yannickbock/dual_cr1750_cr1780_ct1740/hardware/cr-17xx-psu-board/pictures/01.jpg

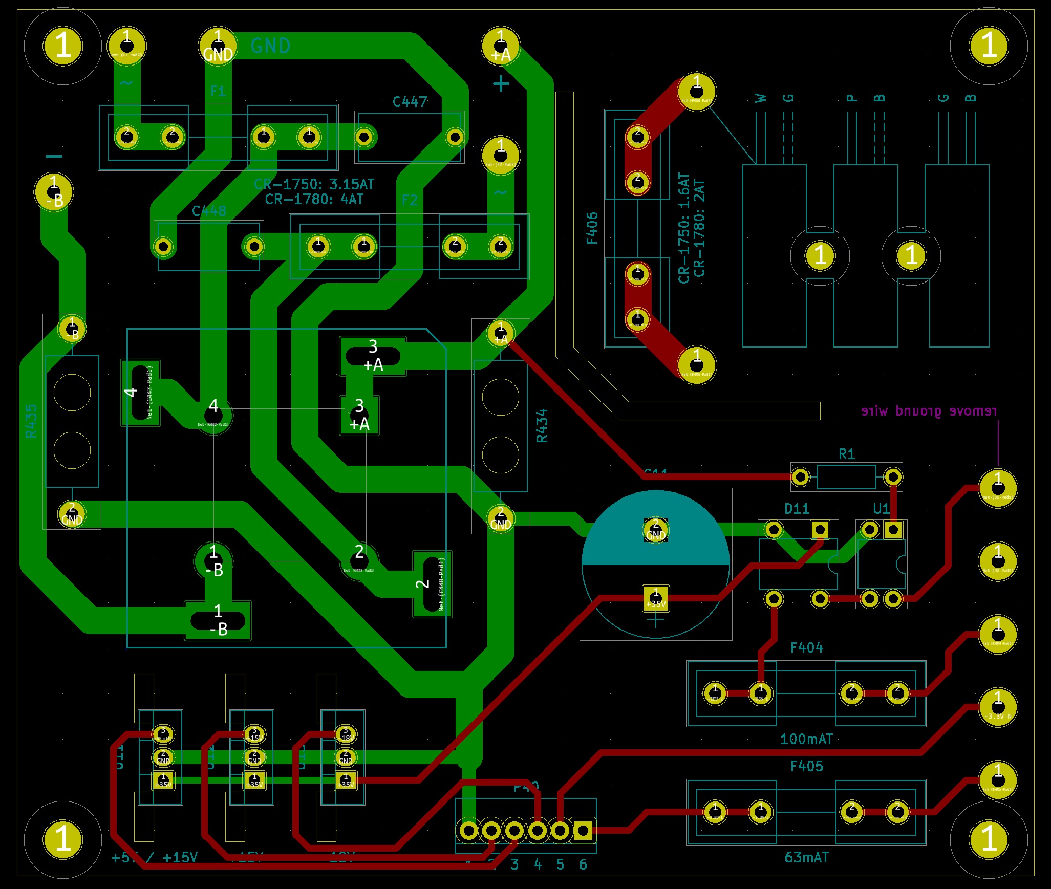
hardware/cr-17xx-psu-board/pictures/01.jpg
