yannickbock/dual_cr1750_cr1780_ct1740/hardware/ct-1740-psu-board/pictures/03.jpg

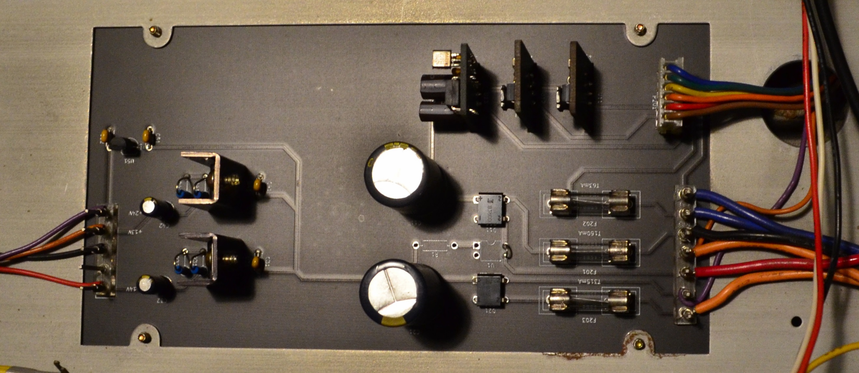
hardware/ct-1740-psu-board/pictures/03.jpg
