yannickbock/dual_cr1750_cr1780_ct1740/hardware/display-board/pictures/01.jpg

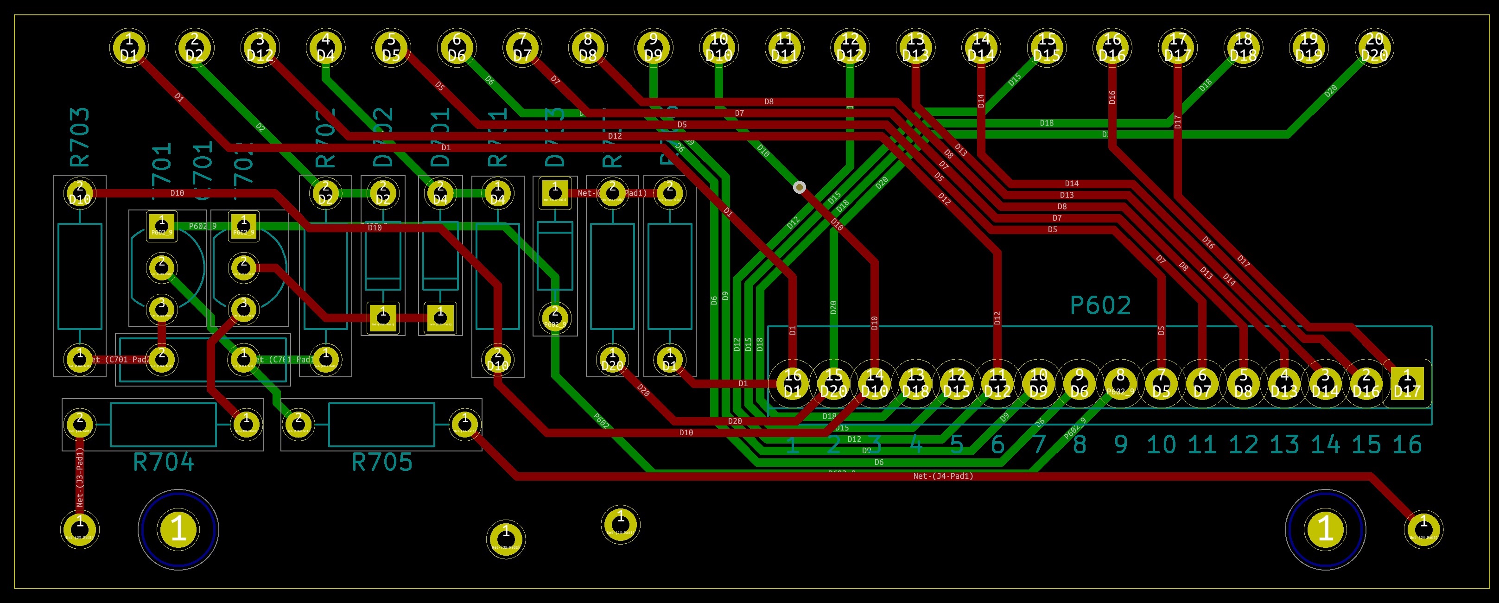
hardware/display-board/pictures/01.jpg
