yannickbock/dual_cr1750_cr1780_ct1740/hardware/psu-module-negative/pictures/02.jpg

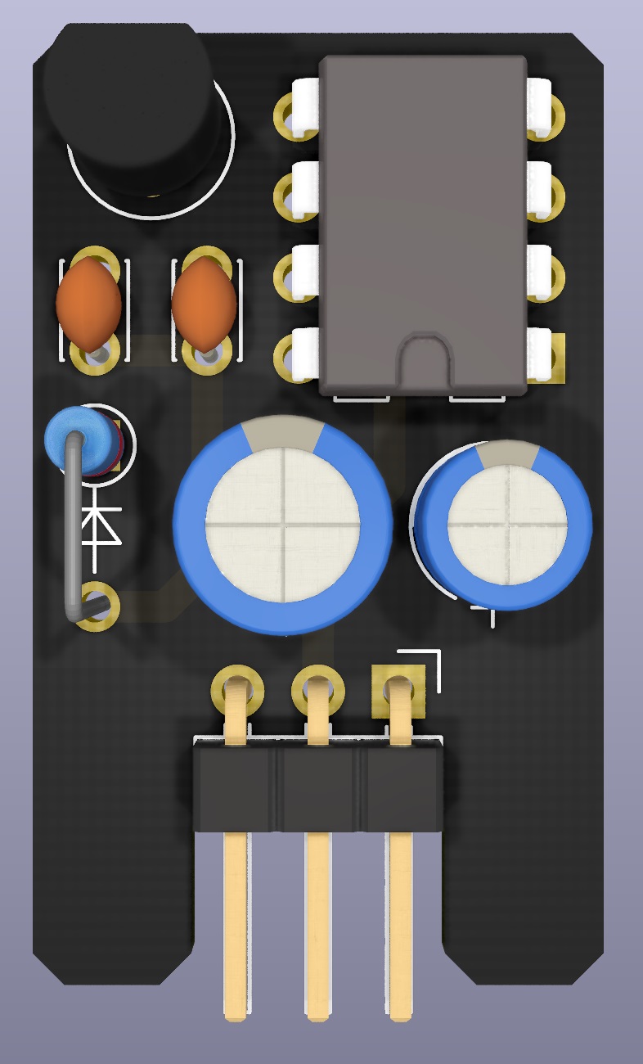
hardware/psu-module-negative/pictures/02.jpg
