yannickbock/dual_cr1750_cr1780_ct1740/hardware/psu-module-positive_BL9342/pictures/01.jpg

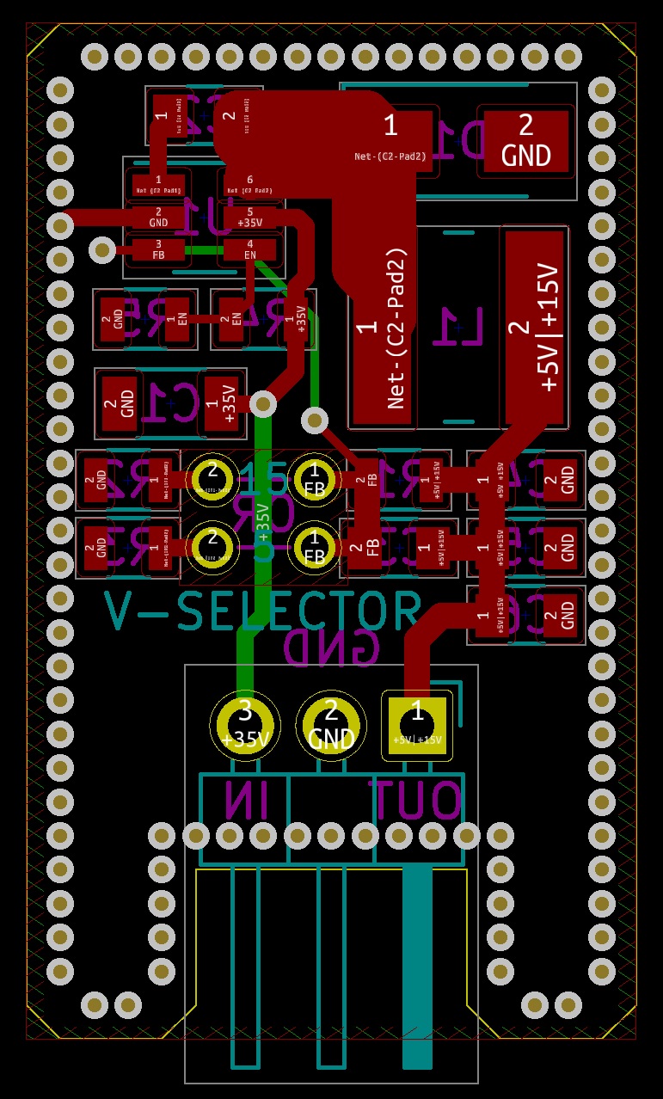
hardware/psu-module-positive_BL9342/pictures/01.jpg
