yannickbock/dual_cr1750_cr1780_ct1740/hardware/synthesizer-board/pictures/01.jpg

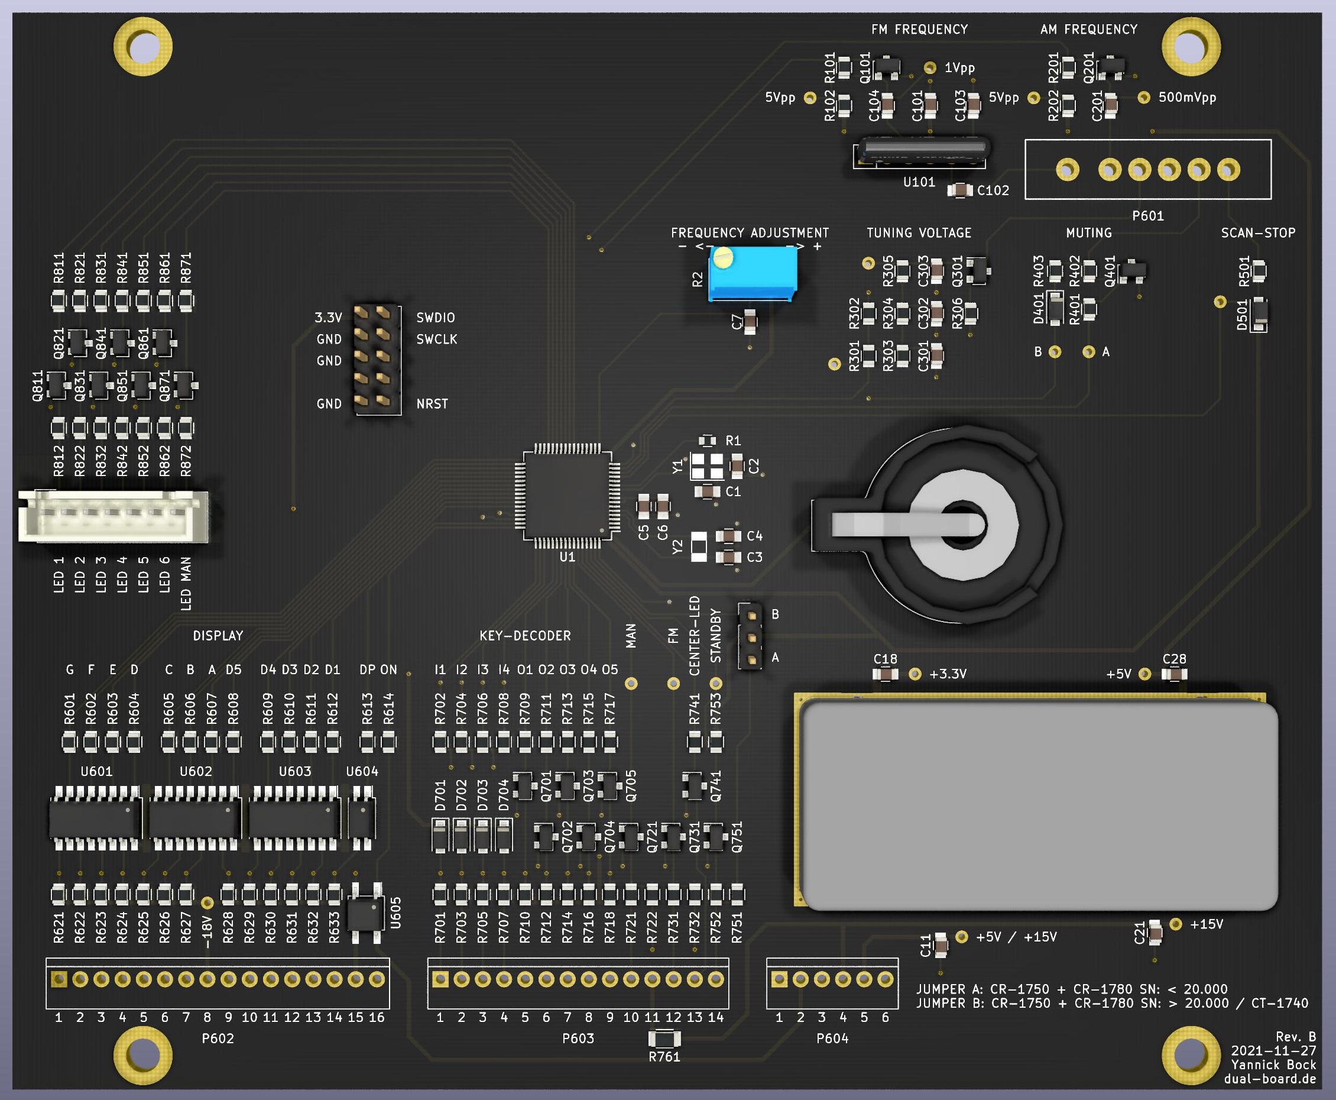
hardware/synthesizer-board/pictures/01.jpg
