yannickbock/dual_cr1750_cr1780_ct1740/hardware/cr-17xx-psu-preamp-board/User Library-Clips FH-100 with fuse 5x20.STEP

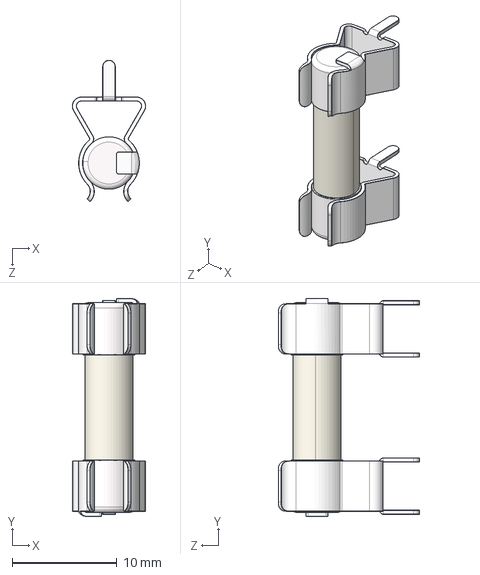
[picture p17: CAD file, 2022-03-17]
hardware/cr-17xx-psu-preamp-board/User Library-Clips FH-100 with fuse 5x20.STEP
7.00 x 20.8 x 13.5 mm
FH-100 x 2
5x20
