yannickbock/dual_cr1750_cr1780_ct1740/hardware/psu-module-negative/psu-module-negative.step

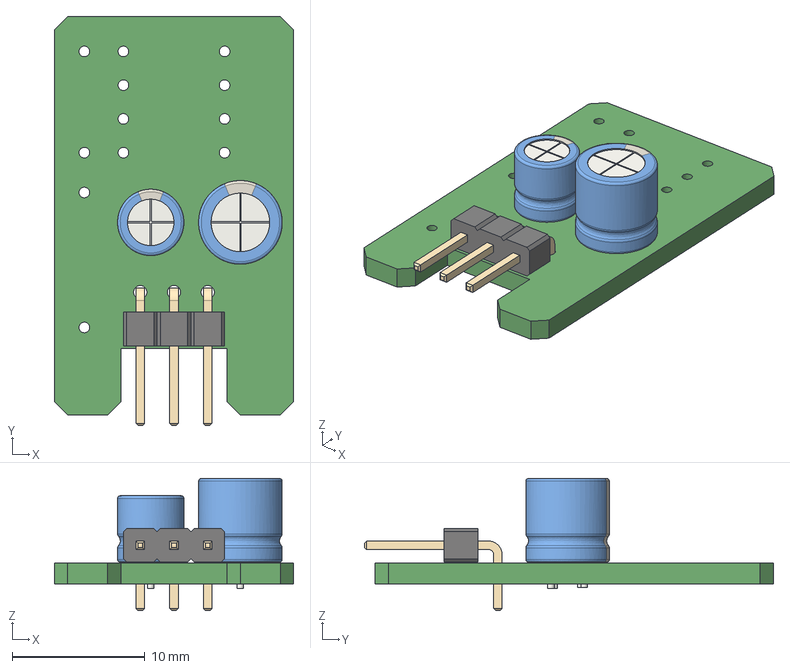
[picture p18: CAD file, 2021-11-16]
hardware/psu-module-negative/psu-module-negative.step
18.0 x 30.8 x 9.94 mm
D_DO-35_SOD27_P7.62mm_Horizontal
DIP-8_W7.62mm
R_Axial_DIN0207_L6.3mm_D2.5mm_P10.16mm_Horizontal
