yannickbock/dual_cr1750_cr1780_ct1740/hardware/psu-module-positive_BL9342/psu-module-positive.step

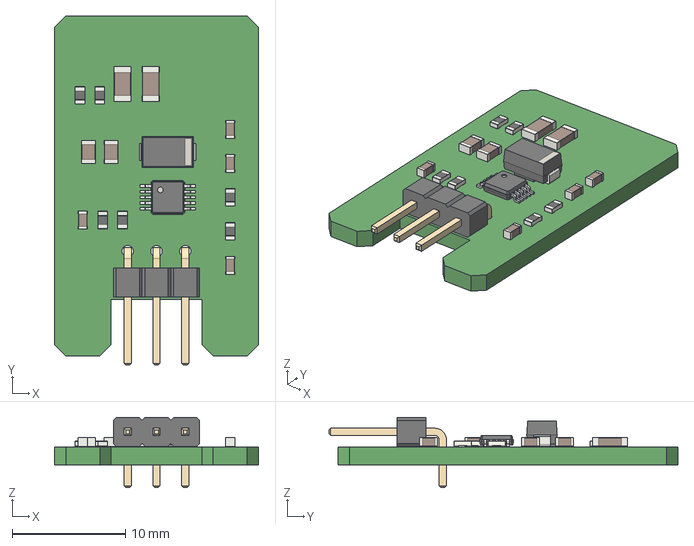
[picture p19: CAD file, 2021-11-16]
hardware/psu-module-positive_BL9342/psu-module-positive.step
18.0 x 30.8 x 6.18 mm
