yannickbock/dual_cr1750_cr1780_ct1740/hardware/synthesizer-board/bluetooth-board.step

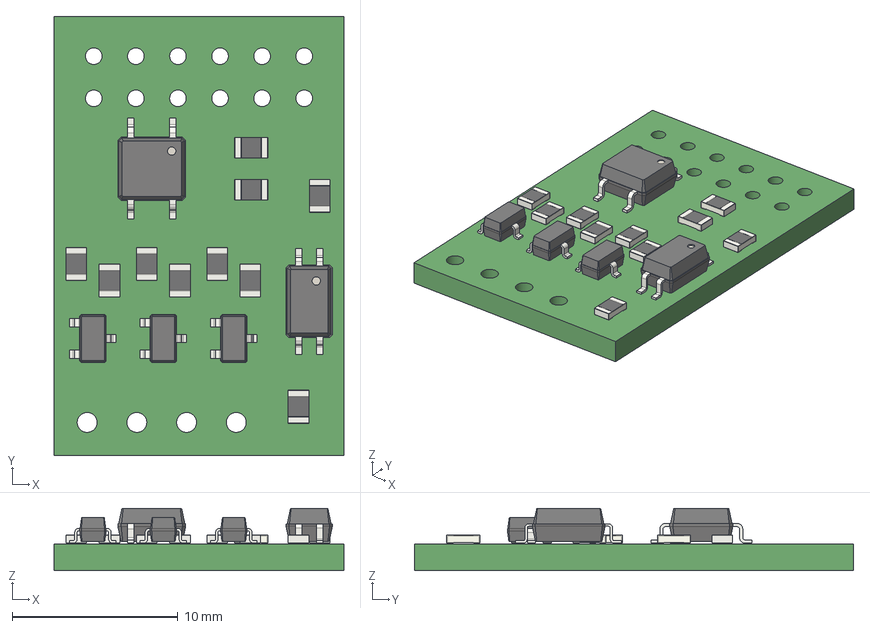
[picture p20: CAD file, 2022-03-17]
hardware/synthesizer-board/bluetooth-board.step
17.5 x 26.5 x 3.75 mm
Socket_Strip_Straight_2x06_Pitch2.54mm
