yannickbock/dual_cr1750_cr1780_ct1740/hardware/cr-17xx-psu-preamp-board/User Library-Custom standoff 1.STEP

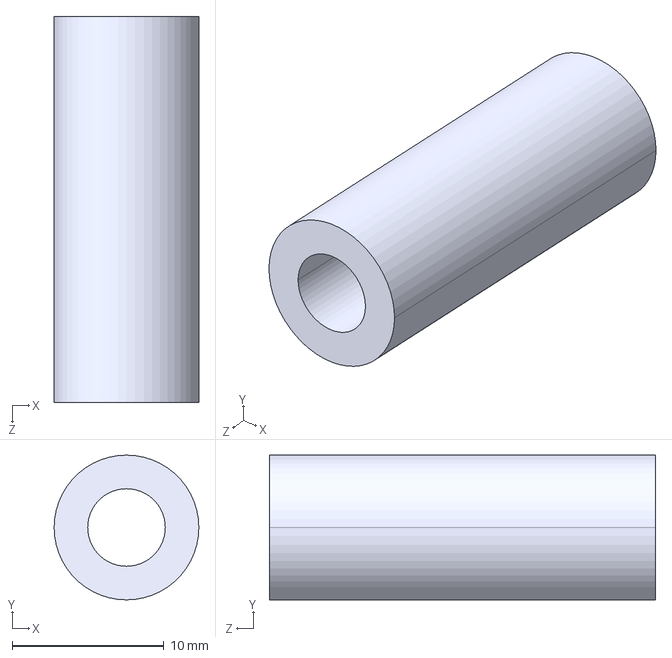
[picture p21: CAD file, 2022-03-17]
hardware/cr-17xx-psu-preamp-board/User Library-Custom standoff 1.STEP
9.52 x 9.52 x 25.4 mm
