yannickbock/dual_cr1750_cr1780_ct1740/hardware/synthesizer-board/MS544-10S.step

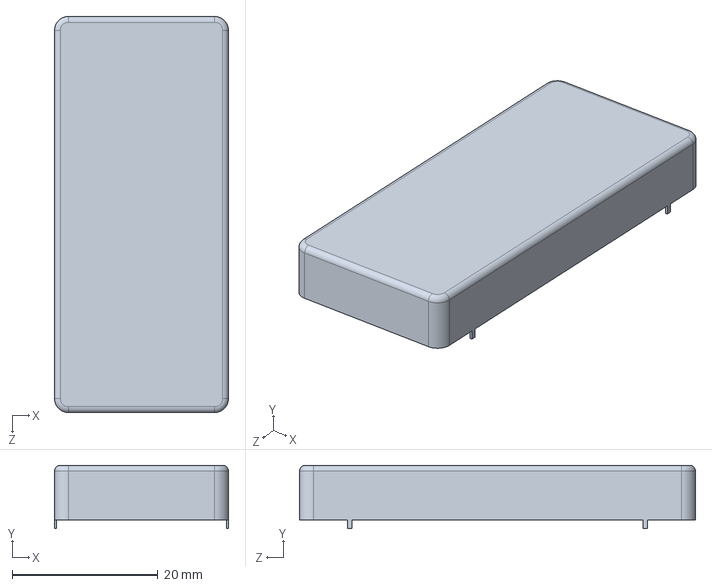
[picture p22: CAD file, 2021-12-21]
hardware/synthesizer-board/MS544-10S.step
23.9 x 8.70 x 54.4 mm
