yannickbock/dual_cr1750_cr1780_ct1740/manuals/netzteil_platine_ct1740.docx

Austausch der Netzteil-Platine

DUAL CT-1740

1. Original Platine ausbauen

Ein Stecker und zwei Wire-Wrap-Terminal müssen ausgelötet werden, danach die 4 Schrauben lösen und Platine rausnehmen.

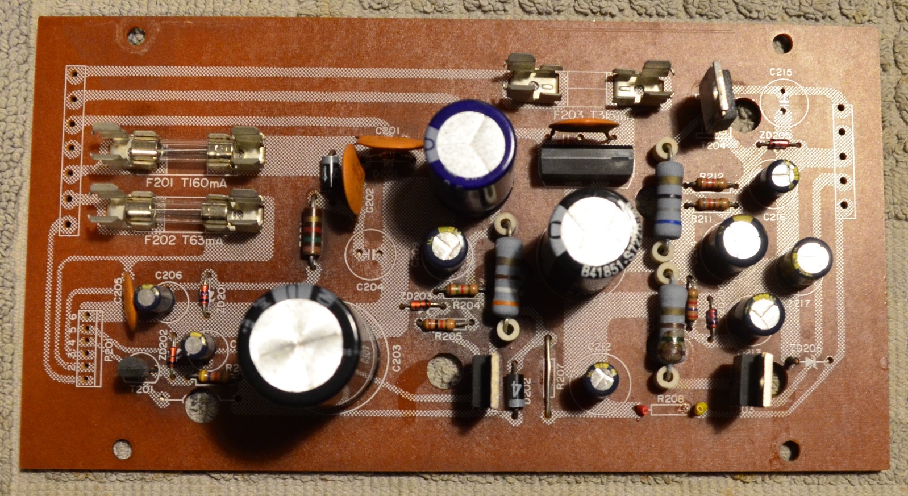
[picture p23: figure]

2. Spannungsregler einlöten

Die beiden Kühlkörper von der Original-Platine übernehmen und anschließend die Spannungsregler einlöten.

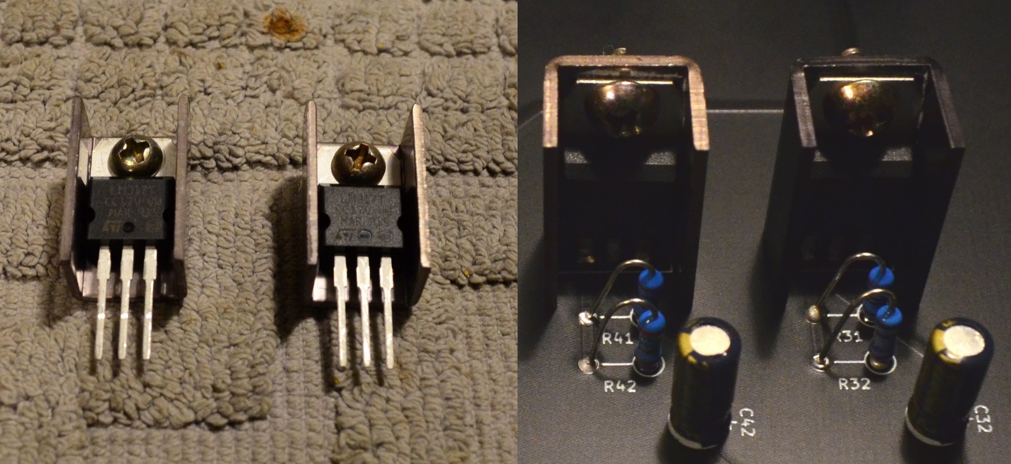
[picture p24: figure]

3. Neue Platine einbauen

Die 4 Schrauben anziehen, anschließend den Stecker und die beiden Wire-Wrap-Terminals einlöten.

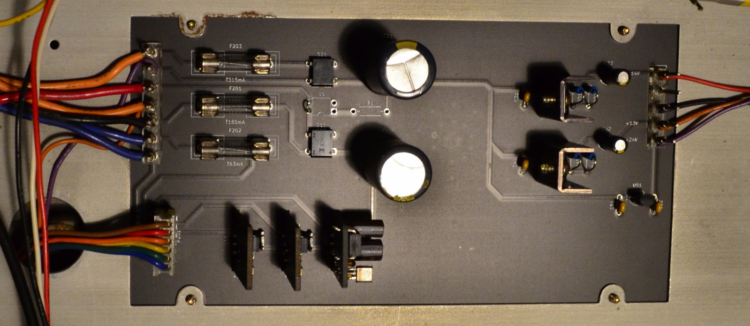
[picture p25: figure]

Yannick Bock / 20.12.2021 / dual-board.de
