yannickbock/dual_cr1750_cr1780_ct1740/manuals/netzteil_platine_cr17x0.pdf

# Austausch der Netzteil-Platine

# DUAL CR-1750 / CR-1780

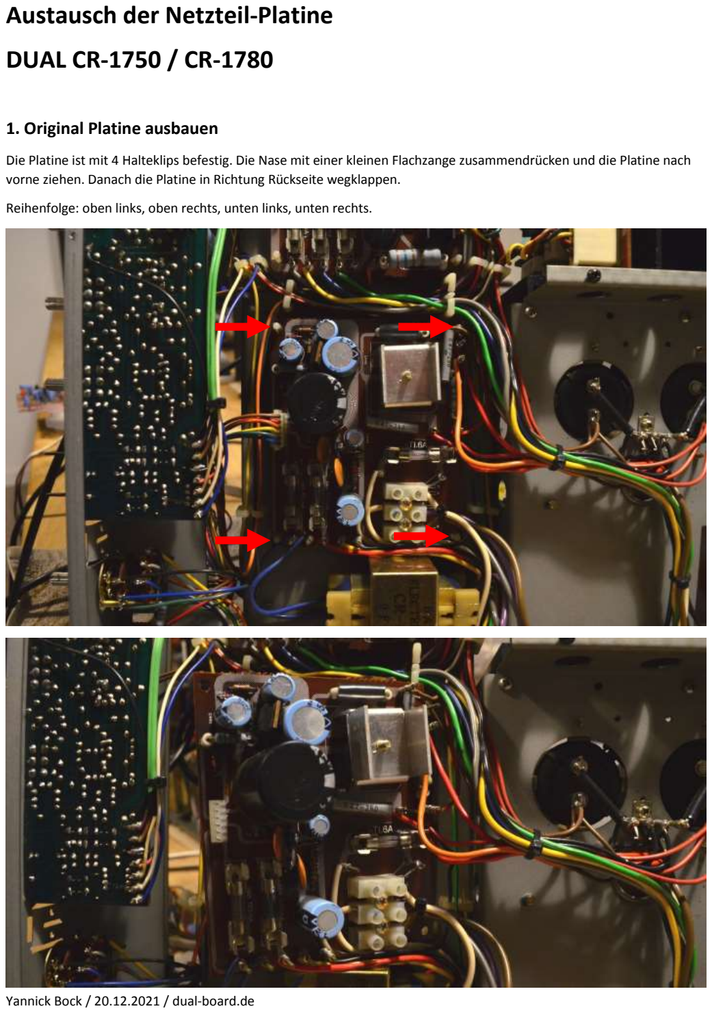
[picture p26: page 1]

Yannick Bock / 20.12.2021 / dual-board.de

### 1. Original Platine ausbauen

Die Platine ist mit 4 Halteklips befestig. Die Nase mit einer kleinen Flachzange zusammendrücken und die Platine nach vorne ziehen. Danach die Platine in Richtung Rückseite wegklappen.

Reihenfolge: oben links, oben rechts, unten links, unten rechts.

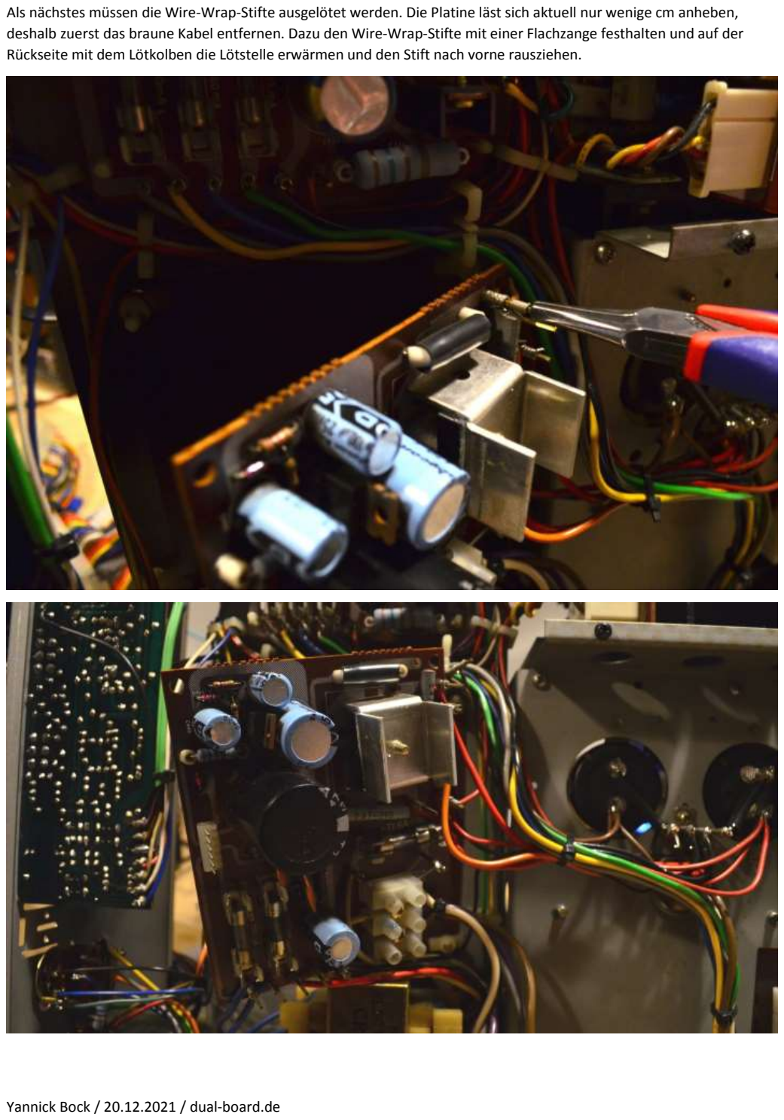
[picture p27: page 2]

Als nächstes müssen die Wire-Wrap-Stifte ausgelötet werden. Die Platine läst sich aktuell nur wenige cm anheben, deshalb zuerst das braune Kabel entfernen. Dazu den Wire-Wrap-Stifte mit einer Flachzange festhalten und auf der Rückseite mit dem Lötkolben die Lötstelle erwärmen und den Stift nach vorne rausziehen.

Die 4 restlichen Wire-Wrap-Stifte neben dem Gleichrichter auslöten. Die Platine läst sich jetzt nach unten wegklappen. Danach die 5 Wire-Wrap-Stifte überhalb des Trafos sowie den Wire-Wrap-Stift links neben der Lüsterklemme auslöten.

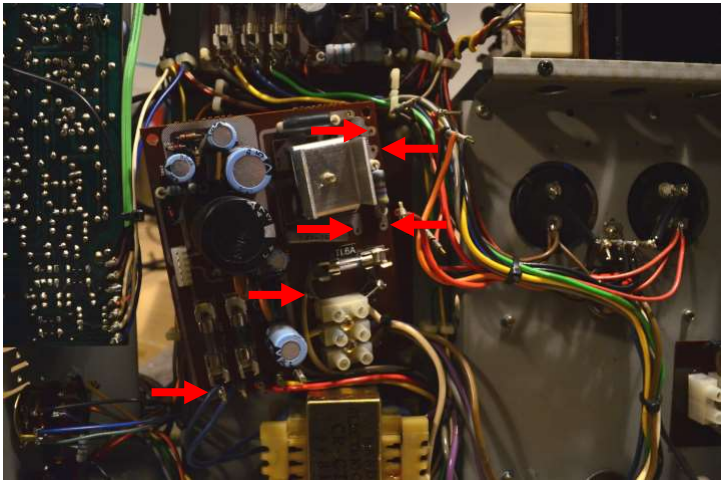
[picture p28: figure]
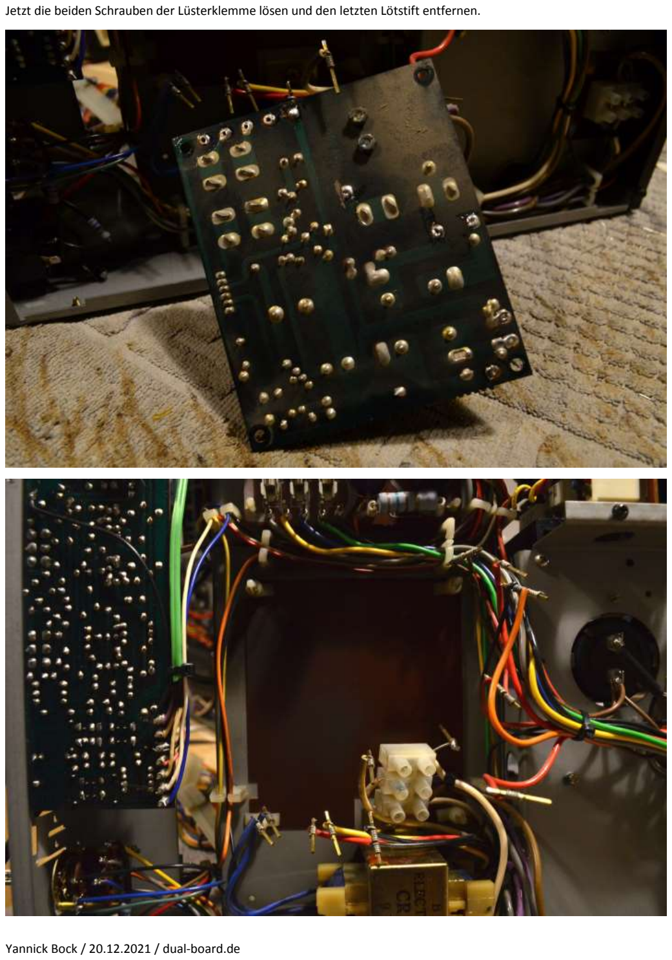
[picture p29: page 4]

Jetzt die beiden Schrauben der Lüsterklemme lösen und den letzten Lötstift entfernen.

### 2. Masseverbindung entfernen

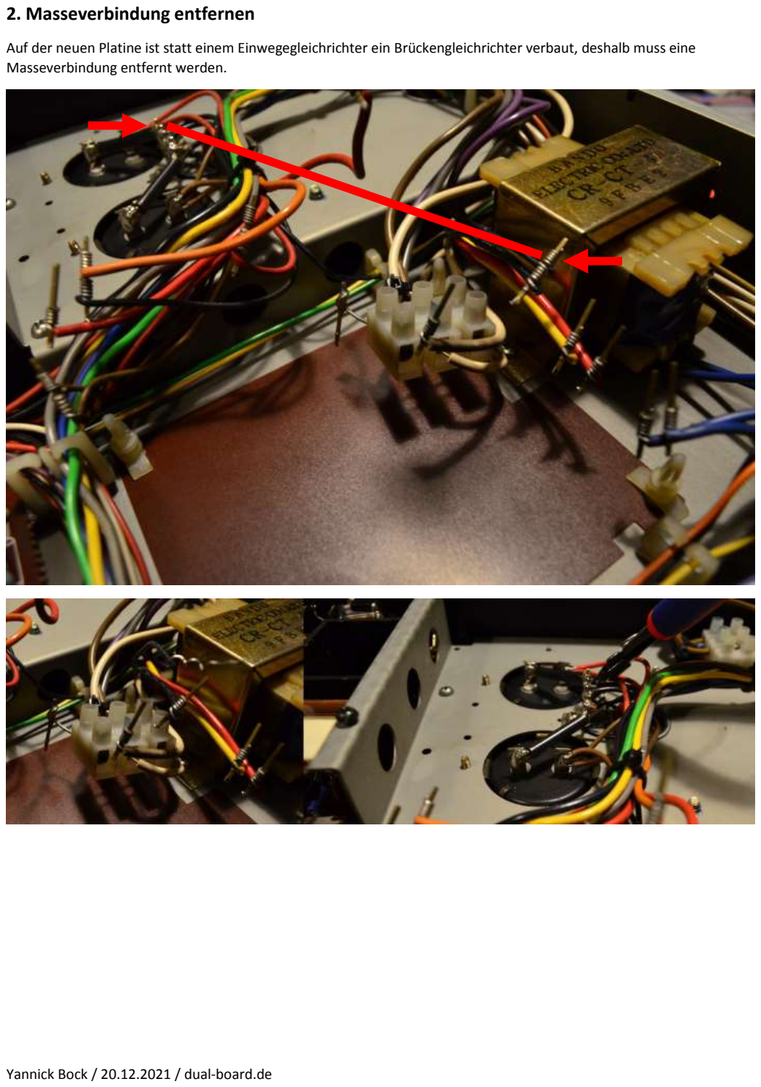
[picture p30: page 5]

Auf der neuen Platine ist statt einem Einwegegleichrichter ein Brückengleichrichter verbaut, deshalb muss eine Masseverbindung entfernt werden.

### 3. Bauteile übernehmen

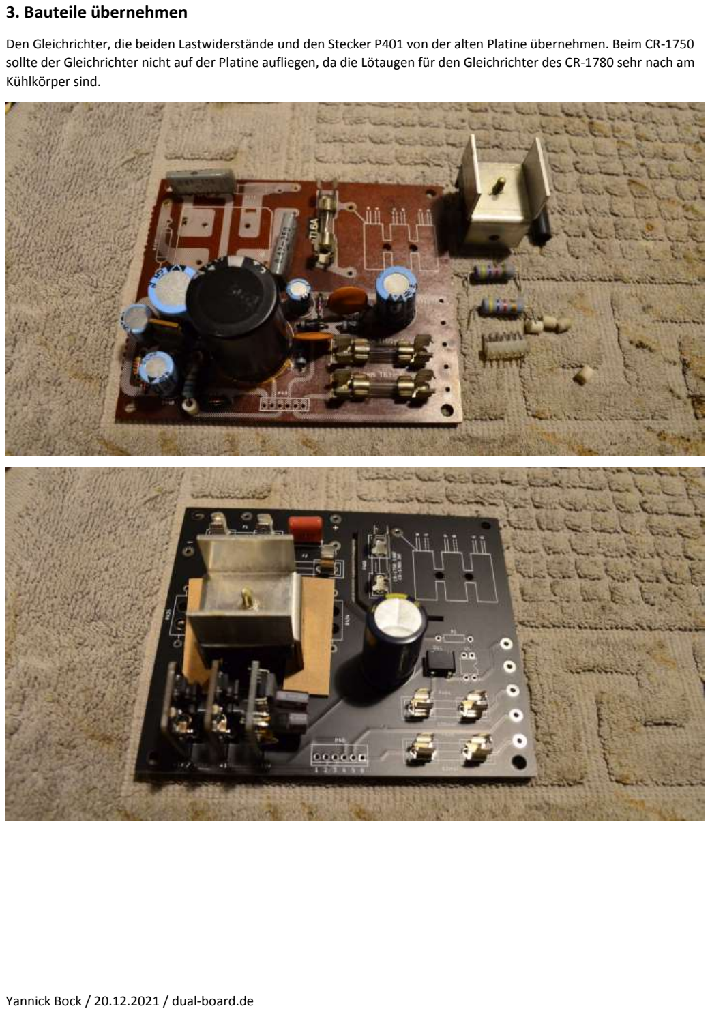
[picture p31: page 6]

Den Gleichrichter, die beiden Lastwiderstände und den Stecker P401 von der alten Platine übernehmen. Beim CR-1750 sollte der Gleichrichter nicht auf der Platine aufliegen, da die Lötaugen für den Gleichrichter des CR-1780 sehr nach am Kühlkörper sind.

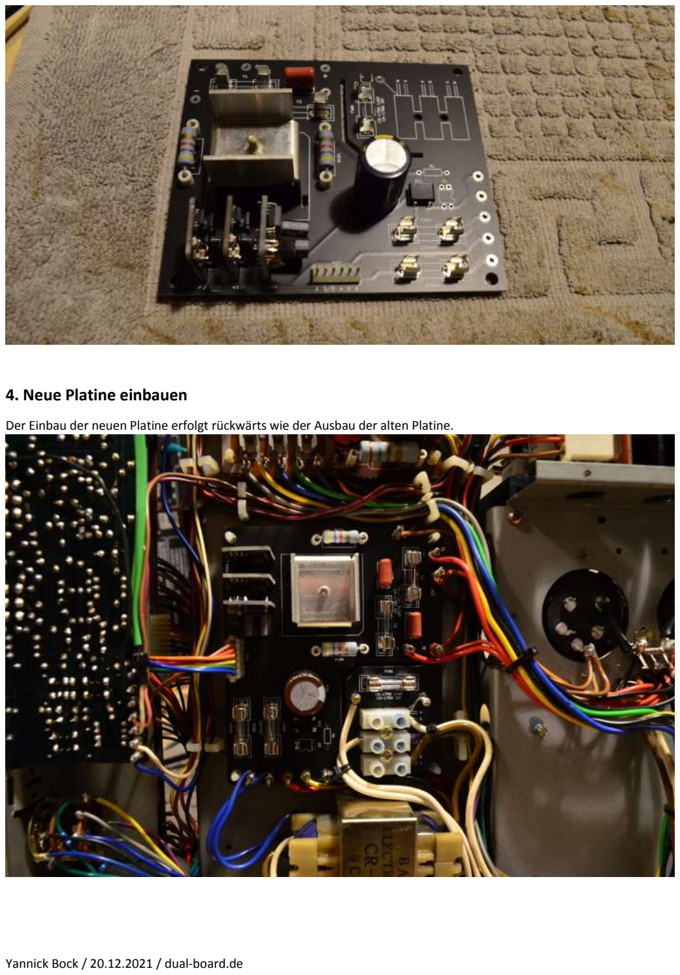
[picture p32: page 7]

### 4. Neue Platine einbauen

Der Einbau der neuen Platine erfolgt rückwärts wie der Ausbau der alten Platine.
