yannickbock/dual_cr1750_cr1780_ct1740/manuals/display_platine.docx

Austausch der Display-Platine

DUAL CR-1750 / CR-1780 / CT-1740

1. Stecker abziehen

5 Stecker müssen abgezogen werden, bei den beiden linken Steckern sind Schnapp-Nasen vorhanden.

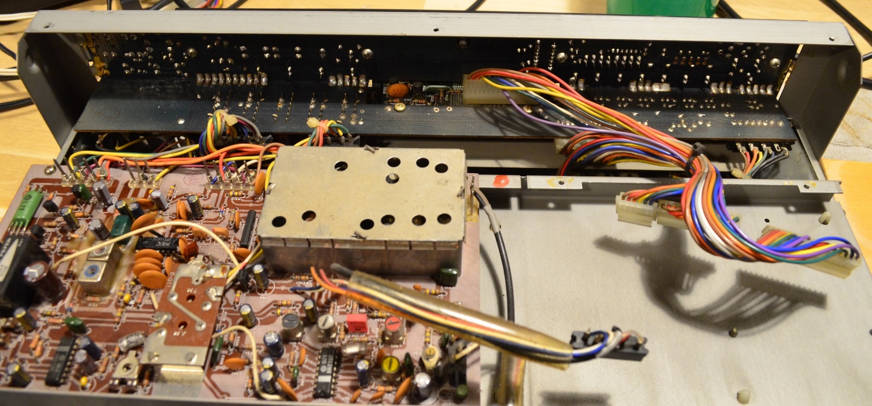
[picture p43: figure]

2. Bedieneinheit ausbauen

4 Schrauben lösen, dann komplette Einheit nach links-vorne rausziehen.

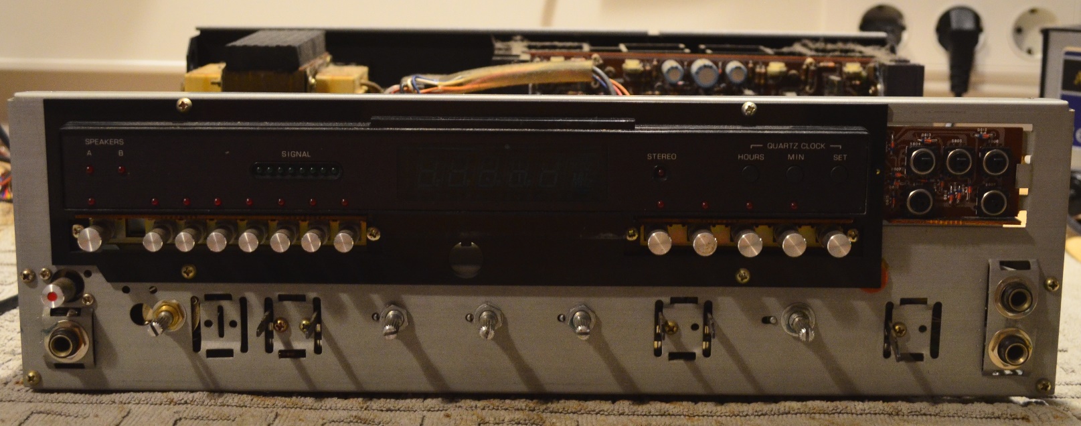
[picture p44: figure]

3. Kunstoffblende entfernen

4 Schrauben auf der Rückseite

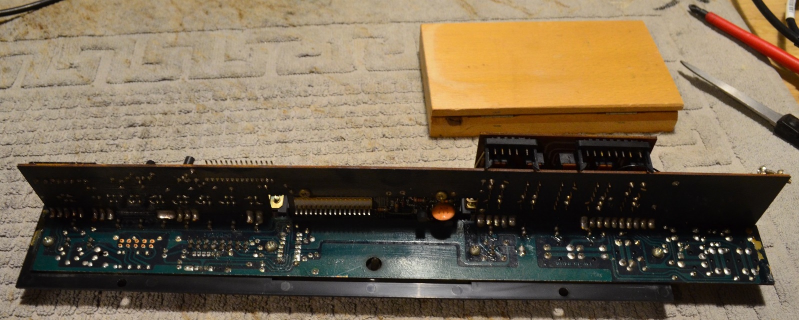
[picture p45: figure]

4 Schrauben auf der Vorderseite

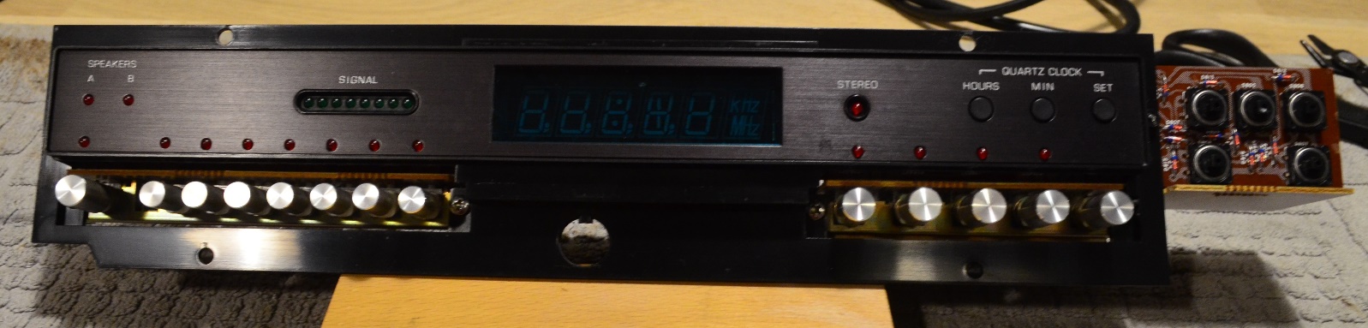
[picture p46: figure]

4. Display-Platine ausbauen

2 Schrauben und 2 bzw. 4 Lötverbindungen lösen, Platine nach vorne rausnehmen

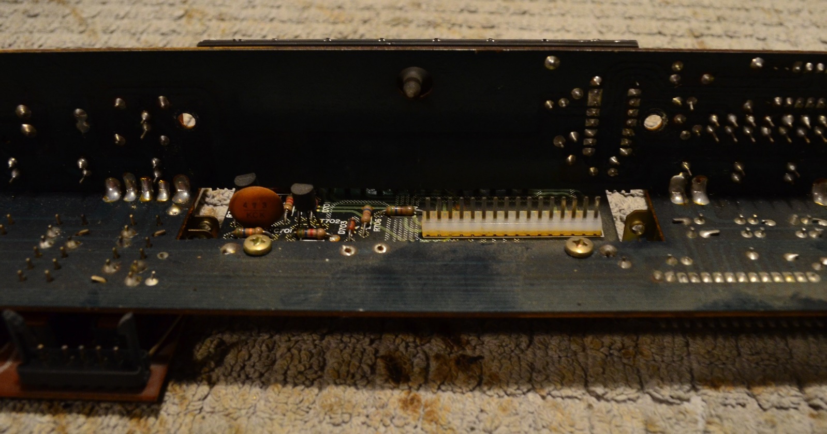
[picture p47: figure]

5. Bauteile auf neue Platine übernehmen

1. Display auslöten. Achtung: Nicht minutenlang an einem Pin rumbraten!

2. Stecker, Keramik-Kondensator und Transistoren auslöten

3. Widerstände und Dioden nacheinander auslöten und auf der neuen Platine einlöten

4. Stecker, Keramik-Kondensator, Transistoren und Display einlöten.

Tipp: Stecker vorher mit Brennspiritus und Zahnbürste reinigen, danach mit Wasser abspülen und trocknen lassen.

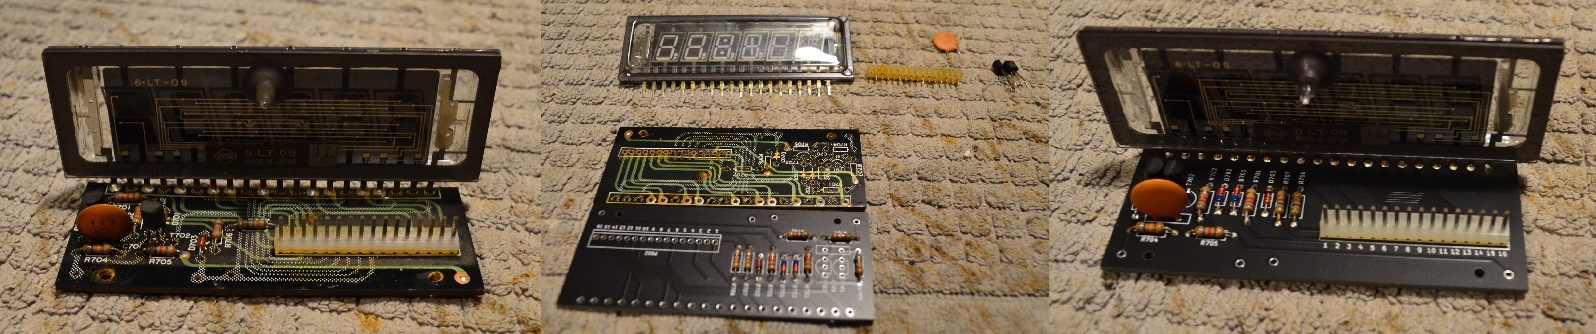
[picture p48: figure]

6. Display-Platine einbauen

Zuerst die beiden Schrauben handfest anziehen, dann die beiden Lötverbindungen neben den Schrauben wiederherstellen.

Tipp: Die beiden großen zusammengelöteten Platinen mit Brennspiritus und Zahnbürste reinigen, danach mit Wasser abspülen und trocknen lassen. Evtl. mehrfach wiederholen. Papierabstandshalter vorher entfernen, eine LED muss dazu ausgelötet werden.

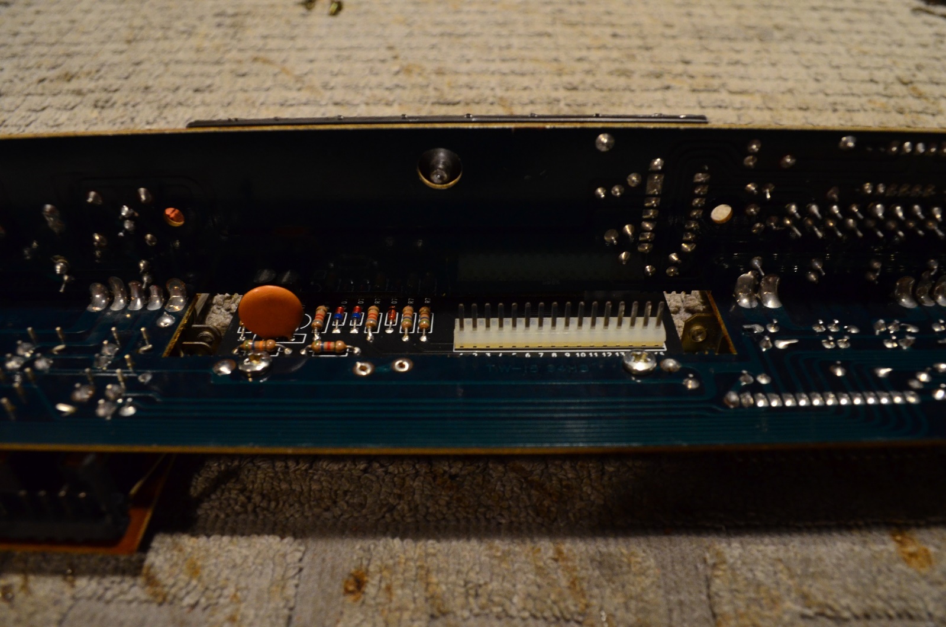
[picture p49: figure]

7. Kunstoffblende zusammenbauen

4 Schrauben auf der Vorderseite. Achtung: Unbedingt zuerst diese Schrauben, sonst schleifen die Schalter nachher!

4 Schrauben auf der Rückseite.

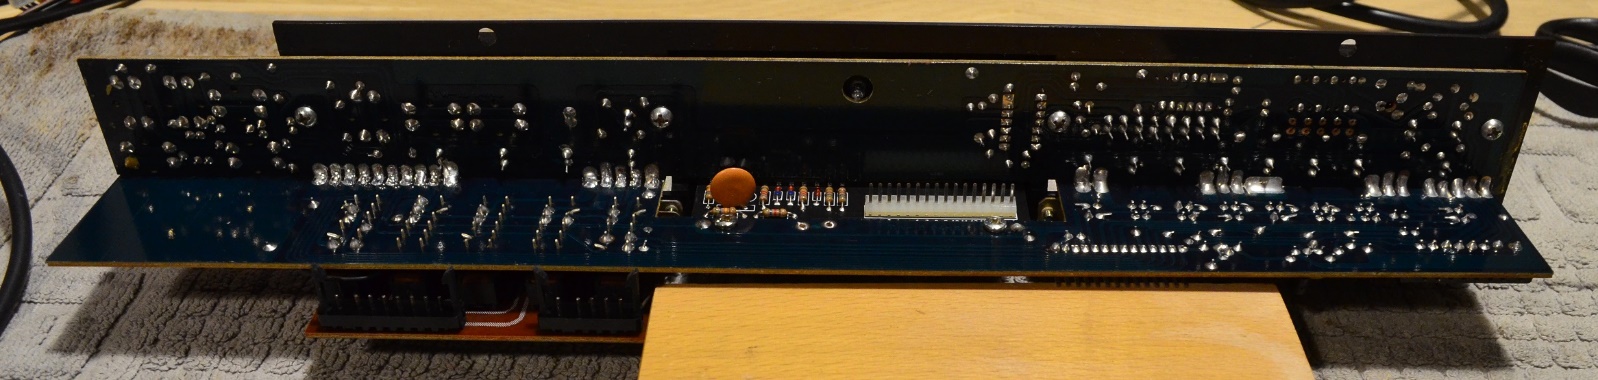
[picture p50: figure]

8. Bedieneinheit einbauen

Achtung: Schrauben nur leicht anziehen, sonst läst sich die Frontblende nicht montieren!

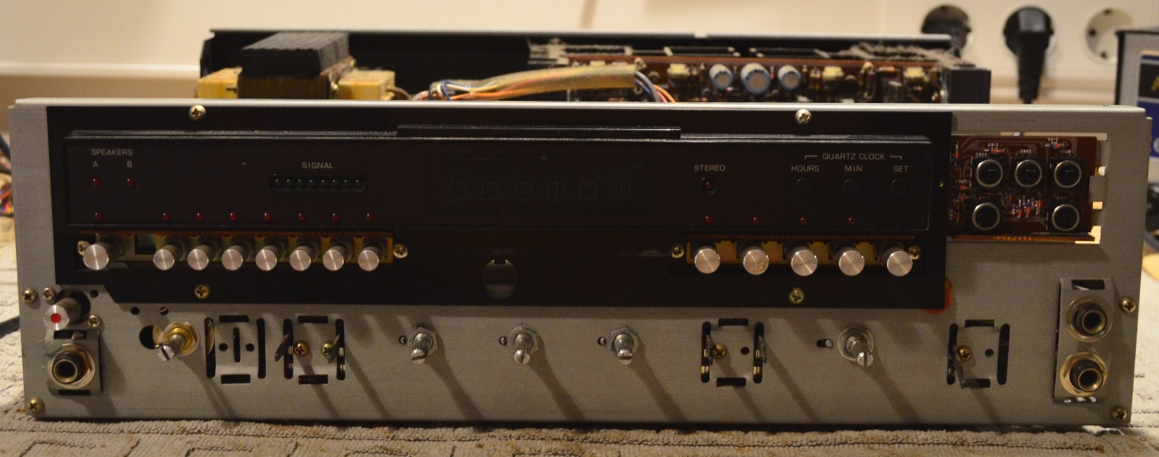
[picture p51: figure]

9. Schaumstoff ersetzen

Der Schaumstoff hinter den SCAN und TUNING Tasten ist in der Regel zerbröselt und sollte ersetzt werden.

Tipp: 4 mm starker selbstklebender Filz

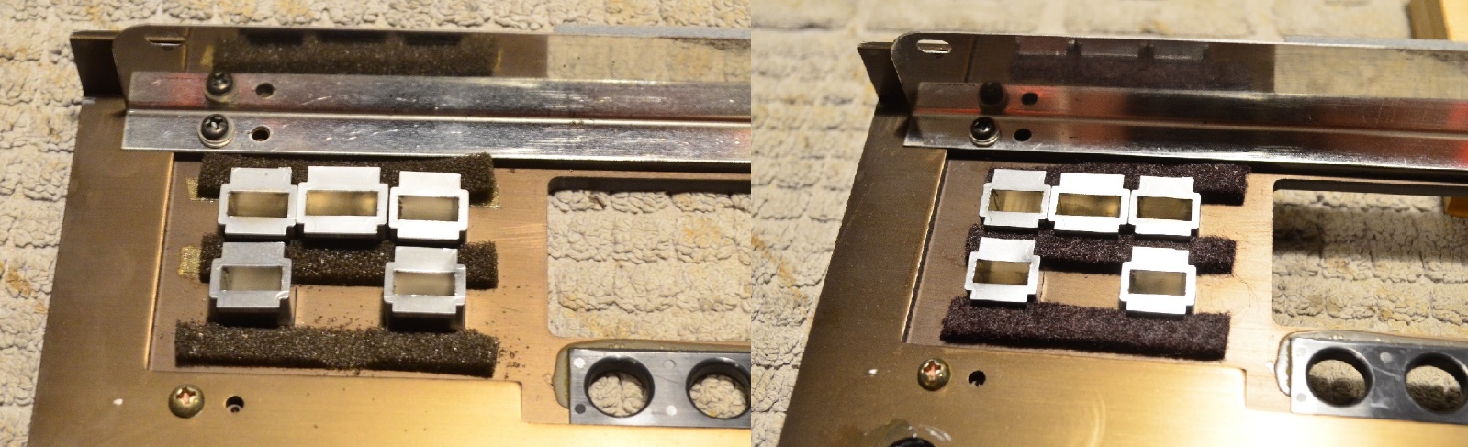
[picture p52: figure]

Yannick Bock / 19.12.2021 / dual-board.de
