yannickbock/dual_cr1750_cr1780_ct1740/hardware/cr-17xx-psu-board/schematic.pdf

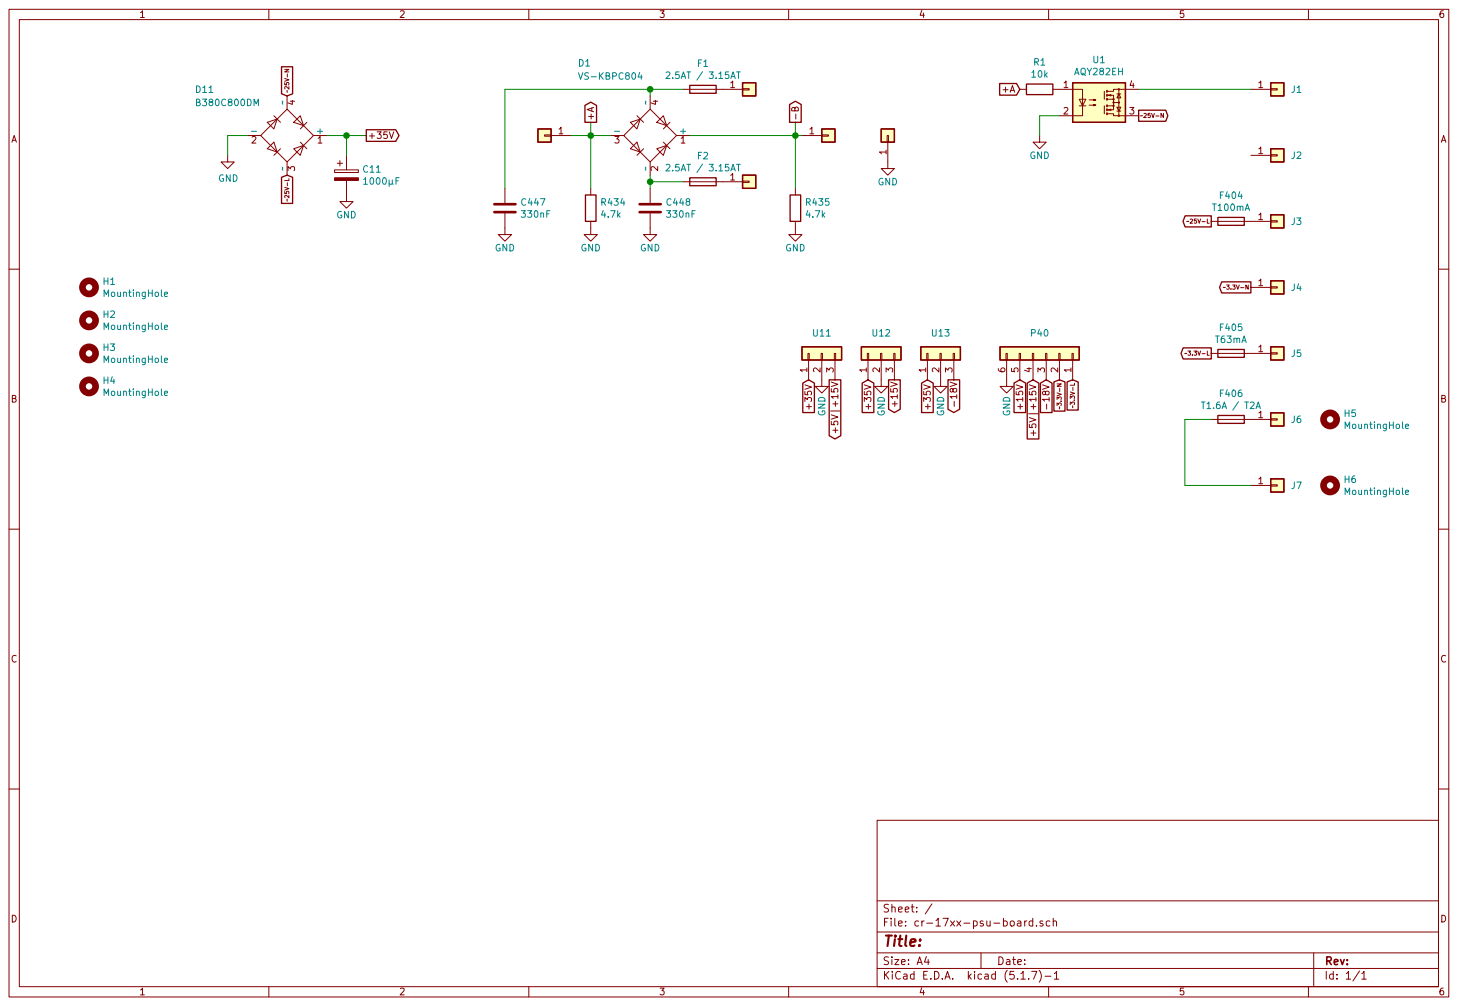
[picture p53: page 1]

File: cr-17xx-psu-board.sch Sheet: /
Id: 1/1 Title:
