yannickbock/dual_cr1750_cr1780_ct1740/hardware/ct-1740-psu-board/schematic.pdf

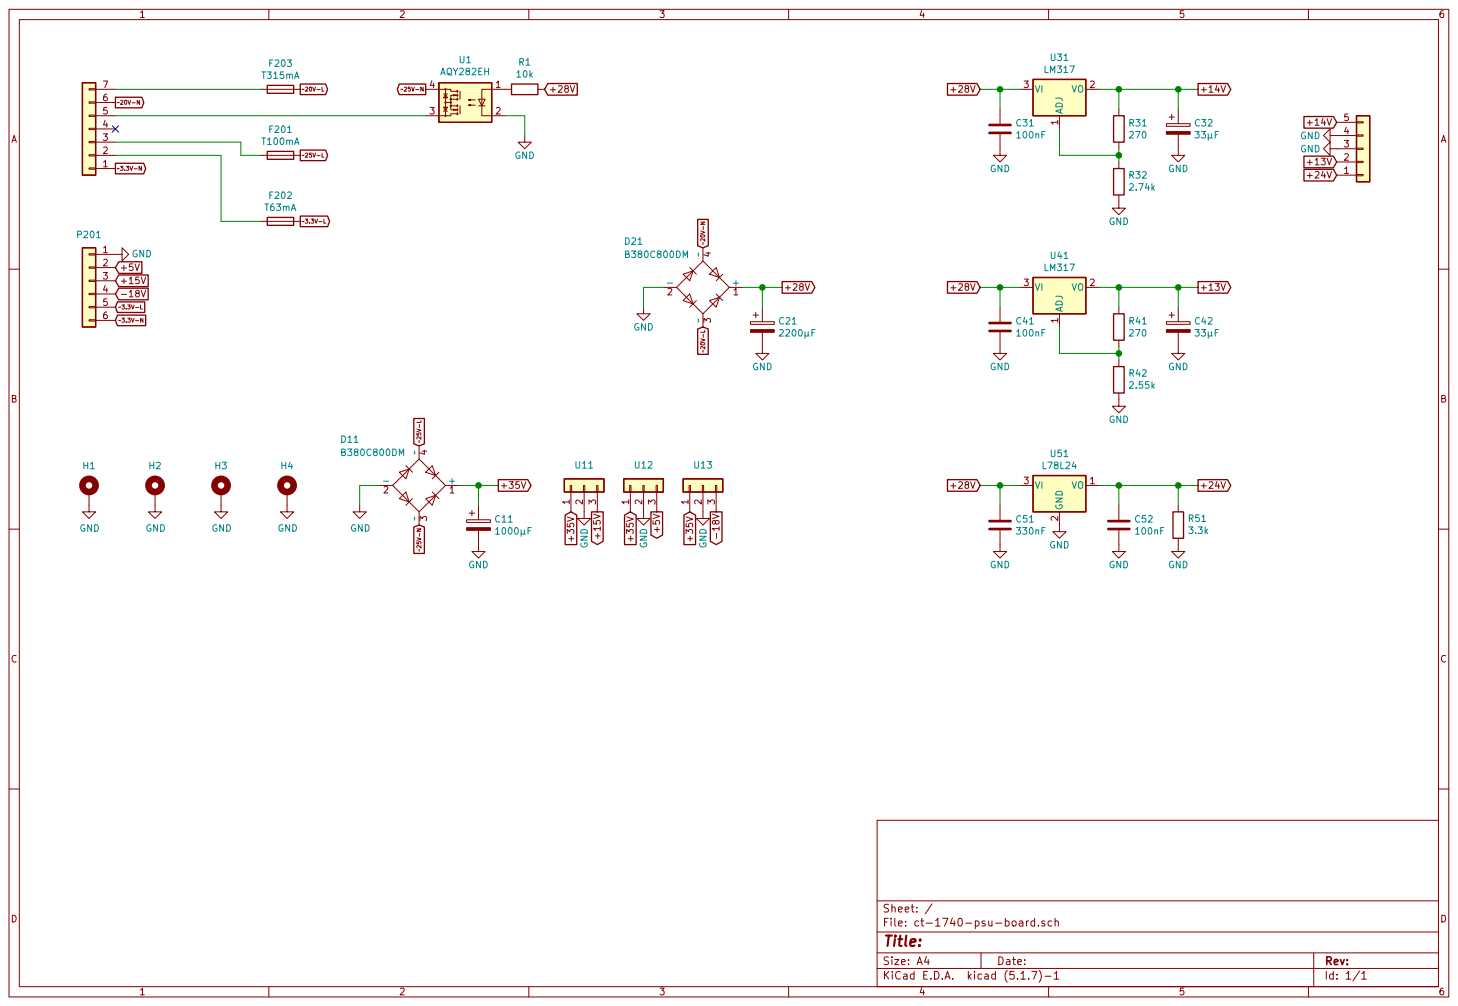
[picture p54: page 1]

File: ct-1740-psu-board.sch Sheet: /
Id: 1/1 Title:
