yannickbock/dual_cr1750_cr1780_ct1740/hardware/psu-module-negative/schematic.pdf

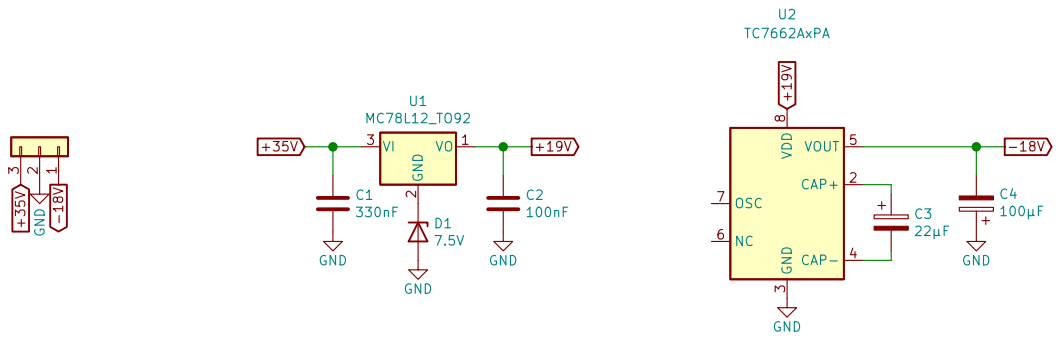
[picture p55: page 1]

3 CAP- 4 VOUT 5 NC 6 OSC 7 VDD

File: psu-module-negative.sch Sheet: / GND
