yannickbock/dual_cr1750_cr1780_ct1740/hardware/synthesizer-board/schematic.pdf

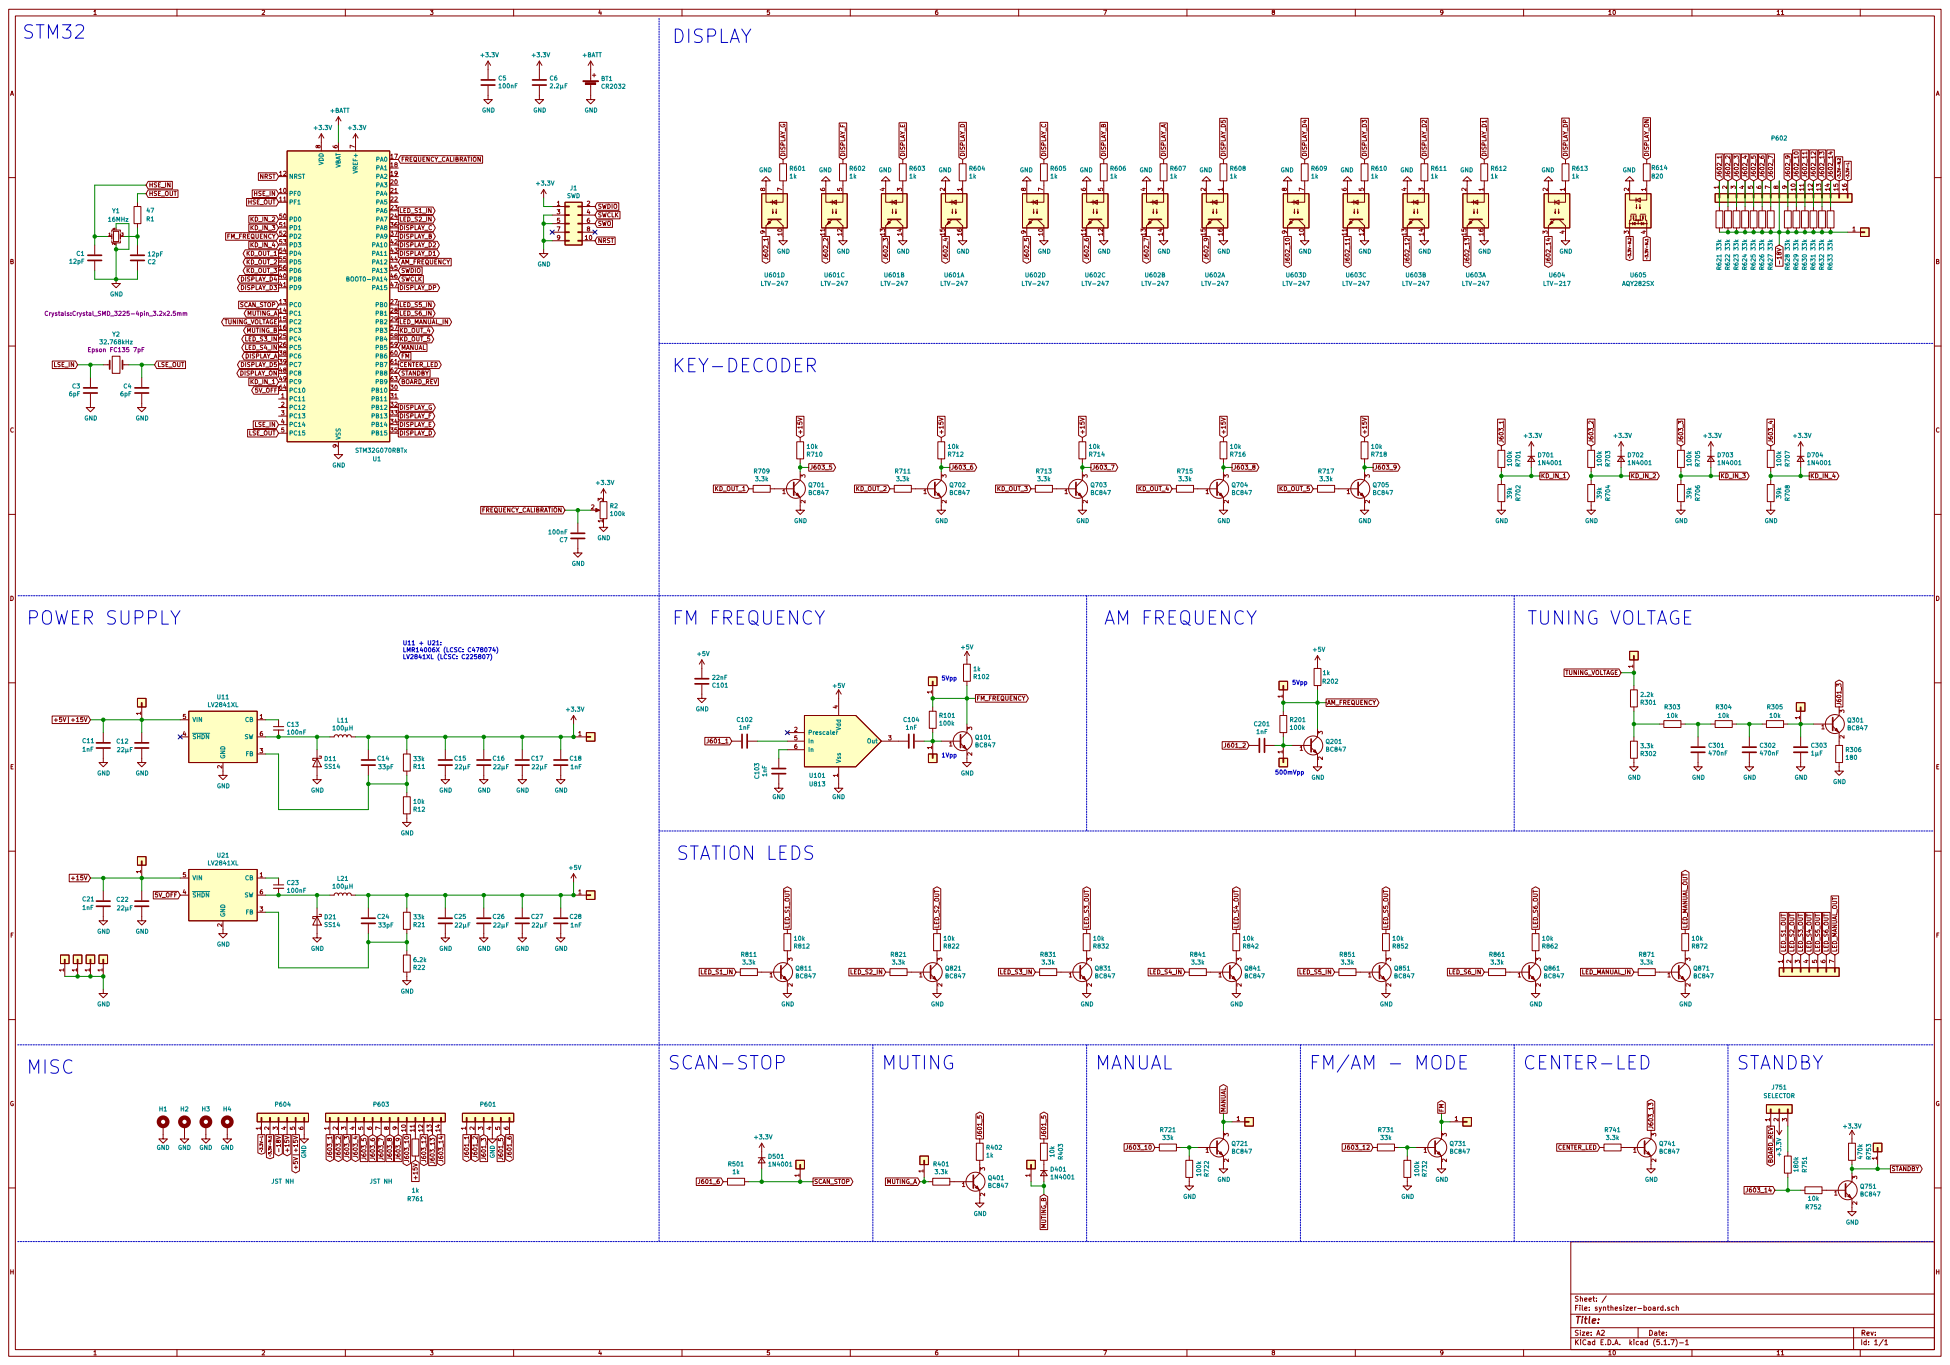
[picture p56: page 1]

7 9 | 8

2 FB 3 SHDN 4 VIN 5 SW 6 U11

2 FB 3 SHDN 4 VIN 5 SW 6 U21

File: synthesizer-board.sch Sheet: /
