yannickbock/dual_cr1750_cr1780_ct1740/hardware/display-board/schematic.pdf

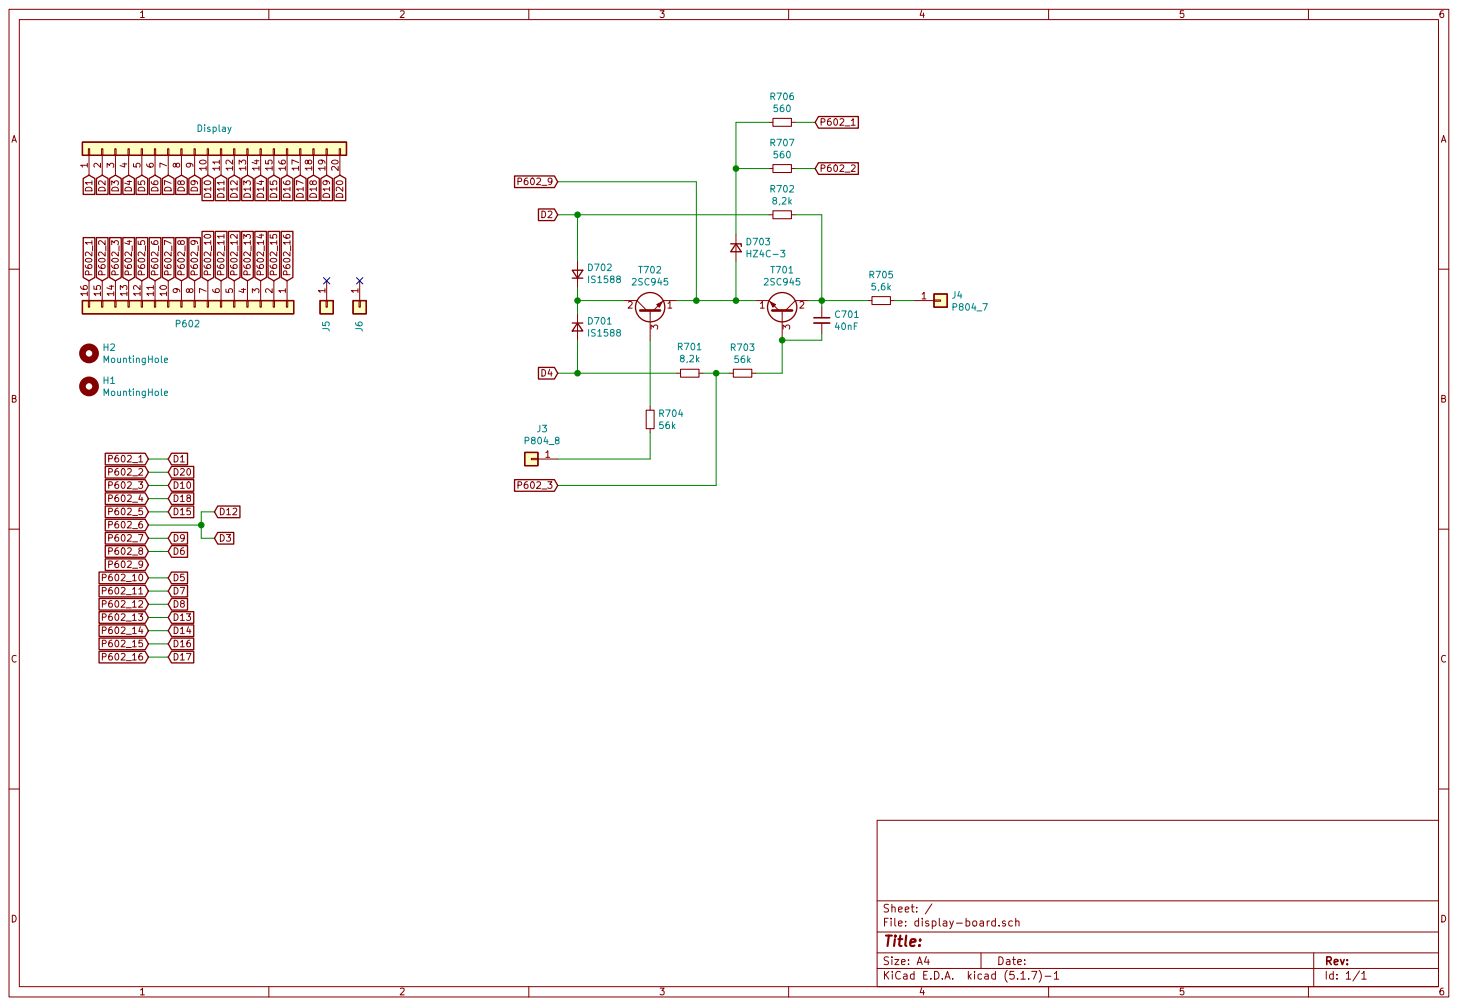
[picture p57: page 1]

File: display-board.sch Sheet: /
Id: 1/1 Title:
