yannickbock/dual_cr1750_cr1780_ct1740/hardware/cr-17xx-psu-preamp-board/cr-17xx-psu-preamp-board.pdf

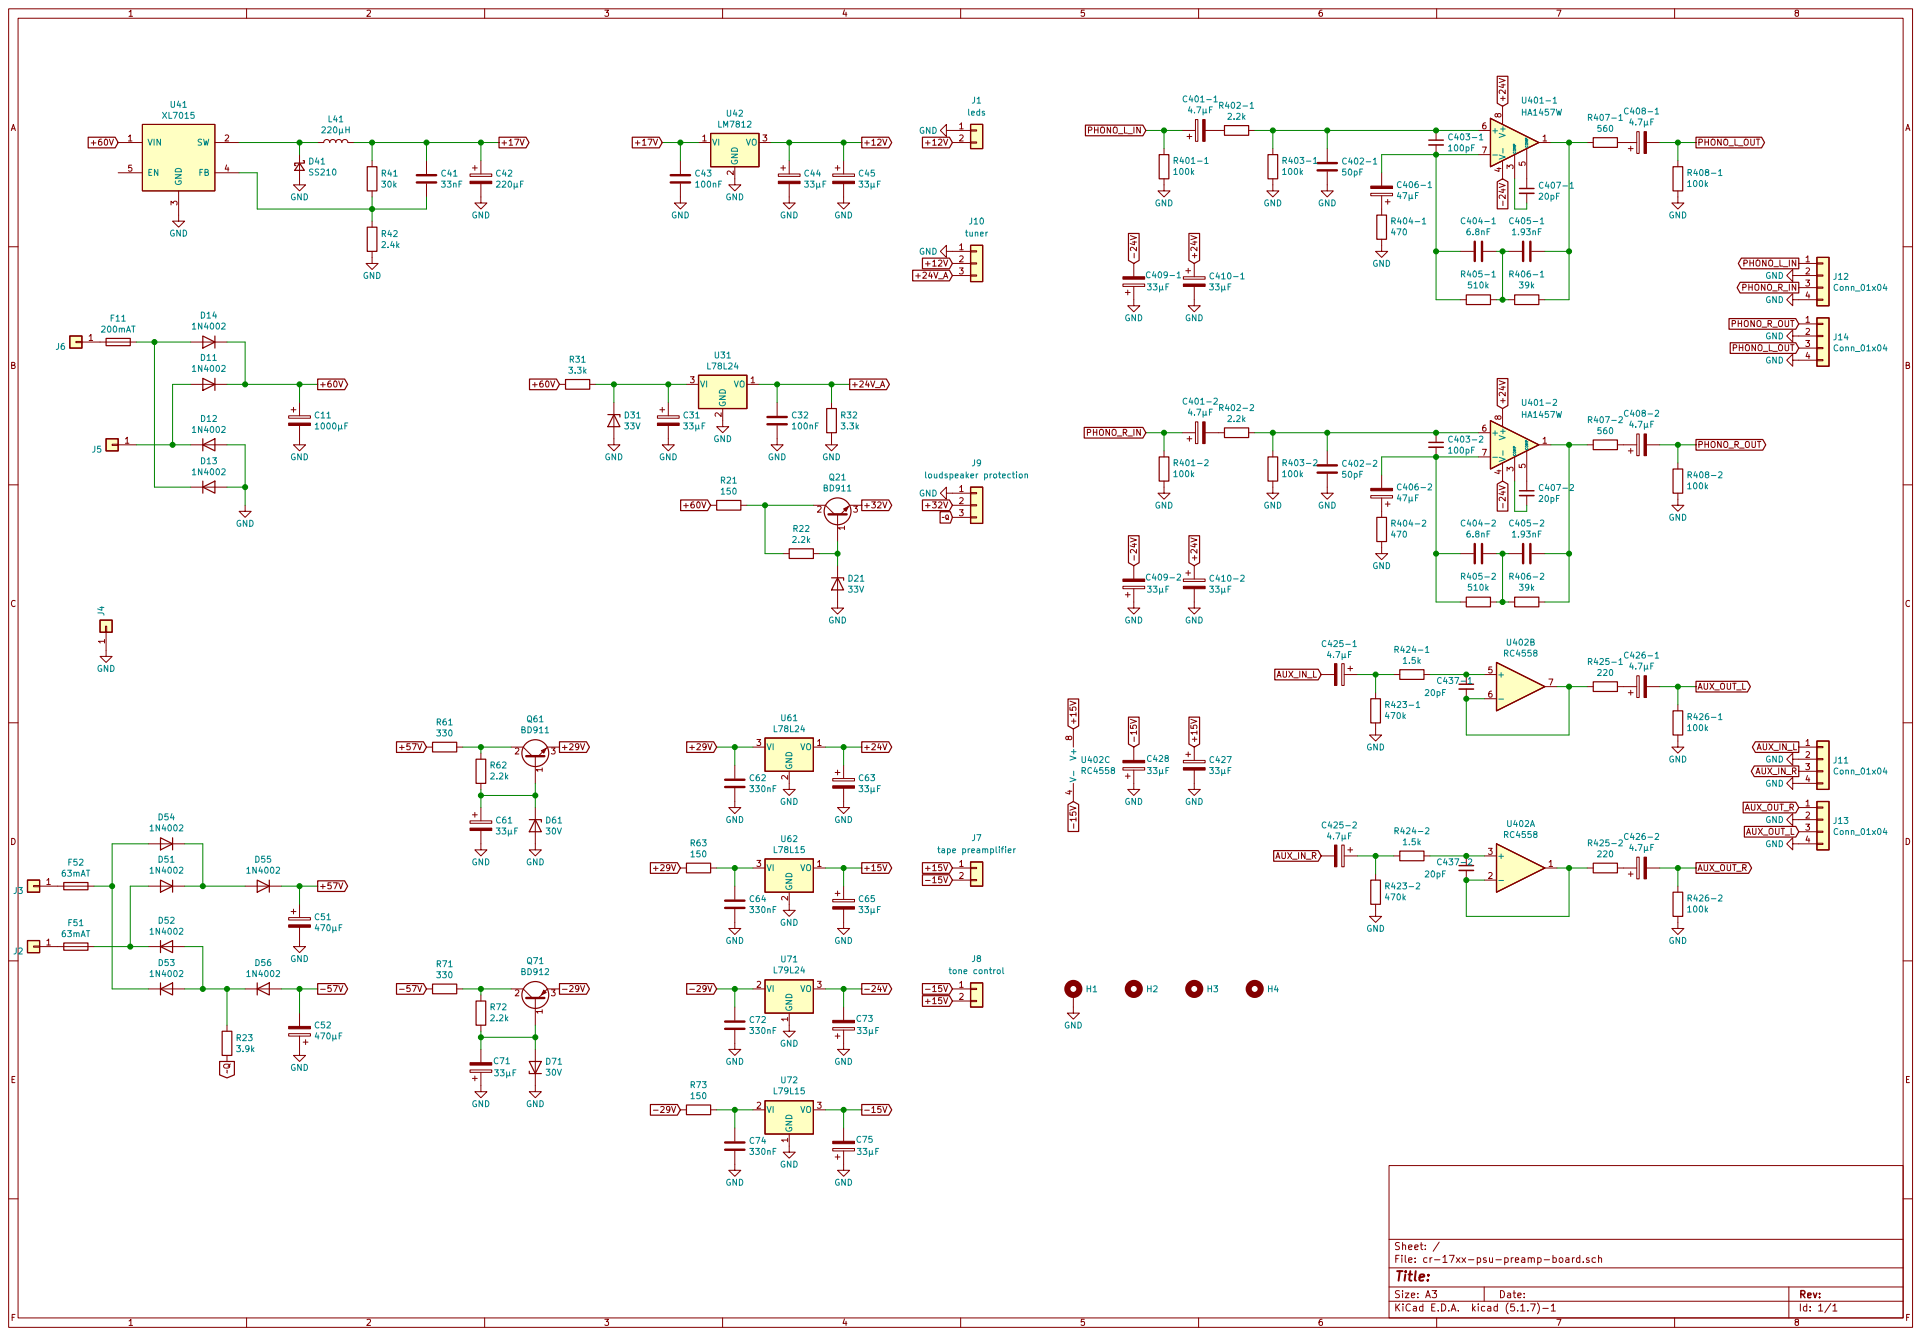
[picture p58: page 1]
