yannickbock/dual_cr1750_cr1780_ct1740/hardware/psu-module-positive_BL9342/schematic.pdf

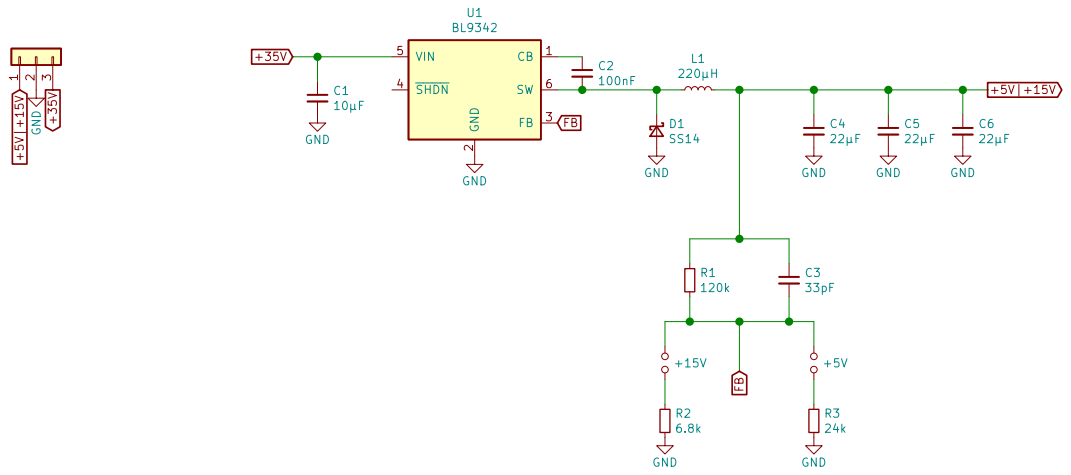
[picture p59: page 1]

2 FB 3 SHDN 4 VIN 5 SW 6 U1 BL9342
