yannickbock/dual_cr1750_cr1780_ct1740/hardware/cr-17xx-psu-preamp-board/cr-17xx-psu-preamp-board.kicad_pcb

## KiCad design hardware/cr-17xx-psu-preamp-board/cr-17xx-psu-preamp-board.kicad_pcb (2022-03-17)

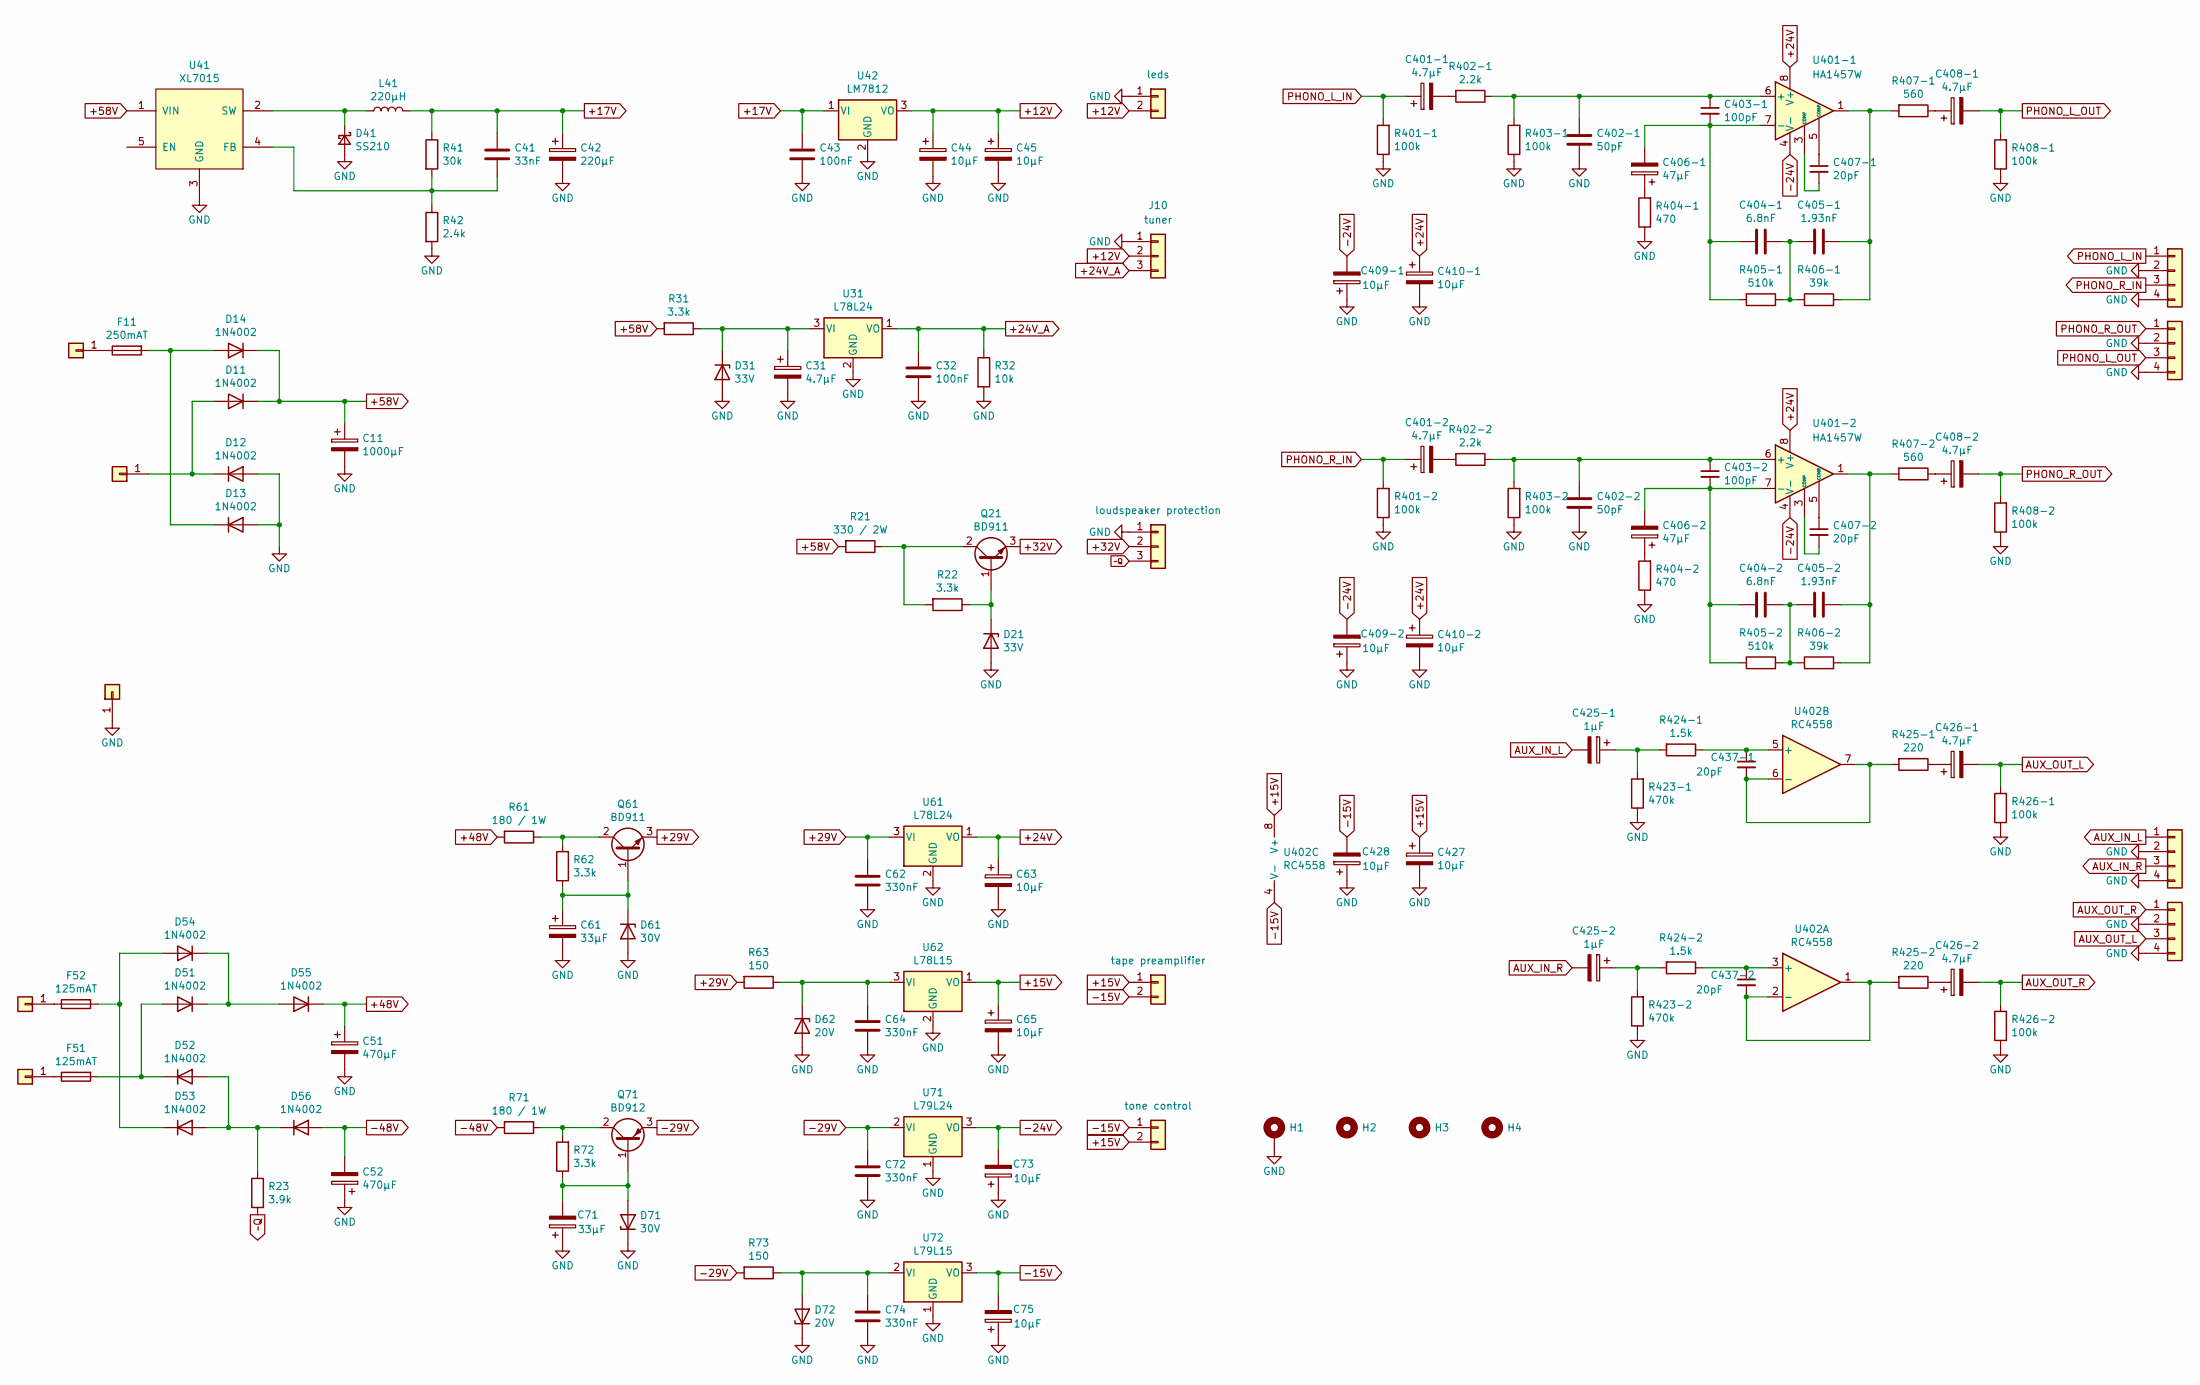
[picture p61: schematic cr-17xx-psu-preamp-board.sch]

Parts:
C11: 1000µF; CP_Radial_D17.0mm_P7.50mm
C31, C401-1, C401-2, C408-1, C408-2, C426-1, C426-2: 4.7µF; CP_Radial_D5.0mm_P2.00mm
C32, C43: 100nF; C_Disc_D4.3mm_W1.9mm_P5.00mm
C41: 33nF; C_0805_HandSoldering; LCSC C1739
C42: 220µF; CP_Radial_D10.0mm_P5.00mm
C44, C45, C63, C65, C73, C75, C409-1, C409-2, C410-1, C410-2, C427, C428: 10µF; CP_Radial_D5.0mm_P2.00mm
C51, C52: 470µF; CP_Radial_D12.5mm_P5.00mm
C61, C71: 33µF; CP_Radial_D5.0mm_P2.00mm
C62, C64, C72, C74: 330nF; C_Disc_D4.3mm_W1.9mm_P5.00mm
C402-1, C402-2: 50pF; C_Disc_D4.3mm_W1.9mm_P5.00mm
C403-1, C403-2: 100pF; C_Disc_D4.3mm_W1.9mm_P5.00mm
C404-1, C404-2: 6.8nF; C_Disc_D4.3mm_W1.9mm_P5.00mm
C405-1, C405-2: 1.93nF; C_Disc_D4.3mm_W1.9mm_P5.00mm
C406-1, C406-2: 47µF; CP_Radial_D5.0mm_P2.00mm
C407-1, C407-2, C437-1, C437-2: 20pF; C_Disc_D4.3mm_W1.9mm_P5.00mm
C425-1, C425-2: 1µF; CP_Radial_D5.0mm_P2.00mm
D11, D12, D13, D14, D51, D52, D53, D54, D55, D56: 1N4002; D_DO-41_SOD81_P10.16mm_Horizontal
D21, D31: 33V; D_DO-35_SOD27_P10.16mm_Horizontal
D41: SS210; D_SMA; LCSC C14996
D61, D71: 30V; D_DO-35_SOD27_P10.16mm_Horizontal
D62, D72: 20V; D_DO-35_SOD27_P7.62mm_Horizontal
F11: 250mAT; Fuseholder5x20_horiz_open_inline_Type-I
F51, F52: 125mAT; Fuseholder5x20_horiz_open_inline_Type-I
H1: MountingHole_Pad; MountingHole_4mm_Pad
H2, H3, H4: MountingHole; MountingHole_4mm
J1: leds; JST_XH_B02B-XH-A_02x2.50mm_Straight
J2, J3, J4, J5, J6: Conn_01x01; SolderWirePad_single_1mmDrill
J7: tape preamplifier; JST_XH_B02B-XH-A_02x2.50mm_Straight
J8: tone control; JST_XH_B02B-XH-A_02x2.50mm_Straight
J9: loudspeaker protection; JST_XH_B03B-XH-A_03x2.50mm_Straight
J10: tuner; JST_XH_B03B-XH-A_03x2.50mm_Straight
J11, J12, J13, J14: Conn_01x04; JST_XH_B04B-XH-A_04x2.50mm_Straight
L41: 220µH; L-Sunlord-SWPA6045SxxxMT; LCSC C91047
Q21, Q61: BD911; TO-220-3_Vertical
Q71: BD912; TO-220-3_Vertical
R21: 330 / 2W; R_Axial_DIN0614_L14.3mm_D5.7mm_P20.32mm_Horizontal
R22, R31, R62, R72: 3.3k; R_Axial_DIN0207_L6.3mm_D2.5mm_P10.16mm_Horizontal
R23: 3.9k; R_Axial_DIN0207_L6.3mm_D2.5mm_P10.16mm_Horizontal
R32: 10k; R_Axial_DIN0207_L6.3mm_D2.5mm_P10.16mm_Horizontal
R41: 30k; R_0805_HandSoldering; LCSC C17621
R42: 2.4k; R_0805_HandSoldering; LCSC C17526
R61, R71: 180 / 1W; R_Axial_DIN0414_L11.9mm_D4.5mm_P15.24mm_Horizontal
R63, R73: 150; R_Axial_DIN0414_L11.9mm_D4.5mm_P15.24mm_Horizontal
R401-1, R401-2, R403-1, R403-2, R408-1, R408-2, R426-1, R426-2: 100k; R_Axial_DIN0207_L6.3mm_D2.5mm_P10.16mm_Horizontal
R402-1, R402-2: 2.2k; R_Axial_DIN0207_L6.3mm_D2.5mm_P10.16mm_Horizontal
R404-1, R404-2: 470; R_Axial_DIN0207_L6.3mm_D2.5mm_P10.16mm_Horizontal
R405-1, R405-2: 510k; R_Axial_DIN0207_L6.3mm_D2.5mm_P10.16mm_Horizontal
R406-1, R406-2: 39k; R_Axial_DIN0207_L6.3mm_D2.5mm_P10.16mm_Horizontal
R407-1, R407-2: 560; R_Axial_DIN0207_L6.3mm_D2.5mm_P10.16mm_Horizontal
R423-1, R423-2: 470k; R_Axial_DIN0207_L6.3mm_D2.5mm_P10.16mm_Horizontal
R424-1, R424-2: 1.5k; R_Axial_DIN0207_L6.3mm_D2.5mm_P10.16mm_Horizontal
R425-1, R425-2: 220; R_Axial_DIN0207_L6.3mm_D2.5mm_P10.16mm_Horizontal
U31, U61: L78L24; TO-92_Inline_Wide
U41: XL7015; TO-252-5_TabPin3; LCSC C73013
U42: LM7812; TO-220-3_Vertical
U62: L78L15; TO-92_Inline_Wide
U71: L79L24; TO-92_Inline_Wide
U72: L79L15; TO-92_Inline_Wide
U401-1, U401-2: HA1457W; SIP8_NO_PIN_7
U402: RC4558; DIP-8_W7.62mm_LongPads

Connections:
+12V: C44.1, C45.1, J1.2, J10.2, U42.3 (VO)
+15V: C65.1, C427.1, J7.1, J8.2, U62.1 (VO), U402.8 (V+)
+17V: C41.1, C42.1, C43.1, L41.2, R41.1, U42.1 (VI)
+24V: C63.1, C410-1.1, C410-2.1, U61.1 (VO), U401-1.8 (V+), U401-2.8 (V+)
+24V_A: C32.1, J10.3, R32.1, U31.1 (VO)
+29V: C62.1, Q61.3 (E), R63.2, U61.3 (VI)
+32V: J9.2, Q21.3 (E)
+48V: C51.1, D55.1 (K), R61.2
+58V: C11.1, D11.1 (K), D14.1 (K), R21.2, R31.2, U41.1 (VIN)
-15V: C75.2, C428.2, J7.2, J8.1, U72.3 (VO), U402.4 (V-)
-24V: C73.2, C409-1.2, C409-2.2, U71.3 (VO), U401-1.4 (V-), U401-2.4 (V-)
-29V: C72.1, Q71.3 (E), R73.2, U71.2 (VI)
-48V: C52.2, D56.2 (A), R71.2
AUX_IN_L: C425-1.2, J11.1
AUX_IN_R: C425-2.2, J11.3
AUX_OUT_L: C426-1.2, J13.3, R426-1.2
AUX_OUT_R: C426-2.2, J13.1, R426-2.2
GND: C11.2, C31.2, C32.2, C42.2, C43.2, C44.2, C45.2, C51.2, C52.1, C61.2, C62.2, C63.2, C64.2, C65.2, C71.1, C72.2, C73.1, C74.2, C75.1, C402-1.2, C402-2.2, C409-1.1, C409-2.1, C410-1.2, C410-2.2, C427.2, C428.1, D12.2 (A), D13.2 (A), D21.2 (A), D31.2 (A), D41.2 (A), D61.2 (A), D62.2 (A), D71.1 (K), D72.1 (K), H1.1, J1.1, J4.1, J9.1, J10.1, J11.2, J11.4, J12.2, J12.4, J13.2, J13.4, J14.2, J14.4, R32.2, R42.2, R401-1.1, R401-2.1, R403-1.1, R403-2.1, R404-1.1, R404-2.1, R408-1.1, R408-2.1, R423-1.1, R423-2.1, R426-1.1, R426-2.1, U31.2 (GND), U41.3 (GND), U42.2 (GND), U61.2 (GND), U62.2 (GND), U71.1 (GND), U72.1 (GND)
unnamed: C31.1, D31.1 (K), R31.1, U31.3 (VI)
unnamed: C41.2, R41.2, R42.1, U41.4 (FB)
unnamed: C61.1, D61.1 (K), Q61.1 (B), R62.1
unnamed: C64.1, D62.1 (K), R63.1, U62.3 (VI)
unnamed: C71.2, D71.2 (A), Q71.1 (B), R72.1
unnamed: C74.1, D72.2 (A), R73.1, U72.2 (VI)
unnamed: C401-1.2, R402-1.2
unnamed: C401-2.2, R402-2.2
unnamed: C402-1.1, C403-1.1, R402-1.1, R403-1.2, U401-1.6 (+)
unnamed: C402-2.1, C403-2.1, R402-2.1, R403-2.2, U401-2.6 (+)
unnamed: C403-1.2, C404-1.2, C406-1.2, R405-1.1, U401-1.7 (-)
unnamed: C403-2.2, C404-2.2, C406-2.2, R405-2.1, U401-2.7 (-)
unnamed: C404-1.1, C405-1.2, R405-1.2, R406-1.1
unnamed: C404-2.1, C405-2.2, R405-2.2, R406-2.1
unnamed: C405-1.1, R406-1.2, R407-1.2, U401-1.1
unnamed: C405-2.1, R406-2.2, R407-2.2, U401-2.1
unnamed: C406-1.1, R404-1.2
unnamed: C406-2.1, R404-2.2
unnamed: C407-1.1, U401-1.5 (COMP)
unnamed: C407-1.2, U401-1.3 (COMP)
unnamed: C407-2.1, U401-2.5 (COMP)
unnamed: C407-2.2, U401-2.3 (COMP)
unnamed: C408-1.1, R407-1.1
unnamed: C408-2.1, R407-2.1
unnamed: C425-1.1, R423-1.2, R424-1.2
unnamed: C425-2.1, R423-2.2, R424-2.2
unnamed: C426-1.1, R425-1.1
unnamed: C426-2.1, R425-2.1
unnamed: C437-1.1, R424-1.1, U402.5 (+)
unnamed: C437-1.2, R425-1.2, U402.6 (-), U402.7
unnamed: C437-2.1, R424-2.1, U402.3 (+)
unnamed: C437-2.2, R425-2.2, U402.1, U402.2 (-)
unnamed: D11.2 (A), D12.1 (K), J5.1
unnamed: D13.1 (K), D14.2 (A), F11.2
unnamed: D21.1 (K), Q21.1 (B), R22.1
unnamed: D41.1 (K), L41.1, U41.2 (SW)
unnamed: D51.1 (K), D54.1 (K), D55.2 (A)
unnamed: D51.2 (A), D52.1 (K), F51.2
unnamed: D52.2 (A), D53.2 (A), D56.1 (K), R23.1
unnamed: D53.1 (K), D54.2 (A), F52.2
unnamed: F11.1, J6.1
unnamed: F51.1, J2.1
unnamed: F52.1, J3.1
unnamed: Q21.2 (C), R21.1, R22.2
unnamed: Q61.2 (C), R61.1, R62.2
unnamed: Q71.2 (C), R71.1, R72.2
PHONO_L_IN: C401-1.1, J12.1, R401-1.2
PHONO_L_OUT: C408-1.2, J14.3, R408-1.2
PHONO_R_IN: C401-2.1, J12.3, R401-2.2
PHONO_R_OUT: C408-2.2, J14.1, R408-2.2
~~Q: J9.3, R23.2

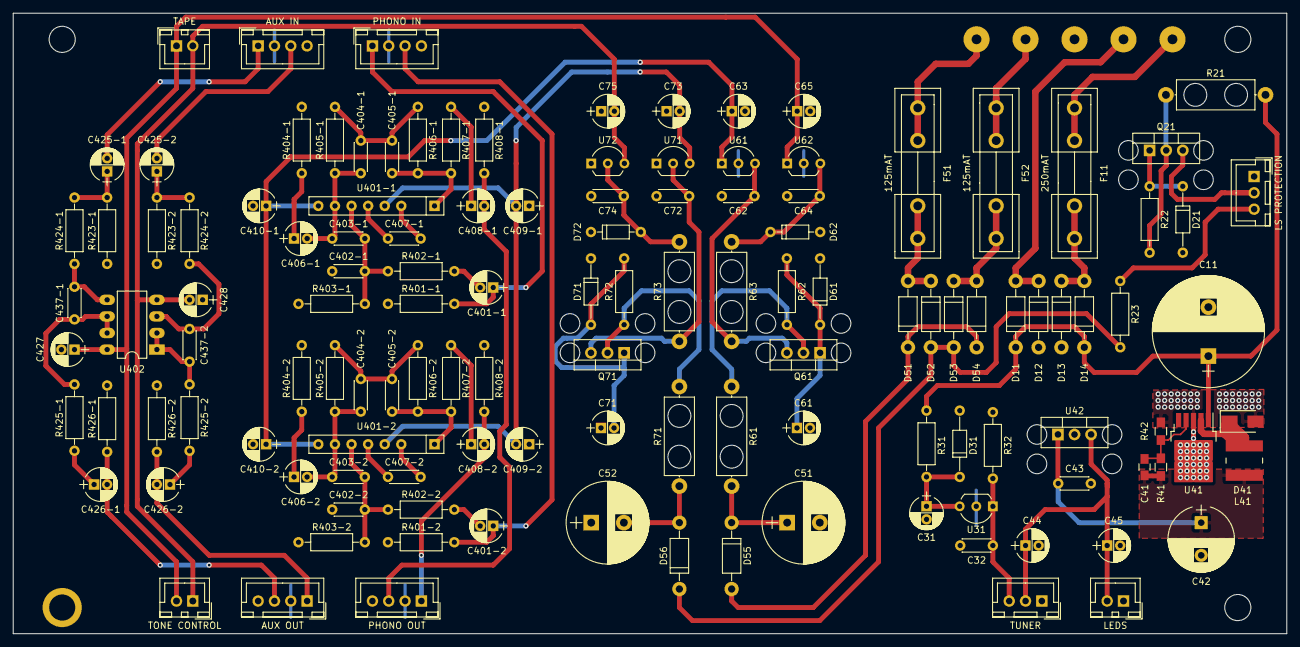
[picture p62: board cr-17xx-psu-preamp-board.kicad_pcb from above]

Board: 2 copper layers, 195.0 x 95.0 mm, 137 parts (0 on the bottom side), 69 nets.
