yannickbock/dual_cr1750_cr1780_ct1740/hardware/cr-17xx-psu-board/cr-17xx-psu-board.kicad_pcb

## KiCad design hardware/cr-17xx-psu-board/cr-17xx-psu-board.kicad_pcb (2022-03-17)

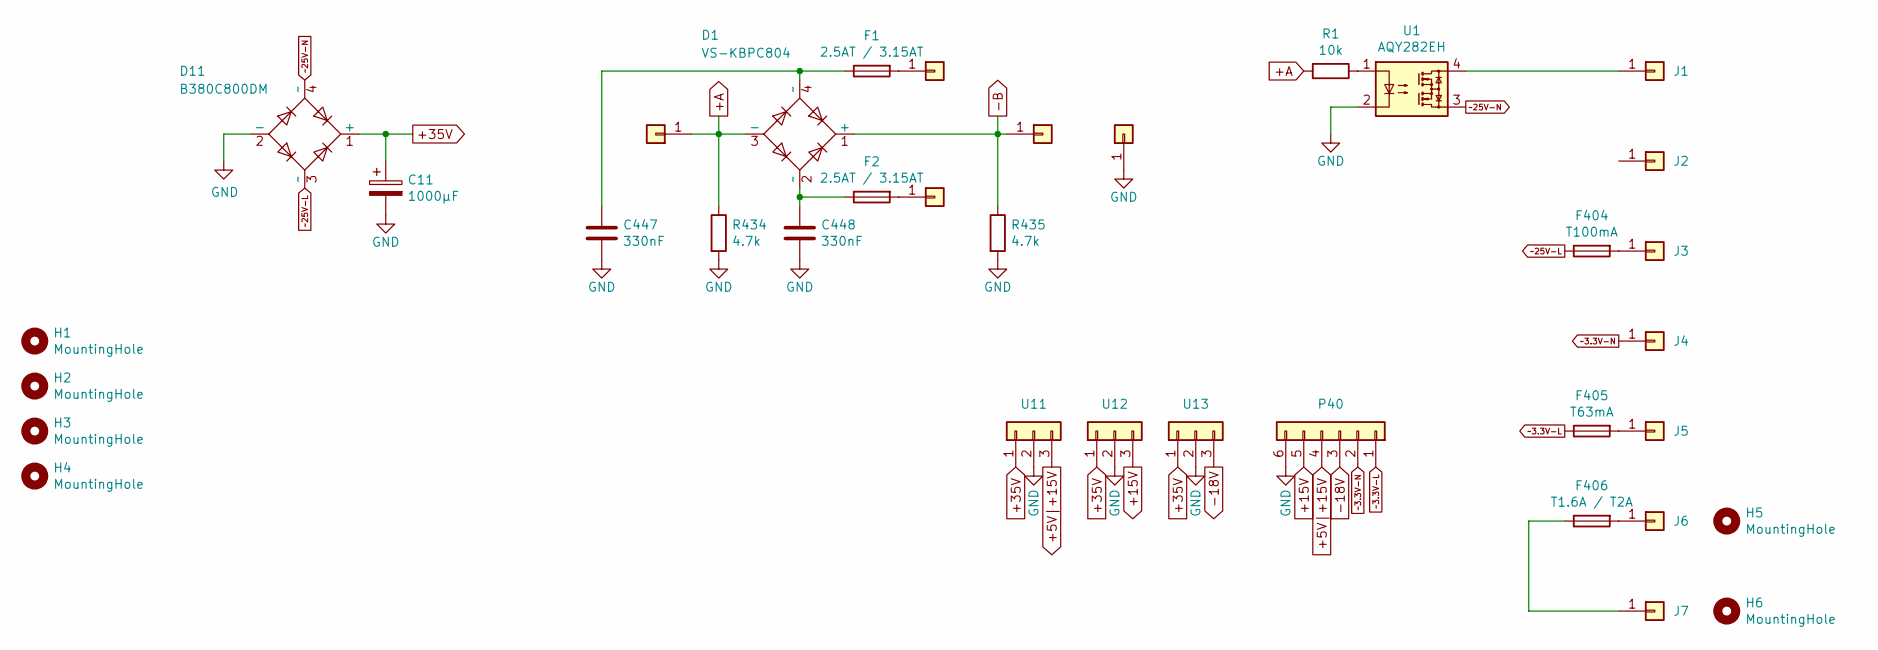
[picture p63: schematic cr-17xx-psu-board.sch]

Parts:
C11: 1000µF; CP_Radial_D16.0mm_P7.50mm
C447, C448: 330nF; C_Rect_L11.0mm_W5.1mm_P10.00mm_MKT
D1: VS-KBPC804; Diode_Bridge_15.7x15.7
D11: B380C800DM; Diode_Bridge_DIP-4_W7.62mm_P5.08mm
F1, F2: 2.5AT / 3.15AT; Fuseholder5x20_horiz_open_inline_Type-I
F404: T100mA; Fuseholder5x20_horiz_open_inline_Type-I
F405: T63mA; Fuseholder5x20_horiz_open_inline_Type-I
F406: T1.6A / T2A; Fuseholder5x20_horiz_open_inline_Type-I
H1, H2, H3, H4: MountingHole; MountingHole_4mm
H5, H6: MountingHole; MountingHole_3mm
J1, J2, J3, J4, J5, J6, J7, J8, J9, J10, J11, J12: Conn_01x01; SolderWirePad_single_1-5mmDrill
P40: Conn_01x06
R1: 10k; R_Axial_DIN0207_L6.3mm_D2.5mm_P10.16mm_Horizontal
R434, R435: 4.7k; R_Axial_DIN0614_L14.3mm_D5.7mm_P20.32mm_Horizontal
U1: AQY282EH; DIP-4_W7.62mm
U11, U12: LM7815_TO220; TO-220-3_Vertical
U13: Conn_01x03; TO-220-3_Vertical

Connections:
+5V|+15V: P40.4, U11.3
+15V: P40.5, U12.3
+35V: C11.1, D11.1 (+), U11.1, U12.1, U13.1
+A: D1.3 (-), J9.1, R1.2, R434.1
-18V: P40.3, U13.3
-B: D1.1 (+), J12.1, R435.1
GND: C11.2, C447.2, C448.2, D11.2 (-), J8.1, P40.6, R434.2, R435.2, U1.2, U11.2, U12.2, U13.2
unnamed: C447.1, D1.4 (~~), F1.1
unnamed: C448.1, D1.2 (~~), F2.1
unnamed: F1.2, J10.1
unnamed: F2.2, J11.1
unnamed: F404.2, J3.1
unnamed: F405.2, J5.1
unnamed: F406.1, J7.1
unnamed: F406.2, J6.1
unnamed: J1.1, U1.4
unnamed: R1.1, U1.1
~~3.3V-L: F405.1, P40.1
~~3.3V-N: J4.1, P40.2
~~25V-L: D11.3 (~~), F404.1
~~25V-N: D11.4 (~~), U1.3

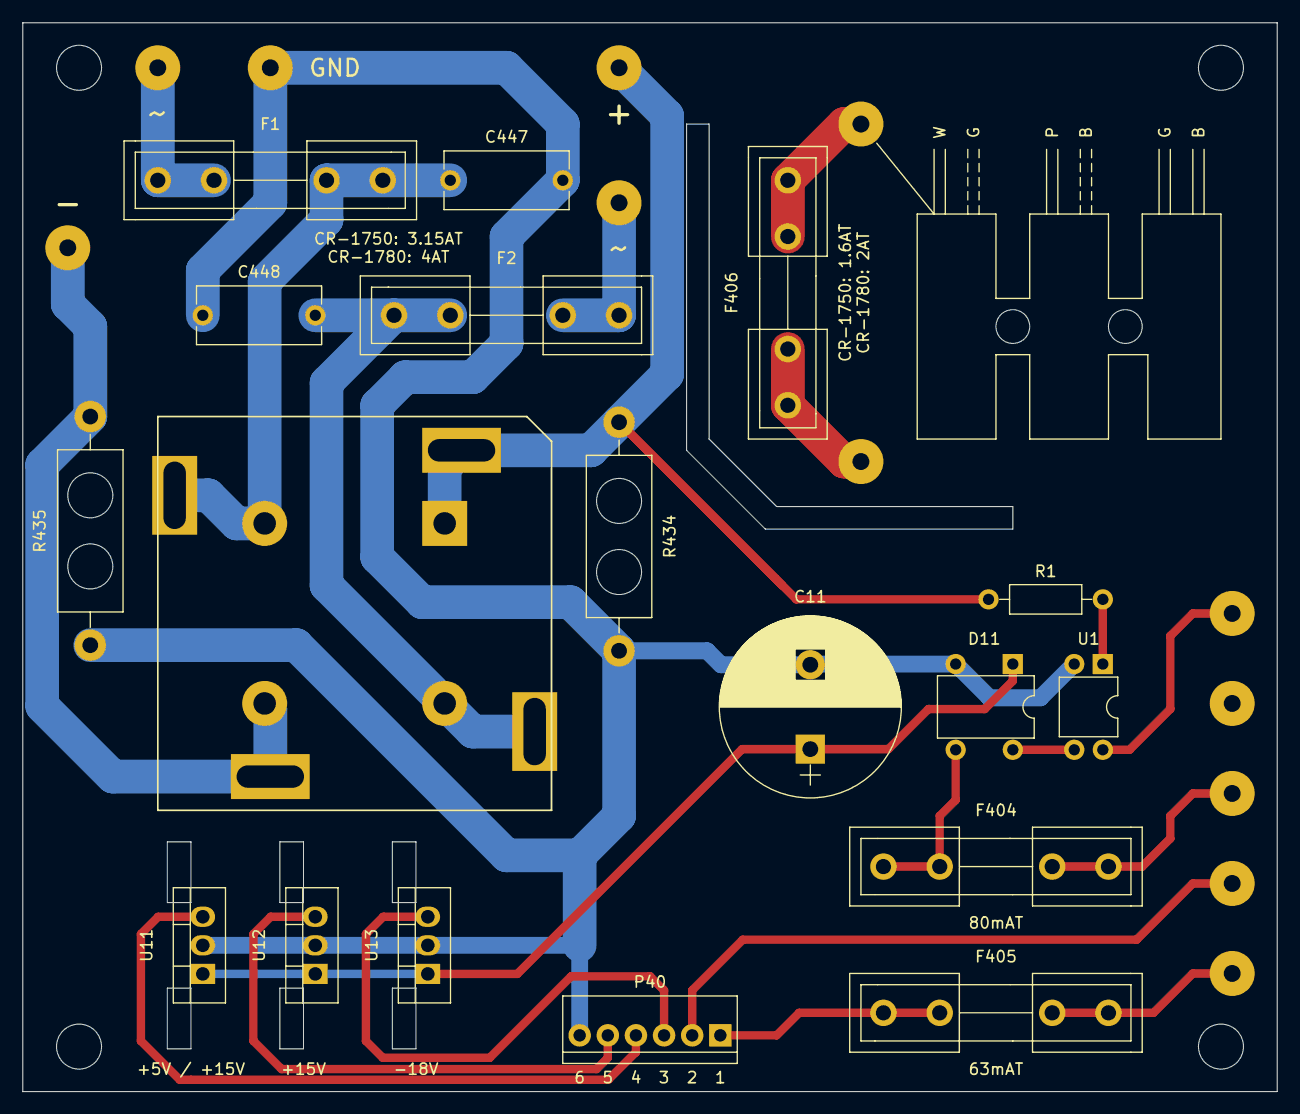
[picture p64: board cr-17xx-psu-board.kicad_pcb from above]

Board: 2 copper layers, 111.5 x 95.0 mm, 36 parts (0 on the bottom side), 21 nets.
