yannickbock/dual_cr1750_cr1780_ct1740/hardware/bluetooth-board/bluetooth-board.kicad_pcb

## KiCad design hardware/bluetooth-board/bluetooth-board.kicad_pcb (2022-03-17)

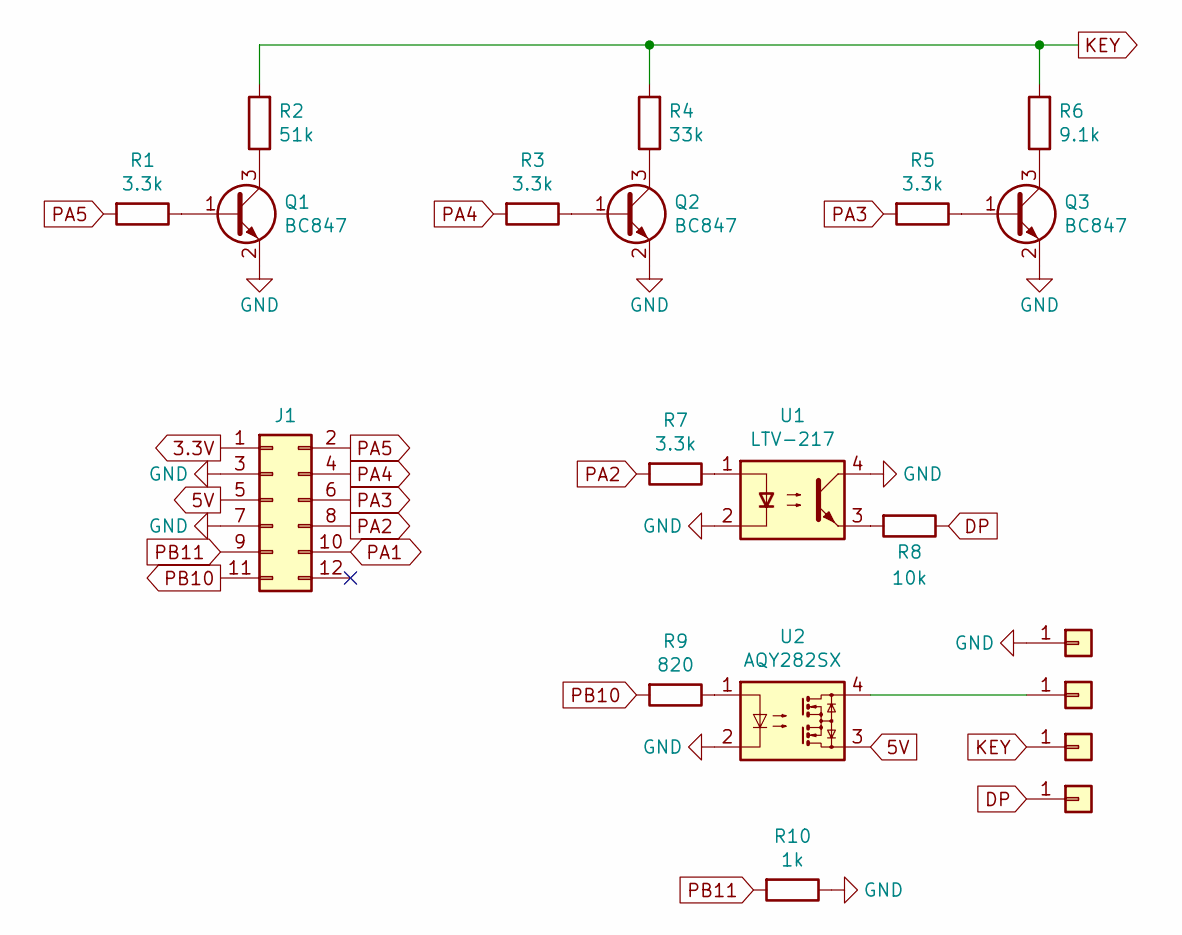
[picture p65: schematic bluetooth-board.sch]

Parts:
J1: Conn_02x06_Odd_Even; Socket_Strip_Straight_2x06_Pitch2.54mm
J2, J3, J4, J5: Conn_01x01; SolderWirePad_single_1mmDrill
Q1, Q2, Q3: BC847; SOT-23; LCSC C2145
R1, R3, R5, R7: 3.3k; R_0805; LCSC C26010
R2: 51k; R_0805; LCSC C17737
R4: 33k; R_0805; LCSC C17633
R6: 9.1k; R_0805; LCSC C17855
R8: 10k; R_0805; LCSC C17414
R9: 820; R_0805; LCSC C17837
R10: 1k; R_0805; LCSC C17513
U1: LTV-217; SOP-4_4.4x2.8mm_Pitch1.27mm; LCSC C691224
U2: AQY282SX; SOP-4_3.8x4.1mm_Pitch2.54mm; LCSC C250827

Connections:
3.3V: J1.1
5V: J1.5, U2.3
DP: J5.1, R8.1
GND: J1.3, J1.7, J2.1, Q1.2 (E), Q2.2 (E), Q3.2 (E), R10.1, U1.2, U1.4, U2.2
KEY: J4.1, R2.2, R4.2, R6.2
unnamed: J3.1, U2.4
unnamed: Q1.1 (B), R1.1
unnamed: Q1.3 (C), R2.1
unnamed: Q2.1 (B), R3.1
unnamed: Q2.3 (C), R4.1
unnamed: Q3.1 (B), R5.1
unnamed: Q3.3 (C), R6.1
unnamed: R7.1, U1.1
unnamed: R8.2, U1.3
unnamed: R9.1, U2.1
PA1: J1.10
PA2: J1.8, R7.2
PA3: J1.6, R5.2
PA4: J1.4, R3.2
PA5: J1.2, R1.2
PB10: J1.11, R9.2
PB11: J1.9, R10.2

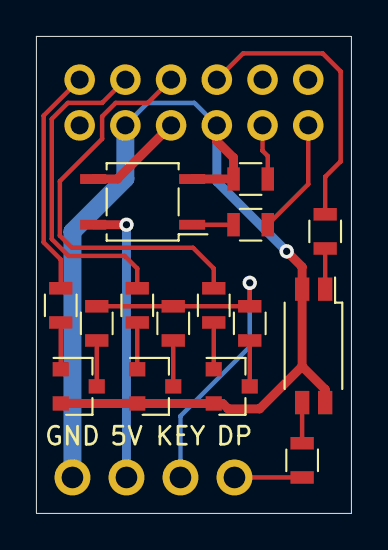
[picture p66: board bluetooth-board.kicad_pcb from above]

Board: 2 copper layers, 17.5 x 26.5 mm, 20 parts (1 on the bottom side), 20 nets.
