yannickbock/dual_cr1750_cr1780_ct1740/hardware/psu-module-positive_BL9342/psu-module-positive.kicad_pcb

## KiCad design hardware/psu-module-positive_BL9342/psu-module-positive.kicad_pcb (2022-03-17)

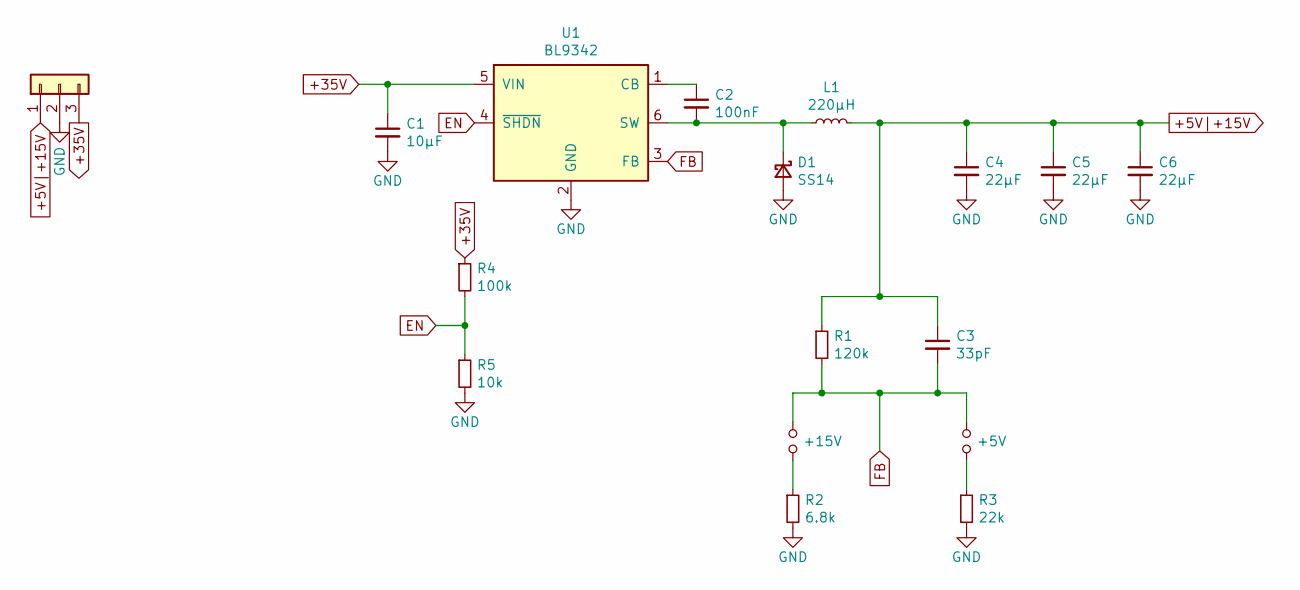
[picture p67: schematic psu-module-positive.sch]

Parts:
C1: 10µF; C_1206; LCSC C13585
C2: 100nF; C_0805; LCSC C49678
C3: 33pF; C_0805; LCSC C1814
C4, C5, C6: 22µF; C_0805; LCSC C45783
D1: SS14; D_SMA; LCSC C2480
J5: Conn_01x03; Pin_Header_Angled_1x03_Pitch2.54mm
JP1: +15V; WireConnection_0.80mmDrill_ThinPad
JP2: +5V; WireConnection_0.80mmDrill_ThinPad
L1: 220µH; L_Wuerth_WE-PD2-Typ-MS; LCSC C91047
R1: 120k; R_0805; LCSC C17436
R2: 6.8k; R_0805; LCSC C17772
R3: 22k; R_0805; LCSC C17560
R4: 100k; R_0805; LCSC C17407
R5: 10k; R_0805; LCSC C17414
U1: BL9342; SOT-23-6_Handsoldering; LCSC C93176

Connections:
+5V|+15V: C3.1, C4.1, C5.1, C6.1, J5.1, L1.2, R1.1
+35V: C1.1, J5.3, R4.1, U1.5 (VIN)
EN: R4.2, R5.1, U1.4 (~SHDN)
FB: C3.2, JP1.1, JP2.1, R1.2, U1.3 (FB)
GND: C1.2, C4.2, C5.2, C6.2, D1.2 (A), J5.2, R2.2, R3.2, R5.2, U1.2 (GND)
unnamed: C2.1, U1.1 (CB)
unnamed: C2.2, D1.1 (K), L1.1, U1.6 (SW)
unnamed: JP1.2, R2.1
unnamed: JP2.2, R3.1

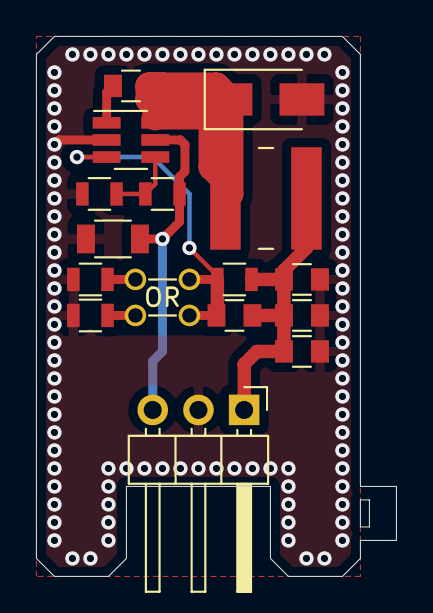
[picture p68: board psu-module-positive.kicad_pcb from above]

Board: 2 copper layers, 20.0 x 30.0 mm, 17 parts (0 on the bottom side), 9 nets.
