yannickbock/dual_cr1750_cr1780_ct1740/hardware/synthesizer-board/synthesizer-board.kicad_pcb

## KiCad design hardware/synthesizer-board/synthesizer-board.kicad_pcb (2022-03-17)

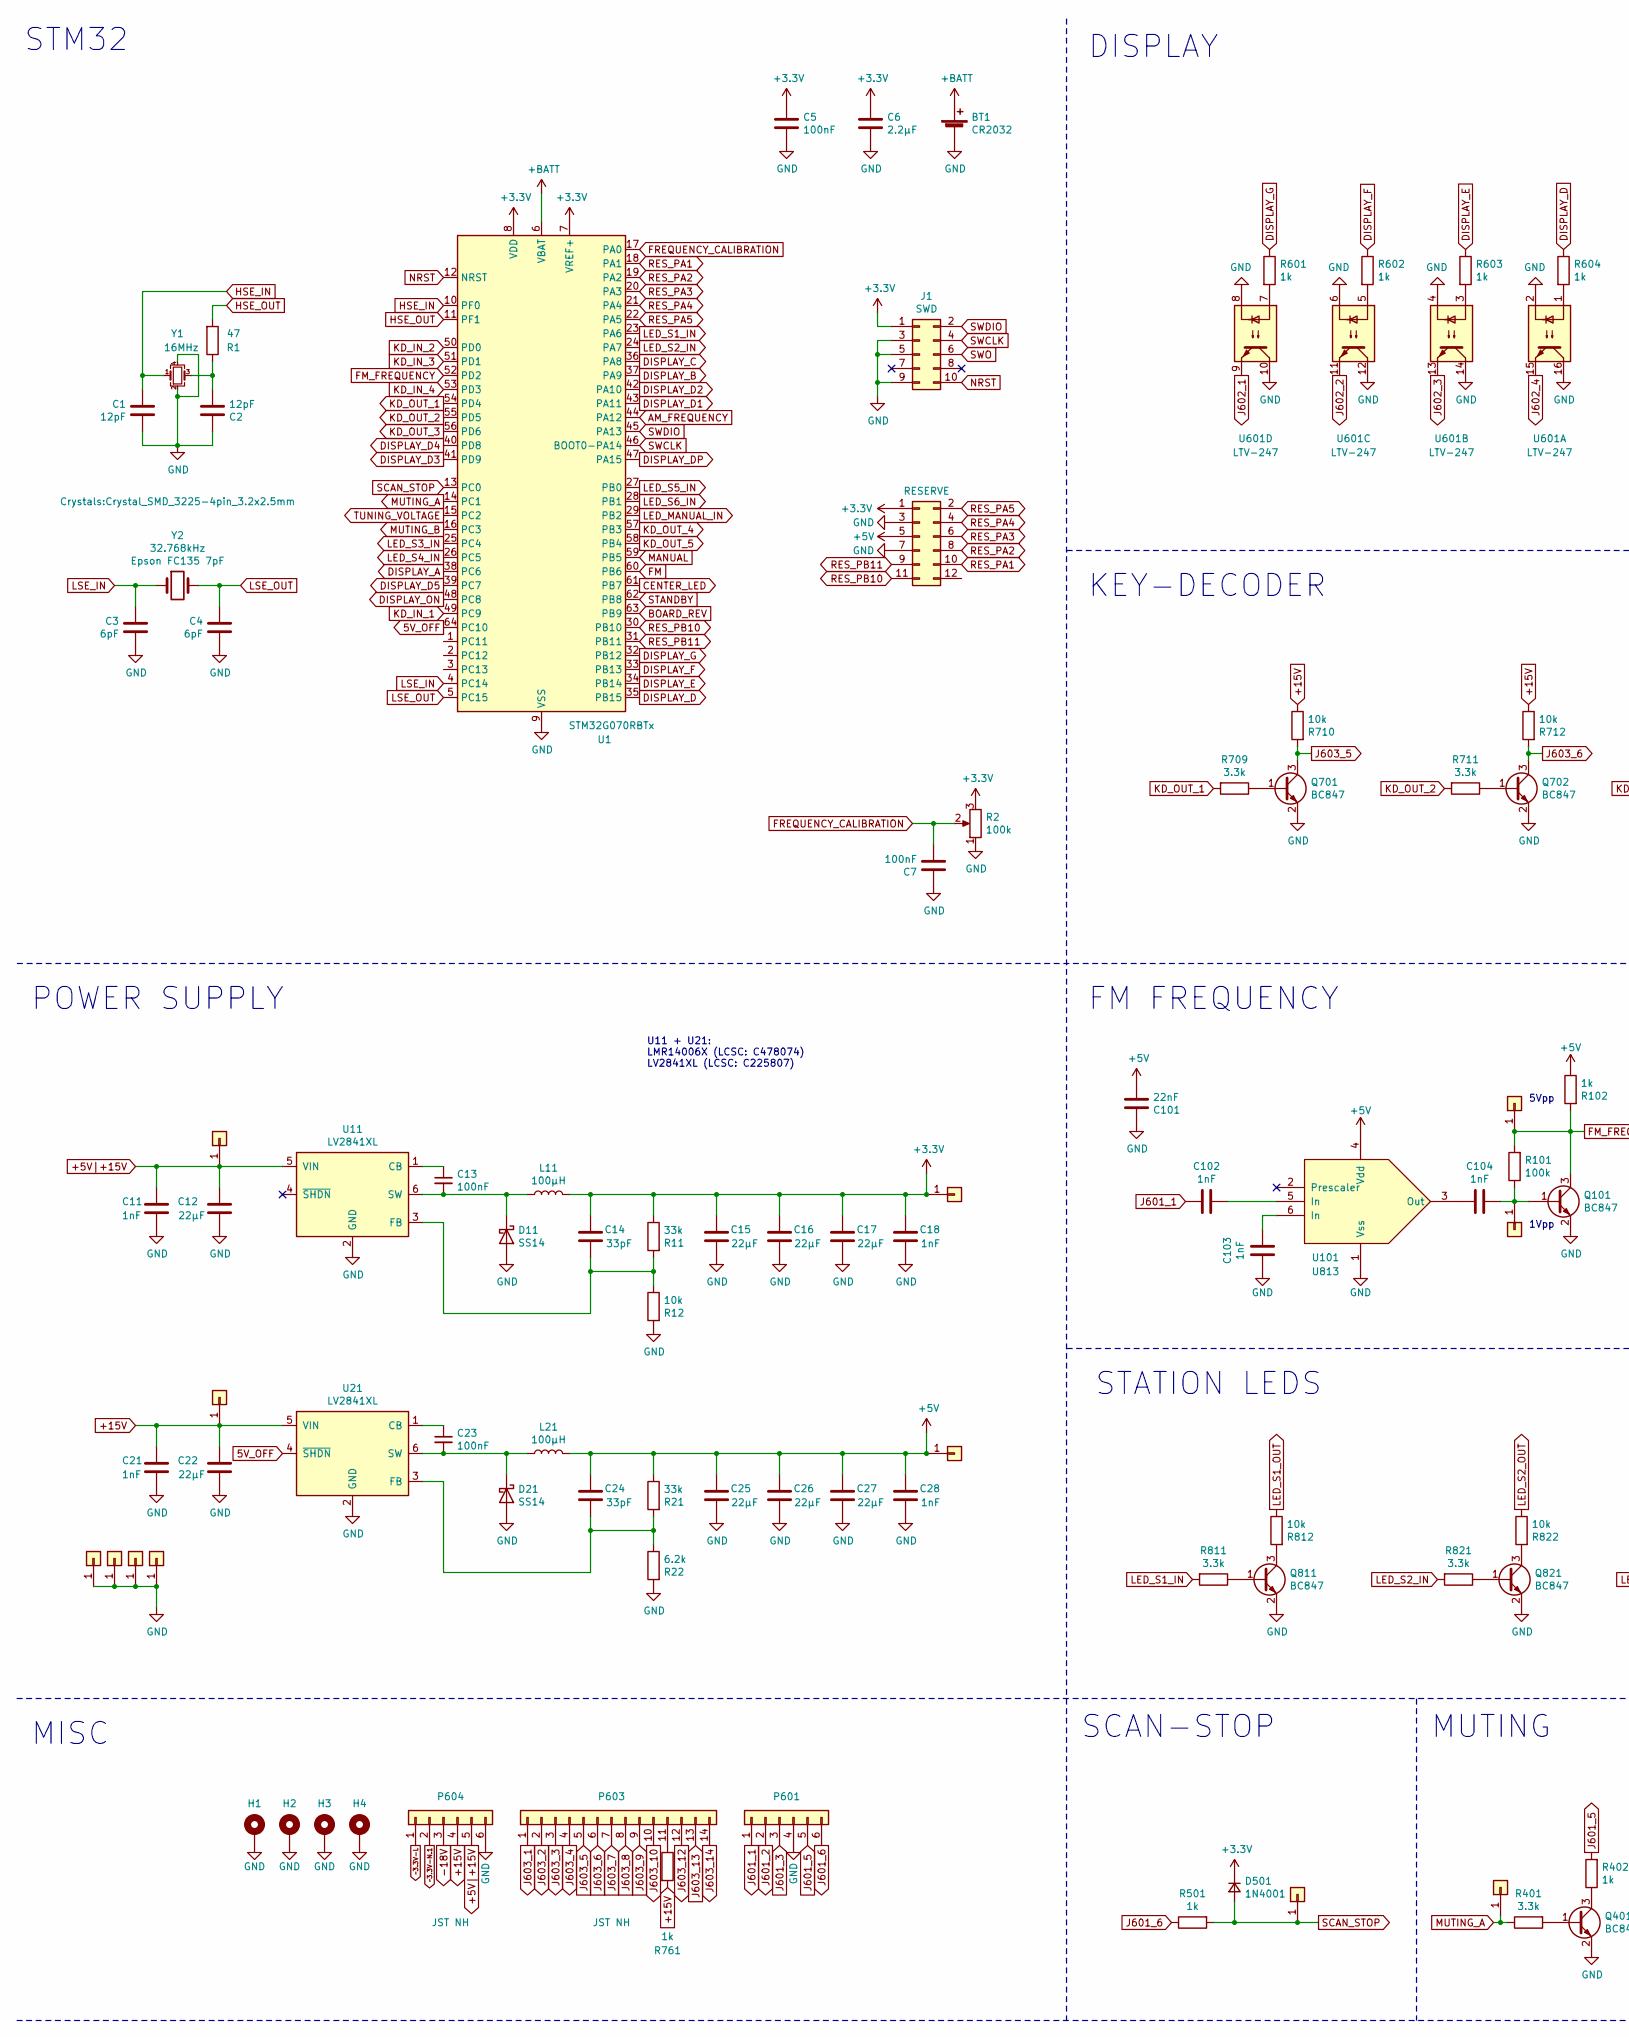
[picture p69: schematic synthesizer-board.sch, part in row 1, column 1]

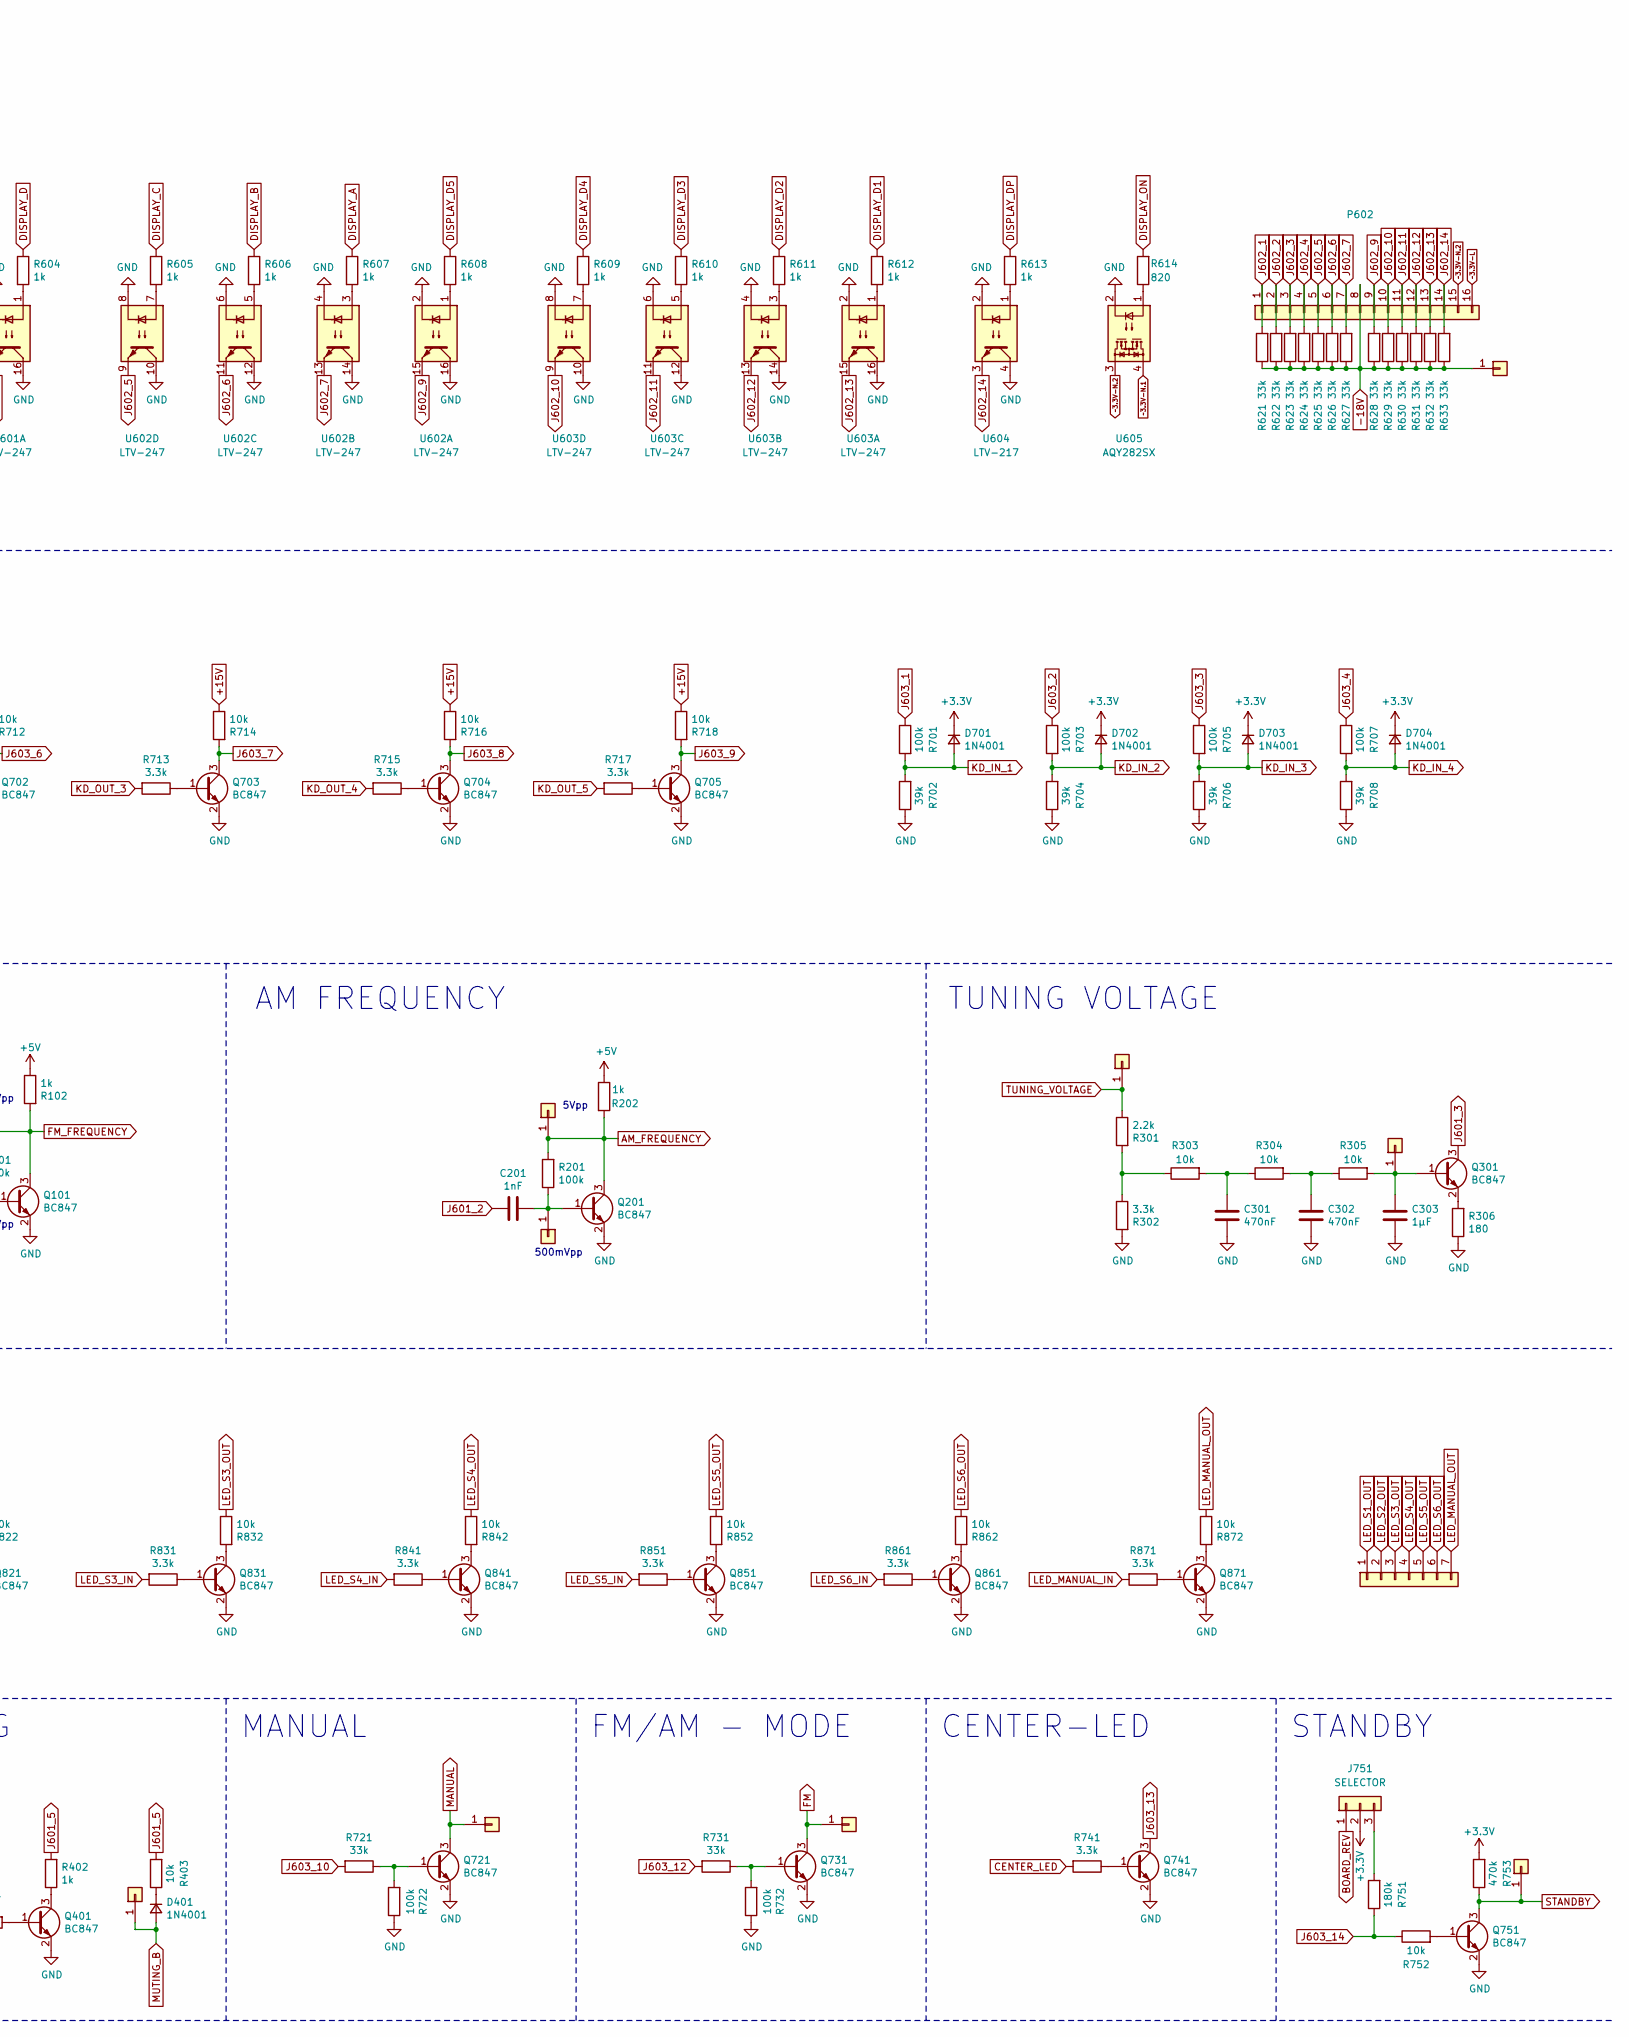
[picture p70: schematic synthesizer-board.sch, part in row 1, column 2]

Parts:
BT1: CR2032; Keystone_103_1x20mm-CoinCell
C1, C2: 12pF; C_0805; LCSC C1804
C3, C4: 6pF; C_0805; LCSC C67560
C5, C7, C13, C23: 100nF; C_0805; LCSC C49678
C6: 2.2µF; C_0805; LCSC C49217
C11, C18, C21, C28, C102, C103, C104, C201: 1nF; C_0805; LCSC C46653
C12, C15, C16, C17, C22, C25, C26, C27: 22µF; C_0805; LCSC C45783
C14, C24: 33pF; C_0805; LCSC C1814
C101: 22nF; C_0805; LCSC C1729
C301, C302: 470nF; C_0805; LCSC C13967
C303: 1µF; C_0805; LCSC C28323
D11, D21: SS14; D_SMA; LCSC C2480
D401, D501, D701, D702, D703, D704: 1N4001; D_SOD-123F; LCSC C64898
H1, H2, H3, H4: MountingHole_Pad; MountingHole_5mm_Pad_Via
J1: SWD; Pin_Header_Straight_2x05_Pitch2.54mm
J2, J3, J5, J6, J7, J8, J9, J10, J11, J12, J13, J14, J15, J16, J17, J18, J19, J20, J21, J22, J23: Conn_01x01; Measurement_Point_Round-TH_Small
J4: Conn_01x07; JST_XH_B07B-XH-A_07x2.50mm_Straight
J24: RESERVE; Pin_Header_Straight_2x06_Pitch2.54mm
J751: SELECTOR; Pin_Header_Straight_1x03_Pitch2.54mm
L11, L21: 100µH; BCNR6045CF1-101M; LCSC C238004
P601: Conn_01x06_Male; Conn_5.0_3.5_x6
P602: Conn_01x16_Male; JST_XH_B16B-XH-A_16x2.50mm_Straight
P603: JST NH; JST_XH_B14B-XH-A_14x2.50mm_Straight
P604: JST NH; JST_XH_B06B-XH-A_06x2.50mm_Straight
Q101, Q201, Q301, Q701, Q702, Q703, Q704, Q705, Q721, Q731, Q741, Q751, Q811, Q821, Q831, Q841, Q851, Q861, Q871: BC847; SOT-23; LCSC C2145
Q401: BC847; SOT-23
R1: 47; R_0603; LCSC C23182
R2: 100k; Potentiometer_Trimmer_Bourns_3296W
R11, R21, R621, R622, R623, R624, R625, R626, R627, R628, R629, R630, R631, R632, R633, R721, R731: 33k; R_0805; LCSC C17633
R12, R303, R304, R305, R403, R710, R712, R714, R716, R718, R752, R812, R822, R832, R842, R852, R862, R872: 10k; R_0805; LCSC C17414
R22: 6.2k; R_0805; LCSC C17767
R101, R201, R701, R703, R705, R707, R722, R732: 100k; R_0805; LCSC C17407
R102, R202, R402, R501, R601, R602, R603, R604, R605, R606, R607, R608, R609, R610, R611, R612, R613: 1k; R_0805; LCSC C17513
R301: 2.2k; R_0805; LCSC C17520
R302, R401, R709, R711, R713, R715, R717, R741, R811, R821, R831, R841, R851, R861, R871: 3.3k; R_0805; LCSC C26010
R306: 180; R_0805; LCSC C25270
R614: 820; R_0805; LCSC C17837
R702, R704, R706, R708: 39k; R_0805; LCSC C25826
R751: 180k; R_0805; LCSC C17501
R753: 470k; R_0805; LCSC C17709
R761: 1k; R_1206; LCSC C4410
U1: STM32G070RBTx; LQFP-64_10x10mm_Pitch0.5mm; LCSC C529340
U11, U21: LV2841XL; TSOT-23-6; LCSC C225807
U101: U813; R_Array_SIP6
U601, U602, U603: LTV-247; SOP-16_4.4x10.4mm_Pitch1.27mm; LCSC C115451
U604: LTV-217; SOP-4_4.4x2.8mm_Pitch1.27mm; LCSC C691224
U605: AQY282SX; SOP-4_3.8x4.1mm_Pitch2.54mm; LCSC C250827
Y1: 16MHz; Crystal_SMD_3225-4pin_3.2x2.5mm; LCSC C13738
Y2: 32.768kHz; Crystal_SMD_3215-2pin_3.2x1.5mm; LCSC C48615

Connections:
5V_OFF: U1.64 (PC10), U21.4 (~SHDN)
+3V3: C5.2, C6.2, C14.1, C15.1, C16.1, C17.1, C18.1, D501.1 (K), D701.1 (K), D702.1 (K), D703.1 (K), D704.1 (K), J1.1, J2.1, J24.1, J751.2, L11.2, R2.3, R11.1, R753.2, U1.7 (VREF+), U1.8 (VDD)
+5V: C24.1, C25.1, C26.1, C27.1, C28.1, C101.1, J3.1, J24.5, L21.2, R21.1, R102.1, R202.1, U101.4 (Vdd)
+5V|+15V: C11.2, C12.1, J5.1, P604.5, U11.5 (VIN)
+15V: C21.2, C22.1, J6.1, P604.4, R710.1, R712.1, R714.1, R716.1, R718.1, R761.2, U21.5 (VIN)
+BATT: BT1.1 (+), U1.6 (VBAT)
-18V: J15.1, P602.8, P604.3, R621.1, R622.1, R623.1, R624.1, R625.1, R626.1, R627.1, R628.1, R629.1, R630.1, R631.1, R632.1, R633.1
AM_FREQUENCY: J12.1, Q201.3 (C), R201.2, R202.2, U1.44 (PA12)
BOARD_REV: J751.1, U1.63 (PB9)
CENTER_LED: R741.2, U1.61 (PB7)
DISPLAY_A: R607.1, U1.38 (PC6)
DISPLAY_B: R606.1, U1.37 (PA9)
DISPLAY_C: R605.1, U1.36 (PA8)
DISPLAY_D: R604.1, U1.35 (PB15)
DISPLAY_D1: R612.1, U1.43 (PA11)
DISPLAY_D2: R611.1, U1.42 (PA10)
DISPLAY_D3: R610.1, U1.41 (PD9)
DISPLAY_D4: R609.1, U1.40 (PD8)
DISPLAY_D5: R608.1, U1.39 (PC7)
DISPLAY_DP: R613.1, U1.47 (PA15)
DISPLAY_E: R603.1, U1.34 (PB14)
DISPLAY_F: R602.1, U1.33 (PB13)
DISPLAY_G: R601.1, U1.32 (PB12)
DISPLAY_ON: R614.2, U1.48 (PC8)
FM: J22.1, Q731.3 (C), U1.60 (PB6)
FM_FREQUENCY: J11.1, Q101.3 (C), R101.2, R102.2, U1.52 (PD2)
FREQUENCY_CALIBRATION: C7.1, R2.2, U1.17 (PA0)
GND: BT1.2 (-), C1.1, C2.2, C3.1, C4.1, C5.1, C6.1, C7.2, C11.1, C12.2, C15.2, C16.2, C17.2, C18.2, C21.1, C22.2, C25.2, C26.2, C27.2, C28.2, C101.2, C103.2, C301.1, C302.1, C303.1, D11.2 (A), D21.2 (A), H1.1, H2.1, H3.1, H4.1, J1.3, J1.5, J1.9, J7.1, J8.1, J9.1, J10.1, J24.3, J24.7, P601.4, P604.6, Q101.2 (E), Q201.2 (E), Q401.2 (E), Q701.2 (E), Q702.2 (E), Q703.2 (E), Q704.2 (E), Q705.2 (E), Q721.2 (E), Q731.2 (E), Q741.2 (E), Q751.2 (E), Q811.2 (E), Q821.2 (E), Q831.2 (E), Q841.2 (E), Q851.2 (E), Q861.2 (E), Q871.2 (E), R2.1, R12.2, R22.2, R302.2, R306.1, R702.1, R704.1, R706.1, R708.1, R722.1, R732.1, U1.9 (VSS), U11.2 (GND), U21.2 (GND), U101.1 (Vss), U601.2, U601.4, U601.6, U601.8, U601.10, U601.12, U601.14, U601.16, U602.2, U602.4, U602.6, U602.8, U602.10, U602.12, U602.14, U602.16, U603.2, U603.4, U603.6, U603.8, U603.10, U603.12, U603.14, U603.16, U604.2, U604.4, U605.2, Y1.2, Y1.4
HSE_IN: C1.2, U1.10 (PF0), Y1.1
HSE_OUT: R1.2, U1.11 (PF1)
J601_1: C102.2, P601.1
J601_2: C201.1, P601.2
J601_3: P601.3, Q301.3 (C)
J601_5: P601.5, R402.2, R403.2
J601_6: P601.6, R501.1
J602_1: P602.1, R621.2, U601.9
J602_2: P602.2, R622.2, U601.11
J602_3: P602.3, R623.2, U601.13
J602_4: P602.4, R624.2, U601.15
J602_5: P602.5, R625.2, U602.9
J602_6: P602.6, R626.2, U602.11
J602_7: P602.7, R627.2, U602.13
J602_9: P602.9, R628.2, U602.15
J602_10: P602.10, R629.2, U603.9
J602_11: P602.11, R630.2, U603.11
J602_12: P602.12, R631.2, U603.13
J602_13: P602.13, R632.2, U603.15
J602_14: P602.14, R633.2, U604.3
J603_1: P603.1, R701.1
J603_2: P603.2, R703.1
J603_3: P603.3, R705.1
J603_4: P603.4, R707.1
J603_5: P603.5, Q701.3 (C), R710.2
J603_6: P603.6, Q702.3 (C), R712.2
J603_7: P603.7, Q703.3 (C), R714.2
J603_8: P603.8, Q704.3 (C), R716.2
J603_9: P603.9, Q705.3 (C), R718.2
J603_10: P603.10, R721.2
J603_12: P603.12, R731.2
J603_13: P603.13, Q741.3 (C)
J603_14: P603.14, R751.1, R752.1
KD_IN_1: D701.2 (A), R701.2, R702.2, U1.49 (PC9)
KD_IN_2: D702.2 (A), R703.2, R704.2, U1.50 (PD0)
KD_IN_3: D703.2 (A), R705.2, R706.2, U1.51 (PD1)
KD_IN_4: D704.2 (A), R707.2, R708.2, U1.53 (PD3)
KD_OUT_1: R709.2, U1.54 (PD4)
KD_OUT_2: R711.2, U1.55 (PD5)
KD_OUT_3: R713.2, U1.56 (PD6)
KD_OUT_4: R715.2, U1.57 (PB3)
KD_OUT_5: R717.2, U1.58 (PB4)
LED_MANUAL_IN: R871.2, U1.29 (PB2)
LED_MANUAL_OUT: J4.7, R872.1
LED_S1_IN: R811.2, U1.23 (PA6)
LED_S1_OUT: J4.1, R812.1
LED_S2_IN: R821.2, U1.24 (PA7)
LED_S2_OUT: J4.2, R822.1
LED_S3_IN: R831.2, U1.25 (PC4)
LED_S3_OUT: J4.3, R832.1
LED_S4_IN: R841.2, U1.26 (PC5)
LED_S4_OUT: J4.4, R842.1
LED_S5_IN: R851.2, U1.27 (PB0)
LED_S5_OUT: J4.5, R852.1
LED_S6_IN: R861.2, U1.28 (PB1)
LED_S6_OUT: J4.6, R862.1
LSE_IN: C3.2, U1.4 (PC14), Y2.1
LSE_OUT: C4.2, U1.5 (PC15), Y2.2
MANUAL: J21.1, Q721.3 (C), U1.59 (PB5)
MUTING_A: J18.1, R401.1, U1.14 (PC1)
MUTING_B: D401.2 (A), J19.1, U1.16 (PC3)
NRST: J1.10, U1.12 (NRST)
unnamed: C2.1, R1.1, Y1.3
unnamed: C13.1, U11.1 (CB)
unnamed: C13.2, D11.1 (K), L11.1, U11.6 (SW)
unnamed: C14.2, R11.2, R12.1, U11.3 (FB)
unnamed: C23.1, U21.1 (CB)
unnamed: C23.2, D21.1 (K), L21.1, U21.6 (SW)
unnamed: C24.2, R21.2, R22.1, U21.3 (FB)
unnamed: C102.1, U101.5 (In)
unnamed: C103.1, U101.6 (In)
unnamed: C104.1, U101.3 (Out)
unnamed: C104.2, J13.1, Q101.1 (B), R101.1
unnamed: C201.2, J14.1, Q201.1 (B), R201.1
unnamed: C301.2, R303.2, R304.1
unnamed: C302.2, R304.2, R305.1
unnamed: C303.2, J20.1, Q301.1 (B), R305.2
unnamed: D401.1 (K), R403.1
unnamed: J751.3, R751.2
unnamed: P603.11, R761.1
unnamed: Q301.2 (E), R306.2
unnamed: Q401.1 (B), R401.2
unnamed: Q401.3 (C), R402.1
unnamed: Q701.1 (B), R709.1
unnamed: Q702.1 (B), R711.1
unnamed: Q703.1 (B), R713.1
unnamed: Q704.1 (B), R715.1
unnamed: Q705.1 (B), R717.1
unnamed: Q721.1 (B), R721.1, R722.2
unnamed: Q731.1 (B), R731.1, R732.2
unnamed: Q741.1 (B), R741.1
unnamed: Q751.1 (B), R752.2
unnamed: Q811.1 (B), R811.1
unnamed: Q811.3 (C), R812.2
unnamed: Q821.1 (B), R821.1
unnamed: Q821.3 (C), R822.2
unnamed: Q831.1 (B), R831.1
unnamed: Q831.3 (C), R832.2
unnamed: Q841.1 (B), R841.1
unnamed: Q841.3 (C), R842.2
unnamed: Q851.1 (B), R851.1
unnamed: Q851.3 (C), R852.2
unnamed: Q861.1 (B), R861.1
unnamed: Q861.3 (C), R862.2
unnamed: Q871.1 (B), R871.1
unnamed: Q871.3 (C), R872.2
unnamed: R301.2, R302.1, R303.1
unnamed: R601.2, U601.7
unnamed: R602.2, U601.5
unnamed: R603.2, U601.3
unnamed: R604.2, U601.1
unnamed: R605.2, U602.7
unnamed: R606.2, U602.5
unnamed: R607.2, U602.3
unnamed: R608.2, U602.1
unnamed: R609.2, U603.7
unnamed: R610.2, U603.5
unnamed: R611.2, U603.3
unnamed: R612.2, U603.1
unnamed: R613.2, U604.1
unnamed: R614.1, U605.1
RES_PA1: J24.10, U1.18 (PA1)
RES_PA2: J24.8, U1.19 (PA2)
RES_PA3: J24.6, U1.20 (PA3)
RES_PA4: J24.4, U1.21 (PA4)
RES_PA5: J24.2, U1.22 (PA5)
RES_PB10: J24.11, U1.30 (PB10)
RES_PB11: J24.9, U1.31 (PB11)
SCAN_STOP: D501.2 (A), J17.1, R501.2, U1.13 (PC0)
STANDBY: J23.1, Q751.3 (C), R753.1, U1.62 (PB8)
SWCLK: J1.4, U1.46 (BOOT0-PA14)
SWDIO: J1.2, U1.45 (PA13)
SWO: J1.6
TUNING_VOLTAGE: J16.1, R301.1, U1.15 (PC2)
~~3.3V-L: P602.16, P604.1
~~3.3V-N.1: P604.2, U605.4
~~3.3V-N.2: P602.15, U605.3

Notes on the sheet:
DISPLAY
KEY-DECODER
STM32
FM FREQUENCY
TUNING VOLTAGE
POWER SUPPLY
STATION LEDS
MISC
AM FREQUENCY
STANDBY
CENTER-LED
FM/AM - MODE
MANUAL
MUTING
SCAN-STOP
U11 + U21: LMR14006X (LCSC: C478074) LV2841XL (LCSC: C225807)
5Vpp
1Vpp
500mVpp

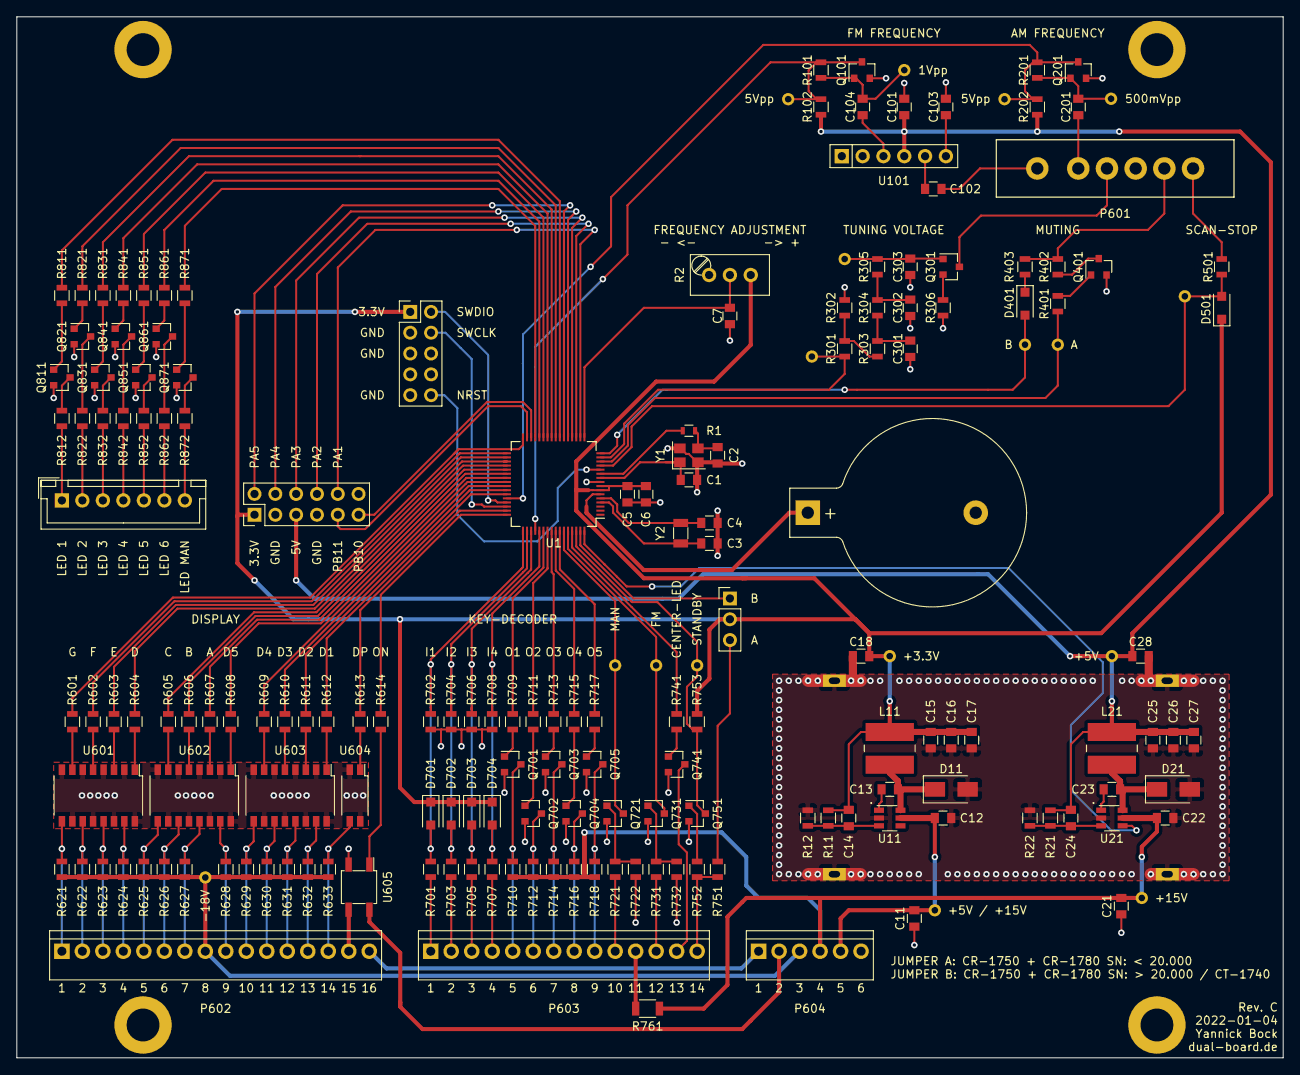
[picture p71: board synthesizer-board.kicad_pcb from above]

Board: 2 copper layers, 154.5 x 127.0 mm, 194 parts (0 on the bottom side), 164 nets.
