yannickbock/dual_cr1750_cr1780_ct1740/hardware/bluetooth-board-mounting/bluetooth-board-mounting.kicad_pcb

## KiCad design hardware/bluetooth-board-mounting/bluetooth-board-mounting.kicad_pcb (2022-03-17)

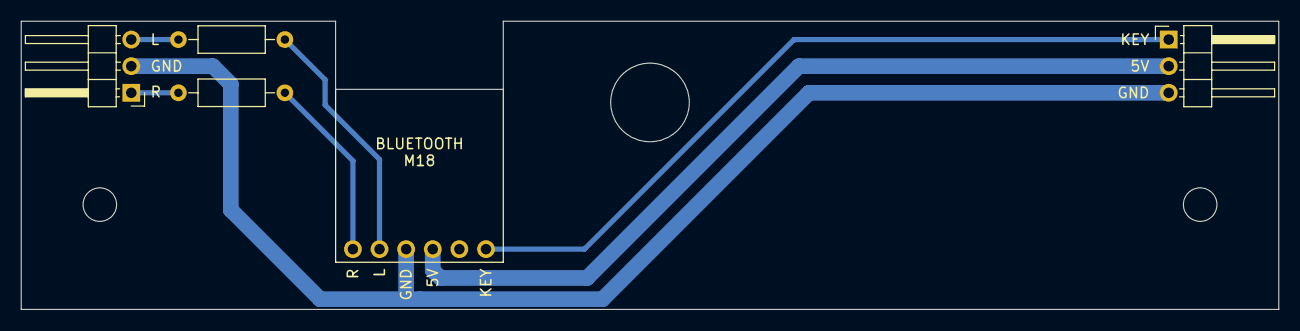
[picture p72: board bluetooth-board-mounting.kicad_pcb from above]

Board: 2 copper layers, 120.0 x 27.5 mm, 7 parts (0 on the bottom side), 7 nets.

Parts:
H1, H2: MountingHole; MountingHole_3.2mm_M3
J1: Conn_01x06; Pin_Header_Angled_1x03_Pitch2.54mm
J11: Conn_01x03; Pin_Header_Angled_1x03_Pitch2.54mm
R9, R10: 100; R_Axial_DIN0207_L6.3mm_D2.5mm_P10.16mm_Horizontal
U1: BT / M18; Pin_Header_Straight_1x06_Pitch2.54mm

Connections:
+5V: J1.2, U1.4
GND: J1.3, J11.2, U1.3
KEY: J1.1, U1.6
unnamed: R9.2, U1.2
unnamed: R10.2, U1.1
OUT_L: J11.3, R9.1
OUT_R: J11.1, R10.1
