yannickbock/dual_cr1750_cr1780_ct1740/hardware/psu-module-negative/psu-module-negative.kicad_pcb

## KiCad design hardware/psu-module-negative/psu-module-negative.kicad_pcb (2022-03-17)

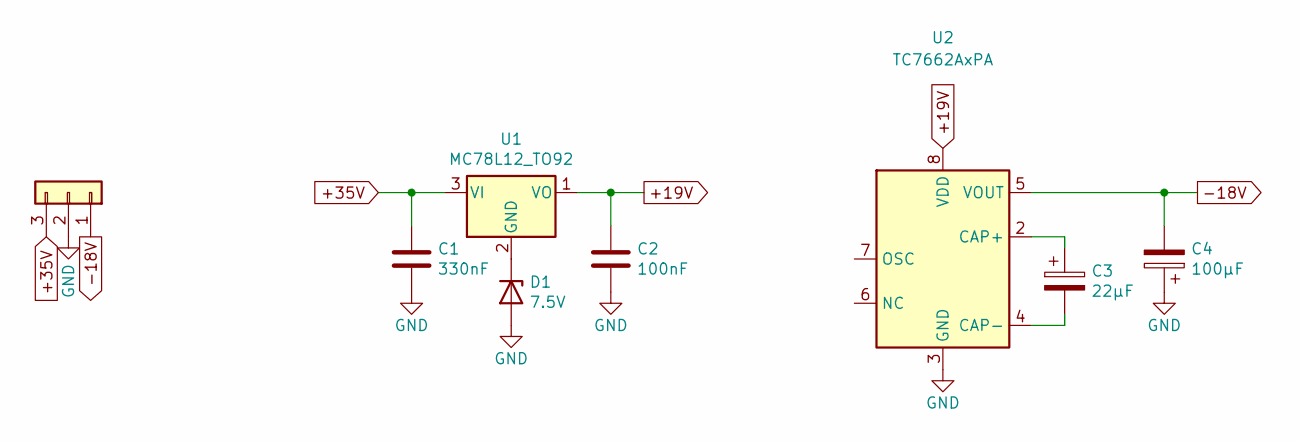
[picture p73: schematic psu-module-negative.sch]

Parts:
C1: 330nF; C_Disc_D3.0mm_W2.0mm_P2.50mm
C2: 100nF; C_Disc_D3.0mm_W2.0mm_P2.50mm
C3: 22µF; CP_Radial_D5.0mm_P2.00mm
C4: 100µF; CP_Radial_D6.3mm_P2.50mm
D1: 7.5V; D_DO-35_SOD27_P7.62mm_Horizontal
J1: Conn_01x03; Pin_Header_Angled_1x03_Pitch2.54mm
U1: MC78L12_TO92; TO-92_Molded_Narrow_Oval
U2: TC7662AxPA; DIP-8_W7.62mm

Connections:
+19V: C2.1, U1.1 (VO), U2.8 (VDD)
+35V: C1.1, J1.3, U1.3 (VI)
-18V: C4.2, J1.1, U2.5 (VOUT)
GND: C1.2, C2.2, C4.1, D1.2 (A), J1.2, U2.3 (GND)
unnamed: C3.1, U2.2 (CAP+)
unnamed: C3.2, U2.4 (CAP-)
unnamed: D1.1 (K), U1.2 (GND)

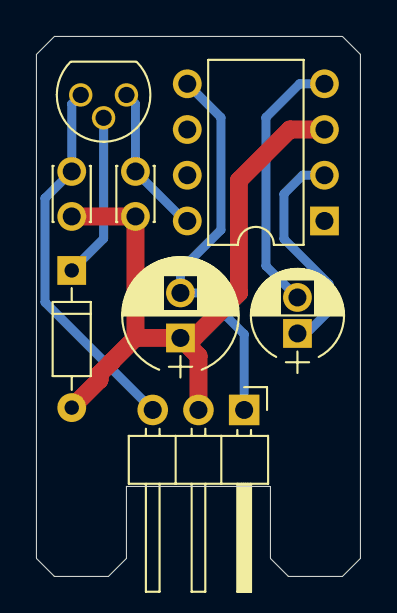
[picture p74: board psu-module-negative.kicad_pcb from above]

Board: 2 copper layers, 18.0 x 30.0 mm, 8 parts (0 on the bottom side), 7 nets.
