yannickbock/dual_cr1750_cr1780_ct1740/hardware/display-board/display-board.kicad_pcb

## KiCad design hardware/display-board/display-board.kicad_pcb (2022-03-17)

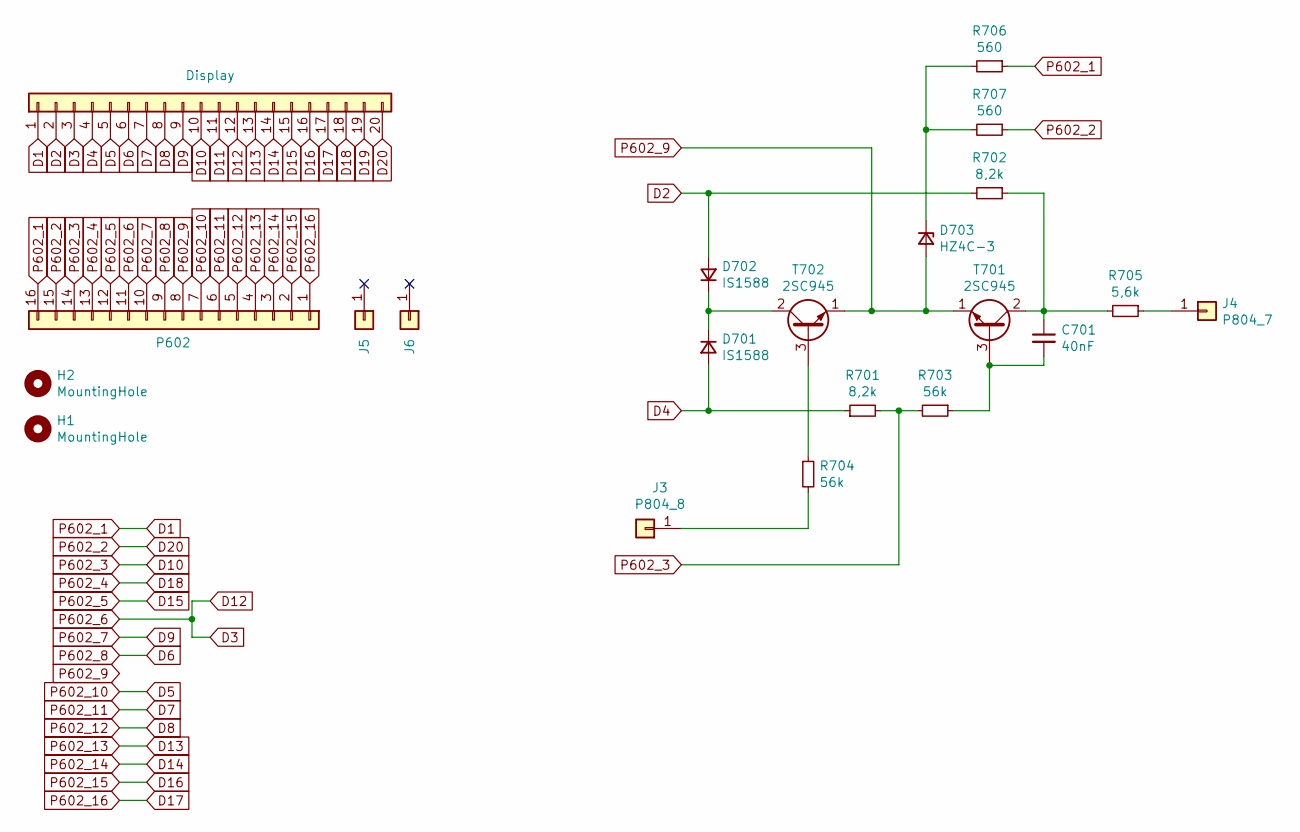
[picture p75: schematic display-board.sch]

Parts:
C701: 40nF; C_Disc_D10.0mm_W2.5mm_P5.00mm
D701, D702: IS1588; D_DO-35_SOD27_P7.62mm_Horizontal
D703: HZ4C-3; D_DO-35_SOD27_P7.62mm_Horizontal
H1, H2: MountingHole; MountingHole_2.2mm_M2
J1: Display; DISPLAY_01x20
J3: P804_8; SolderWirePad_single_1mmDrill
J4: P804_7; SolderWirePad_single_1mmDrill
J5, J6: Conn_01x01; SolderWirePad_single_1mmDrill
P602: Conn_01x16
R701, R702: 8,2k; R_Axial_DIN0207_L6.3mm_D2.5mm_P10.16mm_Horizontal
R703, R704: 56k; R_Axial_DIN0207_L6.3mm_D2.5mm_P10.16mm_Horizontal
R705: 5,6k; R_Axial_DIN0207_L6.3mm_D2.5mm_P10.16mm_Horizontal
R706, R707: 560; R_Axial_DIN0207_L6.3mm_D2.5mm_P10.16mm_Horizontal
T701, T702: 2SC945; TO-92_Inline_Wide

Connections:
D1: J1.1, P602.16, R706.1; also elsewhere on the board
D2: D702.2 (A), J1.2, R702.2
D4: D701.2 (A), J1.4, R701.1
D5: J1.5, P602.7; also elsewhere on the board
D6: J1.6, P602.9; also elsewhere on the board
D7: J1.7, P602.6; also elsewhere on the board
D8: J1.8, P602.5; also elsewhere on the board
D9: J1.9, P602.10; also elsewhere on the board
D10: J1.10, P602.14, R701.2, R703.2; also elsewhere on the board
D11: J1.11
D12: J1.3, J1.12, P602.11; also elsewhere on the board
D13: J1.13, P602.4; also elsewhere on the board
D14: J1.14, P602.3; also elsewhere on the board
D15: J1.15, P602.12; also elsewhere on the board
D16: J1.16, P602.2; also elsewhere on the board
D17: J1.17, P602.1; also elsewhere on the board
D18: J1.18, P602.13; also elsewhere on the board
D19: J1.19
D20: J1.20, P602.15, R707.1; also elsewhere on the board
unnamed: C701.1, R702.1, R705.2, T701.2 (C)
unnamed: C701.2, R703.1, T701.3 (B)
unnamed: D701.1 (K), D702.1 (K), T702.2 (C)
unnamed: D703.1 (K), R706.2, R707.2
unnamed: J3.1, R704.2
unnamed: J4.1, R705.1
unnamed: R704.1, T702.3 (B)
P602_9: D703.2 (A), P602.8, T701.1 (E), T702.1 (E); also elsewhere on the board

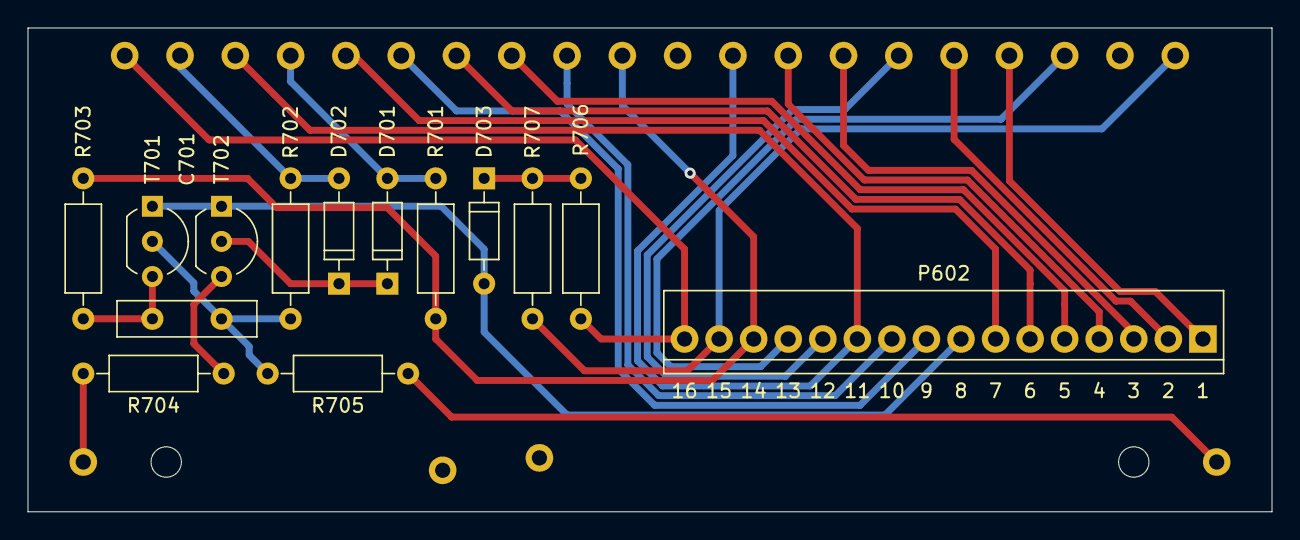
[picture p76: board display-board.kicad_pcb from above]

Board: 2 copper layers, 90.0 x 35.0 mm, 21 parts (0 on the bottom side), 25 nets.

Other parts of the board:
J2: Conn_01x16

Their connections:
D1: J2.16; also elsewhere on the board
D5: J2.7; also elsewhere on the board
D6: J2.9; also elsewhere on the board
D7: J2.6; also elsewhere on the board
D8: J2.5; also elsewhere on the board
D9: J2.10; also elsewhere on the board
D10: J2.14; also elsewhere on the board
D12: J2.11; also elsewhere on the board
D13: J2.4; also elsewhere on the board
D14: J2.3; also elsewhere on the board
D15: J2.12; also elsewhere on the board
D16: J2.2; also elsewhere on the board
D17: J2.1; also elsewhere on the board
D18: J2.13; also elsewhere on the board
D20: J2.15; also elsewhere on the board
P602_9: J2.8; also elsewhere on the board
