yannickbock/dual_cr1750_cr1780_ct1740/hardware/ct-1740-psu-board/ct-1740-psu-board.kicad_pcb

## KiCad design hardware/ct-1740-psu-board/ct-1740-psu-board.kicad_pcb (2021-12-21)

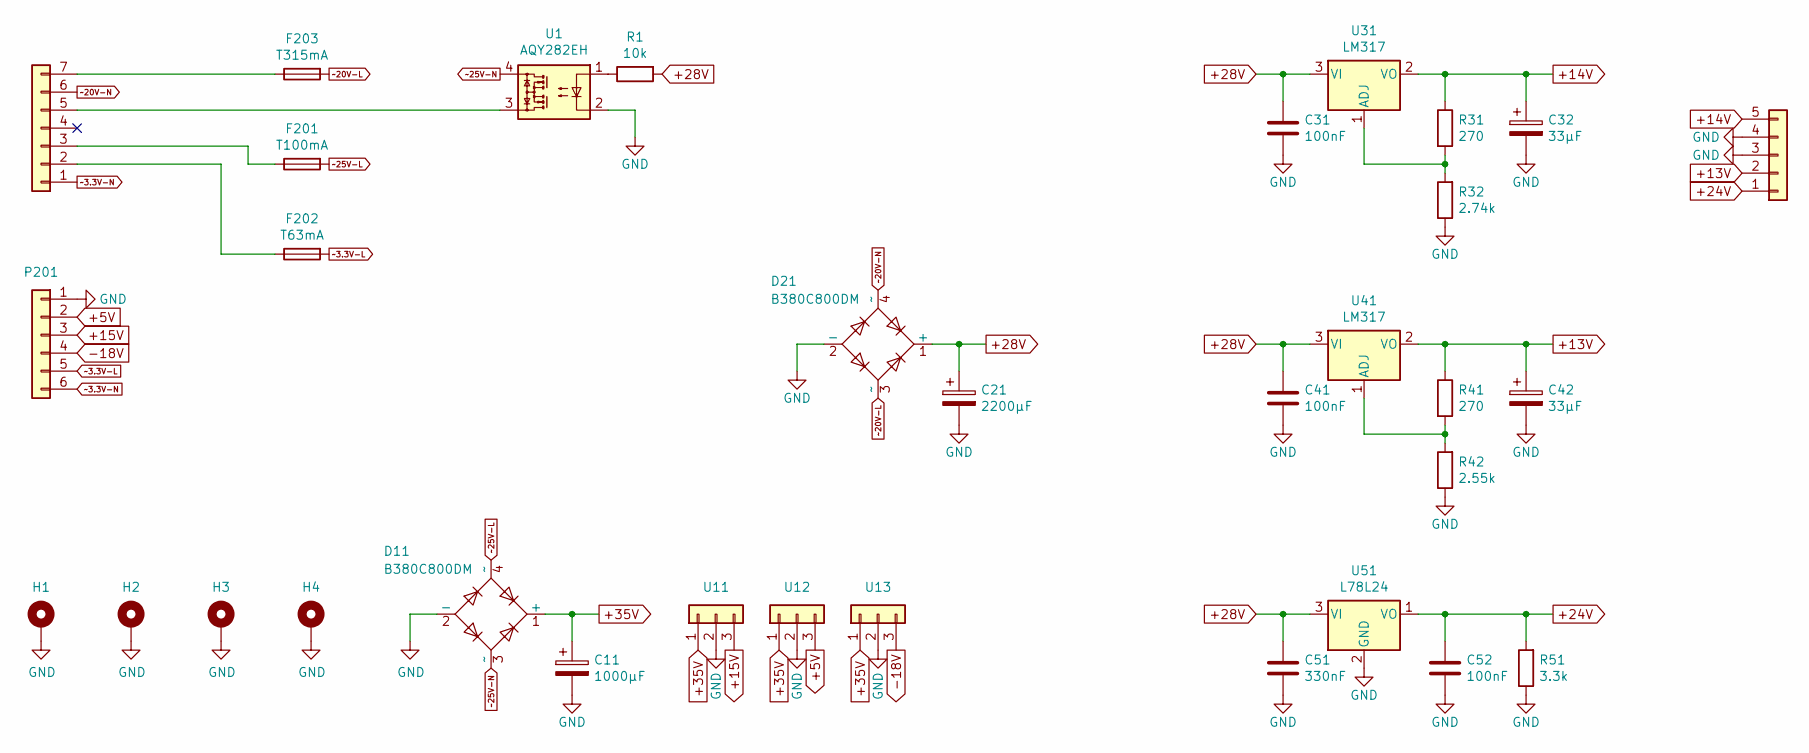
[picture p77: schematic ct-1740-psu-board.sch]

Parts:
C11: 1000µF; CP_Radial_D16.0mm_P7.50mm
C21: 2200µF; CP_Radial_D16.0mm_P7.50mm
C31, C41, C52: 100nF; C_Disc_D4.3mm_W1.9mm_P5.00mm
C32, C42: 33µF; CP_Radial_D5.0mm_P2.00mm
C51: 330nF; C_Disc_D4.3mm_W1.9mm_P5.00mm
D11, D21: B380C800DM; Diode_Bridge_DIP-4_W7.62mm_P5.08mm
F201: T100mA; Fuseholder5x20_horiz_open_inline_Type-I
F202: T63mA; Fuseholder5x20_horiz_open_inline_Type-I
F203: T315mA; Fuseholder5x20_horiz_open_inline_Type-I
H1, H2, H3, H4: MountingHole_Pad; MountingHole_4mm_Pad
J1: Conn_01x07
J3: Conn_01x05
P201: Conn_01x06
R1: 10k; R_Axial_DIN0207_L6.3mm_D2.5mm_P10.16mm_Horizontal
R31, R41: 270; R_Axial_DIN0207_L6.3mm_D2.5mm_P5.08mm_Vertical
R32: 2.74k; R_Axial_DIN0207_L6.3mm_D2.5mm_P5.08mm_Vertical
R42: 2.55k; R_Axial_DIN0207_L6.3mm_D2.5mm_P5.08mm_Vertical
R51: 3.3k; R_Axial_DIN0207_L6.3mm_D2.5mm_P10.16mm_Horizontal
U1: AQY282EH; DIP-4_W7.62mm
U11, U12, U13: Conn_01x03; TO-220-3_Vertical
U31, U41: LM317; TO-220-3_Vertical
U51: L78L24; TO-92_Inline_Wide

Connections:
+5V: P201.2, U12.3
+13V: C42.1, J3.2, R41.1, U41.2 (VO)
+14V: C32.1, J3.5, R31.1, U31.2 (VO)
+15V: P201.3, U11.3
+24V: C52.1, J3.1, R51.2, U51.1 (VO)
+28V: C21.1, C31.1, C41.1, C51.1, D21.1 (+), R1.2, U31.3 (VI), U41.3 (VI), U51.3 (VI)
+35V: C11.1, D11.1 (+), U11.1, U12.1, U13.1
-18V: P201.4, U13.3
GND: C11.2, C21.2, C31.2, C32.2, C41.2, C42.2, C51.2, C52.2, D11.2 (-), D21.2 (-), H1.1, H2.1, H3.1, H4.1, J3.3, J3.4, P201.1, R32.1, R42.1, R51.1, U1.2, U11.2, U12.2, U13.2, U51.2 (GND)
unnamed: F201.1, J1.3
unnamed: F202.1, J1.2
unnamed: F203.1, J1.7
unnamed: J1.5, U1.3
unnamed: R1.1, U1.1
unnamed: R31.2, R32.2, U31.1 (ADJ)
unnamed: R41.2, R42.2, U41.1 (ADJ)
~~3.3V-L: F202.2, P201.5
~~3.3V-N: J1.1, P201.6
~~20V-L: D21.3 (~~), F203.2
~~20V-N: D21.4 (~~), J1.6
~~25V-L: D11.4 (~~), F201.2
~~25V-N: D11.3 (~~), U1.4

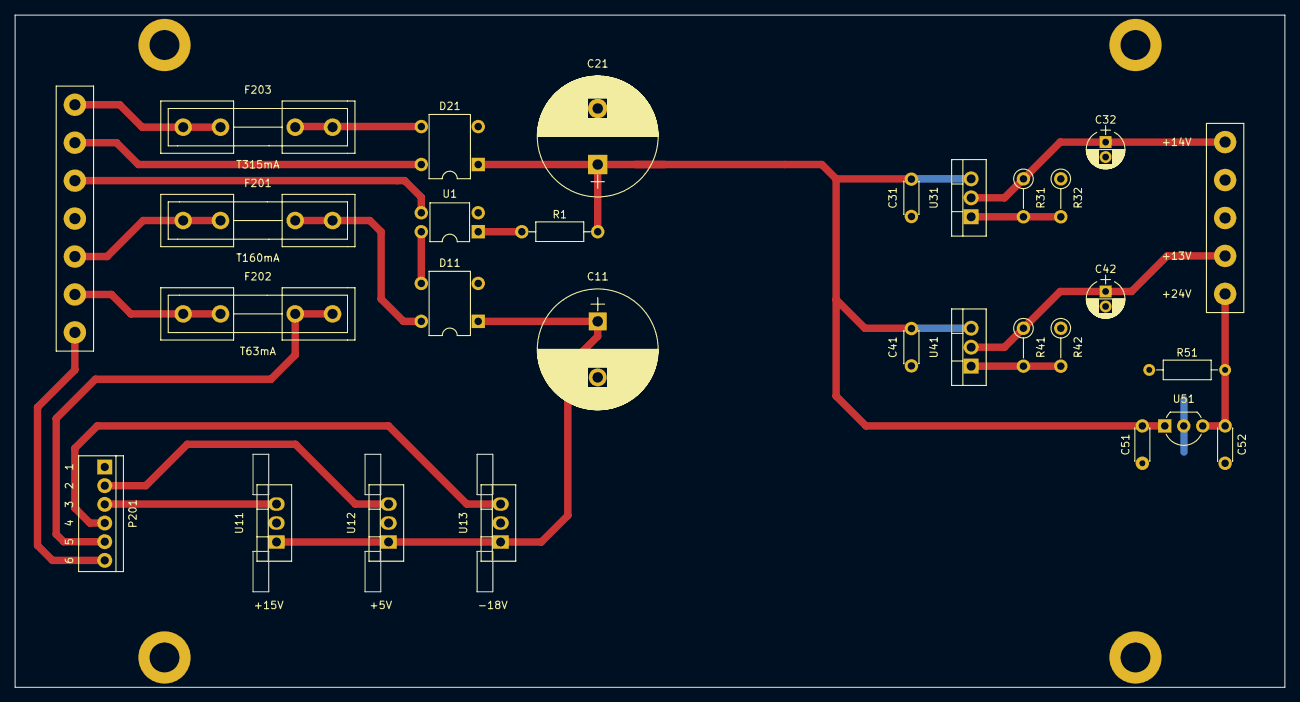
[picture p78: board ct-1740-psu-board.kicad_pcb from above]

Board: 2 copper layers, 170.0 x 90.0 mm, 33 parts (0 on the bottom side), 22 nets.
