yannickbock/dual_cr1750_cr1780_ct1740/firmware/synthesizer-board/Core/Src/main.c

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
/* Includes ------------------------------------------------------------------*/
#include "main.h"

/* USER CODE BEGIN Includes */
#include <math.h>
#include <string.h>
#include <stdbool.h>
#include <stdlib.h>

#include "display.h"
#include "station.h"
#include "keydecoder.h"
#include "misc.h"

/* USER CODE END Includes */

ADC_HandleTypeDef hadc1;

RTC_HandleTypeDef hrtc;

TIM_HandleTypeDef htim1;
TIM_HandleTypeDef htim3;
TIM_HandleTypeDef htim6;
TIM_HandleTypeDef htim7;
TIM_HandleTypeDef htim14;
TIM_HandleTypeDef htim15;
TIM_HandleTypeDef htim16;

/* USER CODE BEGIN PV */
RTC_TimeTypeDef TIME = {0};
RTC_DateTypeDef DATE = {0};

int a = 4250;

double FREQUENCY_CALIBRATION = 0.9975;
int FM_FREQUENCY = 8750;
int FM_FREQUENCY_COUNTER = 0;
bool FM_FREQUENCY_COUNTER_UPDATED = false;

Mode MODE = OTHER;
bool CLOCK = false;
int STATION = -1;
bool BLUETOOTH = false;
bool BLUETOOTH_ON = false;

bool STANDBY = true;
bool STANDBY_DISPLAY_ON = true;

bool SET_BUTTON = false;
bool MEMORY_BUTTON = false;

bool LOCK_FREQUENCY = true;
bool SCAN_STOP = false;

int AM_FREQUENCY = 531;
int AM_FREQUENCY_COUNTER = 0;

int OFF_COUNTER = 0;
bool COLD_START = true;


int calculateFMFrequencyControlCounterPeriod(bool fastMode)
{
	// PFUI!
	int fm_difference = abs(FM_FREQUENCY - FM_FREQUENCY_COUNTER);

	int arr = 0;
	if (fastMode)
	{
		arr = 2500 - 500 * fm_difference;
		arr = arr < 250 ? 250 : arr;
	}
	else
	{
		arr = 3500 - abs(1.05 + 0.05 * fm_difference + 0.75 * exp(fm_difference));
		arr = arr < 250 ? 250 : arr;
	}

	return arr;
}

int calculateFMFrequencyControlCounterPrescaler(bool fastMode)
{
	// PFUI!
	double psc = 5000 - ((4 * FM_FREQUENCY_COUNTER) / 9);//4200 - 0.3675 * FM_FREQUENCY_COUNTER;
	if (fastMode)
	{
		psc = psc / 2;
		psc = psc < 110 ? 110 : psc;
	}
	else
	{
		psc = psc * 2.75;
	}

	return psc;
}

void stopFrequencyControl()
{
	HAL_TIM_Base_Stop_IT(&htim14);
}

void startFrequencyControl()
{
	HAL_TIM_Base_Start_IT(&htim14);
}

void HAL_TIM_PeriodElapsedCallback(TIM_HandleTypeDef *htim)
{
	if (htim->Instance == TIM6)
	{
		// 64 = PRESCALER / 7 = DEPENDING ON CPU-FREQUENCY / 10.7 MHz = IF
		FM_FREQUENCY_COUNTER = (((TIM3->CNT * 64 * 7 * FREQUENCY_CALIBRATION) - 1070000) / 1000.0);
		FM_FREQUENCY_COUNTER_UPDATED = true;

		TIM3->CNT = 0;
		TIM6->CNT = 0;
	}

	if (htim->Instance == TIM16)
	{
		// 7 = DEPENDING ON CPU-FREQUENCY / 455 kHz = IF
		AM_FREQUENCY_COUNTER = ((TIM1->CNT * 7 * FREQUENCY_CALIBRATION) / 100.0) - 455;

		TIM1->CNT = 0;
		TIM16->CNT = 0;
	}
	else if (htim->Instance == TIM7)
	{
		int display_value = 0;
		if (CLOCK)
		{
			if (!SET_BUTTON)
			{
				HAL_RTC_GetTime(&hrtc, &TIME, RTC_FORMAT_BIN);
				HAL_RTC_GetDate(&hrtc, &DATE, RTC_FORMAT_BIN);
			}

			display_value = TIME.Hours*100 + TIME.Minutes;
		}
		else if (MODE == FM)
		{
			display_value = SET_BUTTON && !CLOCK ? FM_FREQUENCY_COUNTER : FM_FREQUENCY;
		}
		else
		{
			display_value = SET_BUTTON && !CLOCK ? AM_FREQUENCY_COUNTER : AM_FREQUENCY;
		}

		if (OFF_COUNTER > 0)
		{
			display_show_off();
			OFF_COUNTER -= 1;
		}
		else if (!CLOCK && MODE == AM && BLUETOOTH && STATION == 0)
		{
			display_show_bluetooth();
		}
		else
		{
			display(display_value, (CLOCK && TIME.Seconds %2 == 1) || (!CLOCK && MODE == FM));
		}
	}
	else if (htim->Instance == TIM14)
	{
		if (MODE == FM)
		{
			TIM14->PSC = calculateFMFrequencyControlCounterPrescaler(!LOCK_FREQUENCY);
			TIM14->ARR = calculateFMFrequencyControlCounterPeriod(true);

			SCAN_STOP = !SCAN_STOP ? HAL_GPIO_ReadPin(GPIOC, SCAN_STOP_Pin) : true;

			if (TIM15->CCR2 < TIM15->ARR && FM_FREQUENCY < FM_FREQUENCY_COUNTER)
			{
				TIM15->CCR2++;
			}
			else if (TIM15->CCR2 > 0 && FM_FREQUENCY > FM_FREQUENCY_COUNTER)
			{
				TIM15->CCR2--;
			}

			// SCAN EMERGENCY-STOP
			if ((TIM15->CCR2 == 0) || (TIM15->CCR2 == TIM15->ARR))
			{
				FM_FREQUENCY = ((int)(FM_FREQUENCY_COUNTER / 10)) * 10;
				SCAN_STOP = true;
			}
		}
		else if (MODE == AM)
		{
			int am_difference = abs(AM_FREQUENCY - AM_FREQUENCY_COUNTER);
			int arr = 1500 - 175 * am_difference;
			int psc = 3500 - 0.5 * AM_FREQUENCY_COUNTER;
			TIM14->PSC = psc < 150 ? 150 : psc;
			TIM14->ARR = arr < 50 ? 50 : arr;

			if (TIM15->CCR2 < TIM15->ARR && AM_FREQUENCY < AM_FREQUENCY_COUNTER)
			{
				TIM15->CCR2++;
			}
			else if (TIM15->CCR2 > 0 && AM_FREQUENCY > AM_FREQUENCY_COUNTER)
			{
				TIM15->CCR2--;
			}
		}
	}
}

/* USER CODE END PV */

void SystemClock_Config(void);
static void MX_GPIO_Init(void);
static void MX_ADC1_Init(void);
static void MX_TIM1_Init(void);
static void MX_TIM3_Init(void);
static void MX_TIM6_Init(void);
static void MX_TIM14_Init(void);
static void MX_TIM7_Init(void);
static void MX_RTC_Init(void);
static void MX_TIM15_Init(void);
static void MX_TIM16_Init(void);
/* USER CODE BEGIN 0 */
void saveFMStation()
{
	uint32_t dc = TIM15->CCR2;
	HAL_Delay(100);
	station_fm_set(STATION, FM_FREQUENCY, dc);
}

void saveAMStation()
{
	station_am_set(STATION, AM_FREQUENCY, TIM15->CCR2);
}

void setStation(int number, bool force)
{
	station_led(number);

	Mode mode = misc_get_mode(AM_FREQUENCY_COUNTER);
	bool modeChangedToFM = mode == FM && MODE != FM;
	bool modeChangedToAM = mode == AM && MODE != AM;

	if (modeChangedToFM || MODE == FM && (STATION != number || force))
	{
		setFMStation(number);
	}
	else if (modeChangedToAM || MODE == AM && (STATION != number || force))
	{
		setAMStation(number);
	}
}

void setFMStation(int number)
{
	STATION = number;
	misc_mute(true);

	stopFrequencyControl();
	struct Station station = station_fm_get(number);
	FM_FREQUENCY = station.Frequency;
	TIM15->CCR2 = station.DutyCycle;

	HAL_GPIO_WritePin(GPIOB, CENTER_LED_Pin, GPIO_PIN_SET);

	FM_FREQUENCY_COUNTER_UPDATED = false;
	while (!FM_FREQUENCY_COUNTER_UPDATED);
	FM_FREQUENCY_COUNTER_UPDATED = false;

	startFrequencyControl();

	int i = 0;
	LOCK_FREQUENCY = false;
	for(; i < 500 && abs(FM_FREQUENCY - FM_FREQUENCY_COUNTER) > 2; i++)
	{
		HAL_Delay(1);
	}
	LOCK_FREQUENCY = true;


	HAL_Delay(500 - i);
	misc_mute(false);
	HAL_GPIO_WritePin(GPIOB, CENTER_LED_Pin, GPIO_PIN_RESET);
}

void setAMStation(int number)
{
	STATION = number;
	misc_mute(true);

	struct Station station = station_am_get(number);
	AM_FREQUENCY = station.Frequency;
	TIM15->CCR2 = station.DutyCycle;

	HAL_Delay(500);
	misc_mute(false);
}

double getCalibrationValue()
{
	uint32_t y = 0;

	for (int i = 0; i < 5; i++)
	{
		HAL_ADC_Start(&hadc1);
		HAL_ADC_PollForConversion(&hadc1, HAL_MAX_DELAY);
		int x = HAL_ADC_GetValue(&hadc1);

		y += x / 5;
	}

	// +/- 0.5%
	double value = 0.995 + 0.000002442 * y;

	return value;
}

void enable_5volt(bool on)
{
	HAL_GPIO_WritePin(GPIOC, DISABLE_5V_Pin, on);
}

/* USER CODE END 0 */

/**
  * @brief  The application entry point.
  * @retval int
  */
int main(void)
{
  /* MCU Configuration--------------------------------------------------------*/

  /* Reset of all peripherals, Initializes the Flash interface and the Systick. */
  HAL_Init();

  /* Configure the system clock */
  SystemClock_Config();

  /* Initialize all configured peripherals */
  MX_GPIO_Init();
  MX_ADC1_Init();
  MX_TIM1_Init();
  MX_TIM3_Init();
  MX_TIM6_Init();
  MX_TIM14_Init();
  MX_TIM7_Init();
  MX_RTC_Init();
  MX_TIM15_Init();
  MX_TIM16_Init();
  /* USER CODE BEGIN 2 */
  misc_mute(true);

  HAL_TIM_Base_Start(&htim1); 					// AM FRECQUENCY ETR
  HAL_TIM_Base_Start(&htim3); 					// FM FRECQUENCY ETR
  HAL_TIM_Base_Start_IT(&htim6); 				// FM FRECQUENCY COUNT PERIOD
  HAL_TIM_Base_Start_IT(&htim16); 				// AM FRECQUENCY COUNT PERIOD
  HAL_TIM_Base_Start_IT(&htim7);				// DISPLAY MULTIPLEXING
  HAL_TIM_PWM_Start(&htim15, TIM_CHANNEL_2); 	// TUNING VOLTAGE PWM
  startFrequencyControl();

  display_on(true);
  enable_5volt(true);
  MODE = misc_get_mode(AM_FREQUENCY_COUNTER);
  BLUETOOTH = misc_bt_is_present();
  /* USER CODE END 2 */

  /* Infinite loop */
  /* USER CODE BEGIN WHILE */
  while (1)
  {
	  FREQUENCY_CALIBRATION = getCalibrationValue();

	  bool standby = misc_is_standby();
	  bool poweredOn = STANDBY && !standby;
	  bool poweredOff = !STANDBY && standby;
	  if (poweredOn)
	  {
		  STANDBY = false;
		  OFF_COUNTER = 0;
		  enable_5volt(true);
		  display_on(true);
		  startFrequencyControl();

		  // Standby detection is delayed, set station again to prevent timer duty cycle drift.
		  setStation(STATION, true);
	  }
	  else if (poweredOff)
	  {
		  STANDBY = true;

		  if (COLD_START)
		  {
			  OFF_COUNTER = 1000;
			  COLD_START = false;
		  }

		  enable_5volt(false);
		  display_on(STANDBY_DISPLAY_ON);
		  stopFrequencyControl();
	  }

	  Mode mode = misc_get_mode(AM_FREQUENCY_COUNTER);
	  bool modeChangedToOther = mode == OTHER && MODE != OTHER;
	  bool modeChangedToFMorAM = (mode == FM && MODE != FM) || (mode == AM && MODE != AM);
	  MODE = mode;

	  if (modeChangedToOther)
	  {
		  stopFrequencyControl();
	  }
	  else if (modeChangedToFMorAM)
	  {
		  // Mode detection is delayed, set station again to prevent timer duty cycle drift.
		  setStation(STATION, true);
		  startFrequencyControl();
	  }

	  keydecoder_out(1);
	  CLOCK = keydecoder_in(1);
	  SET_BUTTON = keydecoder_in(2);

	  keydecoder_out(2);
	  if (!STANDBY && keydecoder_in(2) && keydecoder_in(3))
	  {
		  // TUNING UP QUICK
		  LOCK_FREQUENCY = false;
		  if (MODE == FM && FM_FREQUENCY < 10800)
		  {
			  FM_FREQUENCY += 5;
			  HAL_Delay(30);
		  }
		  else if (MODE == AM && AM_FREQUENCY < 1602 && !BLUETOOTH)
		  {
			  AM_FREQUENCY += 9;
			  HAL_Delay(50);
		  }
		  else if (MODE == AM && BLUETOOTH && STATION == 0)
		  {
			  misc_bt_pause();
		  }
		  LOCK_FREQUENCY = true;
	  }
	  else if (!STANDBY && keydecoder_in(2) && keydecoder_in(4))
	  {
		  // TUNING DOWN QUICK
		  LOCK_FREQUENCY = false;
		  if (MODE == FM && FM_FREQUENCY > 8750)
		  {
			  FM_FREQUENCY -= 5;
			  HAL_Delay(30);
		  }
		  else if (MODE == AM && AM_FREQUENCY > 531 && !BLUETOOTH)
		  {
			  AM_FREQUENCY -= 9;
			  HAL_Delay(50);
		  }
		  else if (MODE == AM && BLUETOOTH && STATION == 0)
		  {
			  misc_bt_pause();
		  }
		  LOCK_FREQUENCY = true;
	  }
	  else if (!STANDBY && keydecoder_in(1))
	  {
		  // SCAN DOWN
		  if (MODE == FM)
		  {
			  misc_mute(true);
			  LOCK_FREQUENCY = false;

			  for (int i = 0; i < 2 && FM_FREQUENCY > 8750; i++)
			  {
				  FM_FREQUENCY -= 5;
				  HAL_Delay(20);
				  while ((abs(FM_FREQUENCY_COUNTER - FM_FREQUENCY)) > 4);
			  }

			  SCAN_STOP = false;

			  do
			  {
				  FM_FREQUENCY -= 5;
				  HAL_Delay(20);
				  while ((abs(FM_FREQUENCY_COUNTER - FM_FREQUENCY)) > 4);
			  } while (!SCAN_STOP && FM_FREQUENCY > 8750);

			  if (FM_FREQUENCY % 10 == 5)
			  {
				  FM_FREQUENCY += 5;
			  }

			  HAL_Delay(250);
			  LOCK_FREQUENCY = true;
			  misc_mute(false);
		  }
	  }
	  else if (!STANDBY && keydecoder_in(2))
	  {
		  // SCAN UP
		  if (MODE == FM)
		  {
			  misc_mute(true);
			  LOCK_FREQUENCY = false;

			  for (int i = 0; i < 2 && FM_FREQUENCY < 10800; i++)
			  {
				  FM_FREQUENCY += 5;
				  HAL_Delay(20);
				  while ((abs(FM_FREQUENCY_COUNTER - FM_FREQUENCY)) > 4);
			  }

			  SCAN_STOP = false;

			  do
			  {
				  FM_FREQUENCY += 5;
				  HAL_Delay(20);
				  while ((abs(FM_FREQUENCY_COUNTER - FM_FREQUENCY)) > 4);
			  } while (!SCAN_STOP && FM_FREQUENCY < 10800);

			  if (FM_FREQUENCY % 10 == 5)
			  {
				  FM_FREQUENCY -= 5;
			  }

			  HAL_Delay(250);
			  LOCK_FREQUENCY = true;
			  misc_mute(false);
		  }
	  }
	  else if (!STANDBY && keydecoder_in(3))
	  {
		  // TUNING UP
		  if (MODE == FM && FM_FREQUENCY < 10800)
		  {
			  FM_FREQUENCY += 5;
			  HAL_Delay(200);
		  }
		  else if (MODE == AM && AM_FREQUENCY < 1602 && !BLUETOOTH)
		  {
			  AM_FREQUENCY += 9;
			  HAL_Delay(200);
		  }
		  else if (MODE == AM && BLUETOOTH && STATION == 0)
		  {
			  misc_bt_next();
		  }
	  }
	  else if (!STANDBY && keydecoder_in(4))
	  {
		  // TUNING DOWN
		  if (MODE == FM && FM_FREQUENCY > 8750)
		  {
			  FM_FREQUENCY -= 5;
			  HAL_Delay(200);
		  }
		  else if (MODE == AM && AM_FREQUENCY > 531 && !BLUETOOTH)
		  {
			  AM_FREQUENCY -= 9;
			  HAL_Delay(200);
		  }
		  else if (MODE == AM && BLUETOOTH && STATION == 0)
		  {
			  misc_bt_prev();
		  }
	  }

	  keydecoder_out(3);
	  if (CLOCK && SET_BUTTON && keydecoder_in(1))
	  {
		  // MIN
		  HAL_RTC_GetTime(&hrtc, &TIME, RTC_FORMAT_BIN);
		  HAL_RTC_GetDate(&hrtc, &DATE, RTC_FORMAT_BIN);

		  if (TIME.Minutes == 59)
		  {
			  TIME.Minutes = 0;
		  }
		  else
		  {
			  TIME.Minutes++;
		  }

		  HAL_Delay(200);
		  HAL_RTC_SetTime(&hrtc, &TIME, RTC_FORMAT_BIN);
	  }
	  else if (CLOCK && SET_BUTTON && keydecoder_in(2))
	  {
		  // HOURS
		  HAL_RTC_GetTime(&hrtc, &TIME, RTC_FORMAT_BIN);
		  HAL_RTC_GetDate(&hrtc, &DATE, RTC_FORMAT_BIN);

		  if (TIME.Hours == 23)
		  {
			  TIME.Hours = 0;
		  }
		  else
		  {
			  TIME.Hours++;
		  }

		  HAL_Delay(200);
		  HAL_RTC_SetTime(&hrtc, &TIME, RTC_FORMAT_BIN);
	  }
	  else if (keydecoder_in(3))
	  {
		  // MEMORY
		  if (!STANDBY && !MEMORY_BUTTON && MODE == FM)
		  {
			  saveFMStation();
			  MEMORY_BUTTON = true;
		  }
		  else if (!STANDBY && !MEMORY_BUTTON && MODE == AM)
		  {
			  saveAMStation();
			  MEMORY_BUTTON = true;
		  }
		  else if (STANDBY)
		  {
			  STANDBY_DISPLAY_ON = !STANDBY_DISPLAY_ON;
			  display_on(STANDBY_DISPLAY_ON);
			  HAL_Delay(500);
		  }
	  }
	  else if (!keydecoder_in(3))
	  {
		  MEMORY_BUTTON = false;
	  }

	  keydecoder_out(4);
	  if (!STANDBY && keydecoder_in(2))
	  {
		  // S3
		  setStation(3, false);
	  }
	  else if (!STANDBY && keydecoder_in(3))
	  {
		  // S2
		  setStation(2, false);
	  }
	  else if (!STANDBY && keydecoder_in(4))
	  {
		  // S1
		  setStation(1, false);
	  }

	  keydecoder_out(5);
	  if (!STANDBY && keydecoder_in(2))
	  {
		  // S6
		  setStation(6, false);
	  }
	  else if (!STANDBY && keydecoder_in(3))
	  {
		  // S5
		  setStation(5, false);
	  }
	  else if (!STANDBY && keydecoder_in(4))
	  {
		  // S4
		  setStation(4, false);
	  }

	  // If station buttons are broken and do not lock properly set MAN as default.
	  if (misc_is_manual() || STATION == -1)
	  {
		  setStation(0, false);
	  }

	  if (BLUETOOTH && MODE == AM && STATION == 0)
	  {
		  misc_mute(true);

		  if (!BLUETOOTH_ON)
		  {
			  misc_bt_on();
			  BLUETOOTH_ON = true;
		  }
	  }
	  else if (BLUETOOTH && (MODE != AM || MODE == AM && STATION != 0))
	  {
		  if (BLUETOOTH_ON)
		  {
			  misc_bt_off();
			  BLUETOOTH_ON = false;
		  }
	  }


    /* USER CODE END WHILE */

    /* USER CODE BEGIN 3 */
  }
  /* USER CODE END 3 */
}

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
