yannickbock/dual_cr1750_cr1780_ct1740/firmware/synthesizer-board/Core/Src/display.c

#include "display.h"

static ticks = 0;

void display_on(bool on)
{
	HAL_GPIO_WritePin(GPIOC, DISPLAY_ON_Pin, on);

	display_d1(on);
	display_d2(on);
	display_d3(on);
	display_d4(on);
	display_d5(on);

	display_number(-1, false);
}

void display_d1(bool on)
{
	HAL_GPIO_WritePin(GPIOA, DISPLAY_D1_Pin, on);
}

void display_d2(bool on)
{
	HAL_GPIO_WritePin(GPIOA, DISPLAY_D2_Pin, on);
}

void display_d3(bool on)
{
	HAL_GPIO_WritePin(GPIOD, DISPLAY_D3_Pin, on);
}

void display_d4(bool on)
{
	HAL_GPIO_WritePin(GPIOD, DISPLAY_D4_Pin, on);
}

void display_d5(bool on)
{
	HAL_GPIO_WritePin(GPIOC, DISPLAY_D5_Pin, on);
}

void display_a(bool on)
{
	HAL_GPIO_WritePin(GPIOC, DISPLAY_A_Pin, on);
}

void display_b(bool on)
{
	HAL_GPIO_WritePin(GPIOA, DISPLAY_B_Pin, on);
}

void display_c(bool on)
{
	HAL_GPIO_WritePin(GPIOA, DISPLAY_C_Pin, on);
}

void display_d(bool on)
{
	HAL_GPIO_WritePin(GPIOB, DISPLAY_D_Pin, on);
}

void display_e(bool on)
{
	HAL_GPIO_WritePin(GPIOB, DISPLAY_E_Pin, on);
}

void display_f(bool on)
{
	HAL_GPIO_WritePin(GPIOB, DISPLAY_F_Pin, on);
}

void display_g(bool on)
{
	HAL_GPIO_WritePin(GPIOB, DISPLAY_G_Pin, on);
}

void display_dp(bool on)
{
	HAL_GPIO_WritePin(GPIOA, DISPLAY_DP_Pin, on);
}

void display_number(uint8_t number, bool dot)
{
	switch (number)
	{
		case 0:
			display_a(true);
			display_b(true);
			display_c(true);
			display_d(true);
			display_e(true);
			display_f(true);
			display_g(false);
			break;
		case 1:
			display_a(false);
			display_b(true);
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
			display_d4(true);
			display_d5(false);
			display_number(18, false);
		}
		if (ticks == 5)
		{
			display_d1(false);
			display_d2(false);
			display_d3(false);
			display_d4(false);
			display_d5(true);
			display_number(14, false);
		}

		if (ticks == 5)
		{
			ticks = 0;
		}
		ticks++;
}
