yannickbock/dual_cr1750_cr1780_ct1740/(commit log)

2021-11-16 Rev. A
    [cr-17xx-psu-board-B_Cu.gbr, cr-17xx-psu-board-B_Mask.gbr, cr-17xx-psu-board-B_Paste.gbr, cr-17xx-psu-board-B_SilkS.gbr, cr-17xx-psu-board-Edge_Cuts.gbr, cr-17xx-psu-board-F_Cu.gbr, cr-17xx-psu-board-F_Mask.gbr, cr-17xx-psu-board-F_Paste.gbr]
2021-12-21 Rev. B
    [MS544-10S.step, cr-17xx-psu-board.kicad_pcb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]
2022-03-17 Rev. C: Hardware
    [User Library-Clips FH-100 with fuse 5x20.STEP, User Library-Custom standoff 1.STEP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]
